WaiveCar/WaiveTelem/Hardware/7-23pinlist.xlsx

Sheet: pinlist
Pinlist
Exported from 001000-004.sch at 7/23/2019 9:50 AM
EAGLE Version 9.4.0 Copyright (c) 1988-2019 Autodesk | Inc.
Part | Pad | Pin | Dir | Net
C1 | 1 | 1 | io | GND
 | 2 | 2 | io | +12V
C2 | 1 | 1 | io | N$6
 | 2 | 2 | io | N$5
C3 | 1 | 1 | io | GND
 | 2 | 2 | io | N$7
C4 | 1 | 1 | io | GND
 | 2 | 2 | io | N$8
C5 | 1 | 1 | io | GND
 | 2 | 2 | io | N$11
C6 | 1 | 1 | io | GND
 | 2 | 2 | io | VIN
C7 | 1 | - | io | N$12
 | 2 | + | io | GND
C8 | 1 | 1 | io | GND
 | 2 | 2 | io | +3V3
C9 | 1 | 1 | io | GND
 | 2 | 2 | io | +3V8
C10 | 1 | 1 | io | GND
 | 2 | 2 | io | +12V
C11 | 1 | 1 | io | GND
 | 2 | 2 | io | VIN
C12 | 1 | 1 | io | GND
 | 2 | 2 | io | +12V
C13 | 1 | 1 | io | GND
 | 2 | 2 | io | +12V
C14 | 1 | 1 | io | GND
 | 2 | 2 | io | +3V8
C15 | 1 | 1 | io | GND
 | 2 | 2 | io | +3V8
C16 | 1 | 1 | io | GND
 | 2 | 2 | io | PA00_XIN32
C17 | 1 | 1 | io | GND
 | 2 | 2 | io | PA01_XOUT32
C18 | 1 | 1 | io | GND
 | 2 | 2 | io | +3V3
C19 | 1 | 1 | io | GND
 | 2 | 2 | io | +3V3
C20 | 1 | 1 | io | GND
 | 2 | 2 | io | N$1
C21 | 1 | 1 | io | GND
 | 2 | 2 | io | N$1
C22 | 1 | 1 | io | GND
 | 2 | 2 | io | +3V8
C23 | 1 | 1 | io | GND
 | 2 | 2 | io | +3V8
C24 | 1 | 1 | io | GND
 | 2 | 2 | io | +3V8
C25 | 1 | 1 | io | GND
 | 2 | 2 | io | +3V8
C26 | 1 | 1 | io | GND
 | 2 | 2 | io | +3V8
C27 | 1 | 1 | io | GND
 | 2 | 2 | io | SVCC
C28 | 1 | 1 | io | GND
 | 2 | 2 | io | +3V8
C29 | 1 | 1 | io | N$26
 | 2 | 2 | io | GND
C30 | 1 | 1 | io | +3V3
 | 2 | 2 | io | GND
C31 | 1 | 1 | io | GND
 | 2 | 2 | io | +3V3
C32 | 1 | 1 | io | GND
 | 2 | 2 | io | +3V3
C33 | 1 | 1 | io | GND
 | 2 | 2 | io | +3V3
C34 | 1 | 1 | io | GND
 | 2 | 2 | io | +3V3
C35 | 1 | 1 | io | VIN
 | 2 | 2 | io | GND
C36 | 1 | 1 | io | +3V3
 | 2 | 2 | io | GND
C37 | 1 | 1 | io | +3V3
 | 2 | 2 | io | GND
C38 | 1 | 1 | io | N$16
 | 2 | 2 | io | N$20
C39 | 1 | 1 | io | GND
 | 2 | 2 | io | +12V
C40 | 1 | 1 | io | GND
 | 2 | 2 | io | N$40
C41 | 1 | 1 | io | N$2
 | 2 | 2 | io | N$43
C42 | 1 | 1 | io | N$43
 | 2 | 2 | io | M_ANT_OUT
C43 | 1 | 1 | io | N$37
 | 2 | 2 | io | GND
C44 | 1 | 1 | io | +1V8
 | 2 | 2 | io | GND
C45 | 1 | 1 | io | GND
 | 2 | 2 | io | +3V3
C46 | 1 | 1 | io | GND
 | 2 | 2 | io | SRST
C47 | 1 | 1 | io | GND
 | 2 | 2 | io | SIO
C48 | 1 | 1 | io | GND
 | 2 | 2 | io | SCLK
C49 | 1 | 1 | io | GND
 | 2 | 2 | io | SVCC
C50 | 1 | 1 | io | +3V3
 | 2 | 2 | io | GND
C51 | 1 | 1 | io | RESETN
 | 2 | 2 | io | +3V3
C52 | 1 | 1 | io | +3V3
 | 2 | 2 | io | GND
C53 | 1 | 1 | io | +3V3
 | 2 | 2 | io | GND
C54 | 1 | 1 | io | GND
 | 2 | 2 | io | +3V3
D1 | 1 | K | io | N$6
 | 2 | A | io | GND
D2 | 1 | K | io | GND
 | 2 | A | io | SCLK
D3 | 1 | K | io | GND
 | 2 | A | io | SIO
D4 | 1 | K | io | GND
 | 2 | A | io | SRST
D5 | 1 | K | io | GND
 | 2 | A | io | CAN1L_OUT
D6 | 1 | K | io | GND
 | 2 | A | io | CAN1H_OUT
D7 | 1 | K | io | GND
 | 2 | A | io | CAN0L_OUT
D8 | 1 | K | io | GND
 | 2 | A | io | CAN0H_OUT
D9 | 1 | K | io | N$12
 | 2 | A | io | N$10
D10 | 1 | K | io | +3V3
 | 2 | A | io | N$19
D11 | 1 | K | io | +3V3
 | 2 | A | io | N$15
D12 | 1 | 1 | pas | N$37
 | 2 | 2 | pas | PA25_USB_P
 | 3 | 3 | pas | PA24_USB_N
 | 4 | 4 | pas | N$23
D13 | 1 | K | io | GND
 | 2 | A | io | SVCC
D14 | 1 | K | io | GND
 | 2 | A | io | SSW
F1 | 1 | 1 | io | +12V
 | 2 | 2 | io | 12V_OUT
F2 | 1 | 1 | io | +12V
 | 2 | 2 | io | 12V_IN
FB1 | 1 | 1 | io | +3V3
 | 2 | 2 | io | N$1
FB2 | 1 | 1 | io | UB_GPS_RX
 | 2 | 2 | io | PB22_S5_TX
FB3 | 1 | 1 | io | UB_GPS_TX
 | 2 | 2 | io | PB23_S5_RX
IC1 | 1 | PA00 | io | PA00_XIN32
 | 2 | PA01 | io | PA01_XOUT32
 | 3 | PA02 | io | PA02_C1_SS
 | 4 | PA03 | io | PA03_VREFA
 | 5 | GNDANA | io | GND
 | 6 | VDDANA | io | N$1
 | 7 | PB08 | io | PB08_M_RST
 | 8 | PB09 | io | PB09
 | 9 | PA04 | io | PA04_BT_RST
 | 10 | PA05 | io | PA05_AIN5_LOCK
 | 11 | PA06 | io | PA06_AIN6_UNLOCK
 | 12 | PA07 | io | PA07_C1_INT
 | 13 | PA08 | io | PA08_S0_I2C_SDA
 | 14 | PA09 | io | PA09_S0_I2C_SCL
 | 15 | PA10 | io | PA10_TCC0-W2_VIN
 | 16 | PA11 | io | PA11_C0_SS
 | 17 | VDDIO_1 | io | +3V3
 | 18 | GND_1 | io | GND
 | 19 | PB10 | io | PB10_SD_SS
 | 20 | PB11 | io | PB11_FL_SS
 | 21 | PA12 | io | PA12_S2_TX
 | 22 | PA13 | io | PA13_S2_RX
 | 23 | PA14 | io | PA14_IMM_OFF
 | 24 | PA15 | io | PA15_IMM_ON
 | 25 | PA16 | io | PA16_S1_MOSI
 | 26 | PA17 | io | PA17_S1_SCK
 | 27 | PA18 | io | PA18_OTG
 | 28 | PA19 | io | PA19_S1_MISO
 | 29 | PA20 | io | PA20_S2_MISO
 | 30 | PA21 | io | PA21_C0_INT
 | 31 | PA22 | io | PA22_S2_MOSI
 | 32 | PA23 | io | PA23_S2_SCK
 | 33 | PA24 | io | PA24_USB_N
 | 34 | PA25 | io | PA25_USB_P
 | 35 | GND_2 | io | GND
 | 36 | VDDIO_2 | io | +3V3
 | 37 | PB22 | io | PB22_S5_TX
 | 38 | PB23 | io | PB23_S5_RX
 | 39 | PA27 | io | PA27_GRST
 | 40 | !RESET | io | RESETN
 | 41 | PA28 | io | PA28_M_PWRON
 | 42 | GND_3 | io | GND
 | 43 | VDDCORE | io | N$26
 | 44 | VDDIN | io | +3V3
 | 45 | PA30 | io | PA30_SWCLK
 | 46 | PA31 | io | PA31_SWDIO
 | 47 | PB02 | io | PB02_BT_SS
 | 48 | PB03 | io | PB03_BT_IRQ
IC2 | 1 | GND_1 | io | GND
 | 2 | RSVD_1 | io | *** | unconnected | ***
 | 3 | GND_2 | io | GND
 | 4 | V_INT | io | +1V8
 | 5 | GND_3 | io | GND
 | 6 | RSR | io | *** | unconnected | ***
 | 7 | RI | io | MRI
 | 8 | DCD | io | N$24
 | 9 | DTR | io | MDTR
 | 10 | RTS | io | MRTS
 | 11 | CTS | io | MCTS
 | 12 | TXD | io | MTX
 | 13 | RXD | io | MRX
 | 14 | GND_4 | io | GND
 | 15 | PWR_ON | io | PWR_ON
 | 16 | GPIO1 | io | N$3
 | 17 | VUSB_DET | io | M_VUSB
 | 18 | RESET_N | io | MRST
 | 19 | GPIO6 | io | *** | unconnected | ***
 | 20 | GND_5 | io | GND
 | 21 | GND_6 | io | GND
 | 22 | GND_7 | io | GND
 | 23 | GPIO2 | io | *** | unconnected | ***
 | 24 | GPIO3 | io | *** | unconnected | ***
 | 25 | GPIO4 | io | *** | unconnected | ***
 | 26 | SDA | io | M_SDA
 | 27 | SCL | io | M_SCL
 | 28 | USB_D- | io | M_USB_N
 | 29 | USB_D+ | io | M_USB_P
 | 30 | GND_8 | io | GND
 | 31 | RSVD_2 | io | *** | unconnected | ***
 | 32 | GND_9 | io | GND
 | 33 | RSVD_3 | io | GND
 | 34 | I2S_WA_/_SPI_MOSI | io | *** | unconnected | ***
 | 35 | I2S_TXD_/_SPI_CS | io | *** | unconnected | ***
 | 36 | I2S_CLK_/_SPI_CLK | io | *** | unconnected | ***
 | 37 | I2S_RXD_/_SPI_MISO | io | *** | unconnected | ***
 | 38 | SIM_CLK | io | SCLK
 | 39 | SIM_IO | io | SIO
 | 40 | SIM_RST | io | SRST
 | 41 | VSIM | io | SVCC
 | 42 | GPIO5 | io | SIM_DET
 | 43 | GND_10 | io | GND
 | 44 | SDIO_D2 | io | *** | unconnected | ***
 | 45 | SDIO_CLK | io | *** | unconnected | ***
 | 46 | SDIO_CMD | io | *** | unconnected | ***
 | 47 | SDIO_D0 | io | *** | unconnected | ***
 | 48 | SDIO_D3 | io | *** | unconnected | ***
 | 49 | SDIO_D1 | io | *** | unconnected | ***
 | 50 | GND_11 | io | GND
 | 51 | VCC_1 | io | +3V8
 | 52 | VCC_2 | io | +3V8
 | 53 | VCC_3 | io | +3V8
 | 54 | GND_12 | io | GND
 | 55 | GND_13 | io | GND
 | 56 | ANT | io | N$2
 | 57 | GND_14 | io | GND
 | 58 | GND_15 | io | GND
 | 59 | GND_16 | io | GND
 | 60 | GND_17 | io | GND
 | 61 | GND_18 | io | GND
 | 62 | ANT_DET | io | *** | unconnected | ***
 | 63 | GND_19 | io | GND
 | 64 | GND_20 | io | GND
 | 65 | GND_21 | io | GND
 | 66 | GND_22 | io | GND
 | 67 | GND_23 | io | GND
 | 68 | GND_24 | io | GND
 | 69 | GND_25 | io | GND
 | 70 | GND_26 | io | GND
 | 71 | GND_27 | io | GND
 | 72 | GND_28 | io | GND
 | 73 | GND_29 | io | GND
 | 74 | GND_30 | io | GND
 | 75 | GND_31 | io | GND
 | 76 | GND_32 | io | GND
 | 77 | GND_33 | io | GND
 | 78 | GND_34 | io | GND
 | 79 | GND_35 | io | GND
 | 80 | GND_36 | io | GND
 | 81 | GND_37 | io | GND
 | 82 | GND_38 | io | GND
 | 83 | GND_39 | io | GND
 | 84 | GND_40 | io | GND
 | 85 | GND_41 | io | GND
 | 86 | GND_42 | io | GND
 | 87 | GND_43 | io | GND
 | 88 | GND_44 | io | GND
 | 89 | GND_45 | io | GND
 | 90 | GND_46 | io | GND
 | 91 | GND_47 | io | GND
 | 92 | GND_48 | io | GND
 | 93 | GND_49 | io | GND
 | 94 | GND_50 | io | GND
 | 95 | GND_51 | io | GND
 | 96 | GND_52 | io | GND
IC3 | 1 | VIN | io | +3V8
 | 2 | GND | io | GND
 | 3 | EN | io | *** | unconnected | ***
 | 4 | ADJ/NC | io | *** | unconnected | ***
 | 5 | VOUT | io | +3V3
IC4 | 1 | BOOT | io | N$5
 | 2 | VIN | in | +12V
 | 3 | EN | io | N$13
 | 4 | SS | out | N$11
 | 5 | VSENSE | io | N$9
 | 6 | COMP | out | N$7
 | 7 | GND | pwr | GND
 | 8 | PH | io | N$6
IC5 | 1 | VIN | io | +12V
 | 2 | SW | io | N$16
 | 3 | GND | io | GND
 | 4 | BST | io | N$20
 | 5 | EN | io | +12V
 | 6 | FB | io | N$18
IC6 | 1 | NC_1 | io | *** | unconnected | ***
 | 2 | NC_2 | io | *** | unconnected | ***
 | 3 | NC_3 | io | *** | unconnected | ***
 | 4 | GND | io | GND
 | 5 | SDA | io | PA08_S0_I2C_SDA
 | 6 | SCL | io | PA09_S0_I2C_SCL
 | 7 | NC_4 | io | *** | unconnected | ***
 | 8 | VCC | io | +3V3
 | 9 | EP | io | *** | unconnected | ***
IC7 | 1 | EXT_LPCLK | in | *** | unconnected | ***
 | 2 | GPIO2 | io | *** | unconnected | ***
 | 3 | ANATEST0 | in | *** | unconnected | ***
 | 4 | SPI_IRQ | out | PB03_BT_IRQ
 | 5 | VIN | pwr | +3V3
 | 6 | GND | pwr | GND
 | 7 | SPI_CLK | in | PA23_S2_SCK
 | 8 | SPI_MISO | out | PA20_S2_MISO
 | 9 | SPI_MOSI | in | PA22_S2_MOSI
 | 10 | SPI_CS | in | PB02_BT_SS
 | 11 | BT_RESET | in | PA04_BT_RST
IC8 | 1 | !CS | io | PB11_FL_SS
 | 2 | DO_(IO1) | io | PA19_S1_MISO
 | 3 | IO2 | io | +3V3
 | 4 | GND | io | GND
 | 5 | DI_(IO0) | io | PA16_S1_MOSI
 | 6 | CLK | io | PA17_S1_SCK
 | 7 | IO3 | io | +3V3
 | 8 | VCC | io | +3V3
 | 9 | EP | io | GND
IC9 | 1 | TXD1 | io | TXCAN0
 | 2 | GNDA | io | GND
 | 3 | VCC | io | VIN
 | 4 | RXD1 | io | RXCAN0
 | 5 | GNDB | io | GND
 | 6 | TXD2 | io | TXCAN1
 | 7 | RXD2 | io | RXCAN1
 | 8 | STBN2 | io | N$34
 | 9 | CANL2 | io | CAN1L_OUT
 | 10 | CANH2 | io | CAN1H_OUT
 | 11 | VIO | io | +3V3
 | 12 | CANL1 | io | CAN0L_OUT
 | 13 | CANH1 | io | CAN0H_OUT
 | 14 | STBN1 | io | N$31
 | 15 | EP | io | *** | unconnected | ***
IC10 | 1 | TXCAN | io | TXCAN0
 | 2 | RXCAN | io | RXCAN0
 | 3 | CLKOUT/SOF | io | *** | unconnected | ***
 | 4 | !TX0RTS | io | *** | unconnected | ***
 | 5 | !TX1RTS | io | *** | unconnected | ***
 | 6 | NC_1 | io | *** | unconnected | ***
 | 7 | !TX2RTS | io | *** | unconnected | ***
 | 8 | OSC2 | io | N$30
 | 9 | OSC1 | io | N$27
 | 10 | VSS | io | GND
 | 11 | !RX1BF | io | *** | unconnected | ***
 | 12 | !RX0BF | io | *** | unconnected | ***
 | 13 | !INT | io | PA21_C0_INT
 | 14 | SCK | io | PA17_S1_SCK
 | 15 | NC_2 | io | *** | unconnected | ***
 | 16 | SI | io | PA16_S1_MOSI
 | 17 | SO | io | PA19_S1_MISO
 | 18 | !CS | io | PA11_C0_SS
 | 19 | !RESET | io | N$42
 | 20 | VDD | io | +3V3
IC11 | 1 | TXCAN | io | TXCAN1
 | 2 | RXCAN | io | RXCAN1
 | 3 | CLKOUT/SOF | io | *** | unconnected | ***
 | 4 | !TX0RTS | io | *** | unconnected | ***
 | 5 | !TX1RTS | io | *** | unconnected | ***
 | 6 | NC_1 | io | *** | unconnected | ***
 | 7 | !TX2RTS | io | *** | unconnected | ***
 | 8 | OSC2 | io | N$33
 | 9 | OSC1 | io | N$32
 | 10 | VSS | io | GND
 | 11 | !RX1BF | io | *** | unconnected | ***
 | 12 | !RX0BF | io | *** | unconnected | ***
 | 13 | !INT | io | PA07_C1_INT
 | 14 | SCK | io | PA17_S1_SCK
 | 15 | NC_2 | io | *** | unconnected | ***
 | 16 | SI | io | PA16_S1_MOSI
 | 17 | SO | io | PA19_S1_MISO
 | 18 | !CS | io | PA02_C1_SS
 | 19 | !RESET | io | N$39
 | 20 | VDD | io | +3V3
IC12 | 1 | 1 | io | N$27
 | 2 | 2 | io | GND
 | 3 | 3 | io | N$30
IC13 | 1 | 1 | io | N$32
 | 2 | 2 | io | GND
 | 3 | 3 | io | N$33
J1 | 1 | C1 | io | SVCC
 | 2 | C2 | io | SRST
 | 3 | C3 | io | SCLK
 | 4 | C5 | io | GND
 | 5 | C6 | io | *** | unconnected | ***
 | 6 | C7 | io | SIO
 | 7 | HD3 | io | GND
 | 8 | DSW2 | io | SSW
 | 9 | HD2_DSW1 | io | GND
 | 10 | HD1 | io | GND
 | 11 | HD4 | io | GND
J2 | 1 | DAT2 | io | *** | unconnected | ***
 | 2 | CD/DAT3 | io | PB10_SD_SS
 | 3 | CMD | io | PA16_S1_MOSI
 | 4 | VDD | io | +3V3
 | 5 | CLK | io | PA17_S1_SCK
 | 6 | VSS | io | GND
 | 7 | DAT0 | io | PA19_S1_MISO
 | 8 | DAT1 | io | *** | unconnected | ***
J3 | 1 | 1 | io | GND
 | 2 | 2 | io | GND
 | 3 | 3 | io | GND
 | 4 | 4 | io | GND
 | 5 | 5 | io | GPS_ANT
J4 | 1 | 1 | io | GND
 | 2 | 2 | io | CAN0L_OUT
 | 3 | 3 | io | CAN1L_OUT
 | 4 | 4 | io | CODE_A_OUT
 | 5 | 5 | io | CODE_B_OUT
 | 6 | 6 | io | GND
 | 7 | 7 | io | UNLOCK_OUT
 | 8 | 8 | io | 12V_IN
 | 9 | 9 | io | CAN0H_OUT
 | 10 | 10 | io | CAN1H_OUT
 | 11 | 11 | io | CODE_A_IN
 | 12 | 12 | io | CODE_B_IN
 | 13 | 13 | io | 12V_OUT
 | 14 | 14 | io | LOCK_OUT
J5 | 1 | 1 | pas | N$23
 | 2 | 2 | pas | PA24_USB_N
 | 3 | 3 | pas | PA25_USB_P
 | 4 | 4 | pas | PA18_OTG
 | 5 | 5 | pas | GND
 | 6 | SH | pas | N$37
 | 7 | SH | pas | N$37
 | 8 | SH | pas | N$37
 | 9 | SH | pas | N$37
 | 10 | SH | pas | N$37
 | 11 | SH | pas | N$37
J6 | 1 | 1 | io | GND
 | 2 | 2 | io | GND
 | 3 | 3 | io | GND
 | 4 | 4 | io | GND
 | 5 | 5 | io | M_ANT_OUT
J7 | 1 | 1 | io | +3V3
 | 2 | 2 | io | PA31_SWDIO
 | 3 | 3 | io | GND
 | 4 | 4 | io | PA30_SWCLK
 | 5 | 5 | io | GND
 | 6 | 6 | io | *** | unconnected | ***
 | 7 | 7 | io | *** | unconnected | ***
 | 8 | 8 | io | *** | unconnected | ***
 | 9 | 9 | io | GND
 | 10 | 10 | io | N$21
K1 | 1 | SET_COIL_+ | io | +3V3
 | 3 | NC_1 | io | *** | unconnected | ***
 | 4 | COM_1 | io | CODE_A_IN
 | 5 | NO_1 | io | CODE_A_OUT
 | 6 | RESET_COIL_+ | io | +3V3
 | 7 | RESET_COIL_- | io | N$15
 | 8 | NO_2 | io | *** | unconnected | ***
 | 9 | COM_2 | io | CODE_B_IN
 | 10 | NC_2 | io | CODE_B_OUT
 | 12 | SET_COIL_- | io | N$19
L1 | 1 | 1 | io | N$6
 | 2 | 2 | io | VIN
L2 | 1 | 1 | io | N$16
 | 2 | 2 | io | +3V8
L3 | 1 | 1 | io | N$40
 | 2 | 2 | io | GPS_ANT
L4 | 1 | 1 | io | GND
 | 2 | 2 | io | N$43
LED1 | 1 | K | io | GND
 | 2 | A | io | N$4
LED3 | 1 | K | io | GND
 | 2 | A | io | N$22
LED4 | 1 | K | io | N$36
 | 2 | A | io | N$35
Q1 | 1 | S1 | io | GND
 | 2 | G1 | in | PA15_IMM_ON
 | 3 | D2 | io | N$15
 | 4 | S2 | io | GND
 | 5 | G2 | in | PA14_IMM_OFF
 | 6 | D1 | io | N$19
Q2 | 1 | 1 | io | PA27_GRST
 | 2 | 2 | io | GND
 | 3 | 3 | io | GRST
Q3 | 1 | 1 | io | SSW
 | 2 | 2 | io | GND
 | 3 | 3 | io | SIM_DET
Q4 | 1 | S1 | io | GND
 | 2 | G1 | in | PA28_M_PWRON
 | 3 | D2 | io | MRST
 | 4 | S2 | io | GND
 | 5 | G2 | in | PB08_M_RST
 | 6 | D1 | io | PWR_ON
Q5 | 1 | IN | in | PA05_AIN5_LOCK
 | 2 | D_1 | pwr | N$29
 | 3 | S | pwr | GND
 | 4 | D_2 | pwr | N$29
Q6 | 1 | IN | in | PA06_AIN6_UNLOCK
 | 2 | D_1 | pwr | N$28
 | 3 | S | pwr | GND
 | 4 | D_2 | pwr | N$28
R1 | 1 | 1 | io | N$9
 | 2 | 2 | io | VIN
R2 | 1 | 1 | io | GND
 | 2 | 2 | io | N$9
R3 | 1 | 1 | io | N$8
 | 2 | 2 | io | N$7
R4 | 1 | 1 | io | N$10
 | 2 | 2 | io | +3V3
R5 | 1 | 1 | io | GPS_BCKP
 | 2 | 2 | io | N$12
R6 | 1 | 1 | io | GND
 | 2 | 2 | io | PA27_GRST
R7 | 1 | 1 | io | GND
 | 2 | 2 | io | N$13
R8 | 1 | 1 | io | N$13
 | 2 | 2 | io | +12V
R9 | 1 | 1 | io | N$18
 | 2 | 2 | io | +3V8
R10 | 1 | 1 | io | GND
 | 2 | 2 | io | N$18
R11 | 1 | 1 | io | GND
 | 2 | 2 | io | PA15_IMM_ON
R12 | 1 | 1 | io | GND
 | 2 | 2 | io | PA14_IMM_OFF
R13 | 1 | 1 | io | N$40
 | 2 | 2 | io | N$38
R14 | 1 | 1 | io | MDTR
 | 2 | 2 | io | GND
R15 | 1 | 1 | io | N$22
 | 2 | 2 | io | N$3
R16 | 1 | 1 | io | SSW
 | 2 | 2 | io | +1V8
R17 | 1 | 1 | io | SIM_DET
 | 2 | 2 | io | +1V8
R18 | 1 | 1 | io | GND
 | 2 | 2 | io | PA28_M_PWRON
R19 | 1 | 1 | io | GND
 | 2 | 2 | io | PB08_M_RST
R20 | 1 | 1 | io | N$29
 | 2 | 2 | io | LOCK_OUT
R21 | 1 | 1 | io | N$28
 | 2 | 2 | io | UNLOCK_OUT
R22 | 1 | 1 | io | PB11_FL_SS
 | 2 | 2 | io | +3V3
R23 | 1 | 1 | io | PB10_SD_SS
 | 2 | 2 | io | +3V3
R24 | 1 | 1 | io | PA02_C1_SS
 | 2 | 2 | io | +3V3
R25 | 1 | 1 | io | N$39
 | 2 | 2 | io | +3V3
R26 | 1 | 1 | io | PA11_C0_SS
 | 2 | 2 | io | +3V3
R27 | 1 | 1 | io | N$42
 | 2 | 2 | io | +3V3
R28 | 1 | 1 | io | PA21_C0_INT
 | 2 | 2 | io | +3V3
R29 | 1 | 1 | io | PA07_C1_INT
 | 2 | 2 | io | +3V3
R30 | 1 | 1 | io | N$31
 | 2 | 2 | io | +3V3
R31 | 1 | 1 | io | N$34
 | 2 | 2 | io | +3V3
R32 | 1 | 1 | io | N$36
 | 2 | 2 | io | +3V3
R33 | 1 | 1 | io | GND
 | 2 | 2 | io | N$37
R34 | 1 | 1 | io | MCTS
 | 2 | 2 | io | MRTS
R35 | 1 | 1 | io | PA10_TCC0-W2_VIN
 | 2 | 2 | io | +12V
R36 | 1 | 1 | io | GND
 | 2 | 2 | io | PA10_TCC0-W2_VIN
R37 | 1 | 1 | pas | M_SDA
 | 2 | 2 | pas | G_SDA
R38 | 1 | 1 | pas | M_SCL
 | 2 | 2 | pas | G_SCL
R39 | 1 | 1 | io | N$21
 | 2 | 2 | io | RESETN
R40 | 1 | 1 | io | RESETN
 | 2 | 2 | io | +3V3
R41 | 1 | 1 | io | N$4
 | 2 | 2 | io | PB09
S1 | 1 | 1 | io | GND
 | 2 | 2 | io | RESETN
 | 3 | CHASSIS_PCB_PAD_1 | io | GND
 | 4 | CHASSIS_PCB_PAD_2 | io | GND
TP3V3 | TP | TP | in | +3V3
TP3V8 | TP | TP | in | +3V8
TP5V | TP | TP | in | VIN
TP_1V8 | TP | TP | in | +1V8
TP_MDCD | TP | TP | in | N$24
TP_MPWR_ON | TP | TP | in | PWR_ON
TP_MRST | TP | TP | in | MRST
TP_MRX | TP | TP | in | MRX
TP_MTX | TP | TP | in | MTX
TP_MUSBN | TP | TP | in | M_USB_N
TP_MUSBP | TP | TP | in | M_USB_P
TP_MVUSB | TP | TP | in | M_VUSB
U$1 | 1_GND | 1_GND | pwr | GND
 | 2_TXD | 2_TXD | io | UB_GPS_TX
 | 3_RXD | 3_RXD | io | UB_GPS_RX
 | 8_VCC | 8_VCC | pwr | +3V3
 | 10_GND | 10_GND | pwr | GND
 | 12_GND | 12_GND | pwr | GND
 | 16_SDA | 16_SDA | io | G_SDA
 | 17_SCL | 17_SCL | io | G_SCL
 | 11_RF_IN | 11_RF_IN | io | GPS_ANT
 | 13_LNA_EN | 13_LNA_EN/RES | io | *** | unconnected | ***
 | 14_VCC_RF | 14_VCC_RF | io | N$38
 | 15_V_ANT/ | RESERVED | 15_RES/V_ANT | io | *** | unconnected | ***
 | 18_SAFEBO | OT_N | 18_SAFEBOOT_N | io | *** | unconnected | ***
 | 4_TIMEPUL | SE | 4_TIMEPULSE | io | N$35
 | 5_EXTINT | 5_EXTINT | io | *** | unconnected | ***
 | 6_V_BCKP | 6_V_BCKP | io | GPS_BCKP
 | 7_VCC_IO | 7_VCC_IO | pwr | +3V3
 | 9_RESET_N | 9_V_RESET_N | pwr | GRST
U1 | 1 | DIR2 | io | GND
 | 2 | !OE2 | io | GND
 | 3 | GND | pwr | GND
 | 4 | B2 | io | MRX
 | 5 | B1 | io | MTX
 | 6 | VCCB | pwr | +1V8
 | 7 | VCCA | pwr | +3V3
 | 8 | A1 | io | PA12_S2_TX
 | 9 | A2 | io | PA13_S2_RX
 | 10 | DIR1 | io | +3V3
Y1 | 1 | 1 | io | PA01_XOUT32
 | 2 | 2 | io | PA00_XIN32

Sheet: D21G18 Pinlist
Aname if any | Program Pin Def # | Pin | PinName |  | NetName | variable/ plain text | MKRname | MKRNB1500 proto pin | same? | Pins.h check | notes
 | 33 | 1 | PA00 | io | PA00_XIN32 | oscillator |  | oscillator | 1
 | 34 | 2 | PA01 | io | PA01_XOUT32 | oscillator |  | oscillator | 1
A0 | 15 | 3 | PA02 | io | PA02_C1_SS | CAN1_CS_PIN | A0 | CAN1_CS_PIN | 1 | 1
 | 25 | 4 | PA03 | io | PA03_VREFA | unconnected | AREF | unconnected | 1
 |  | 5 | GNDANA | io | GND | GND |  | GND | 1
 |  | 6 | VDDANA | io | N$1 | filtered +3V3 |  | filtered +3v3 | 1
 | 31 | 7 | PB08 | io | PB08_M_RST | modem reset |  | modem reset | 1
 | 32 | 8 | PB09 | io | PB09 | LED_PIN | Vbatsense | Vbatsense | 0 |  | LED pin for mkrnb1500 is null, LED_pin for mkr1000 is PA20/D6
A3 | 18 | 9 | PA04 | io | PA04_BT_RST | BLE_RST_PIN | A3 | BLE_RST_PIN | 1 | 1
A4 | 19 | 10 | PA05 | io | PA05_AIN5_LOCK | DOOR_LOCK_PIN | A4 | DOOR_LOCK_PIN | 1 | 1
A5 | 20 | 11 | PA06 | io | PA06_AIN6_UNLOCK | DOOR_UNLOCK_PIN | A5 | DOOR_UNLOCK_PIN | 1 | 1
A6 | 21 | 12 | PA07 | io | PA07_C1_INT | CAN1_INT_PIN | A6 | CAN1_INT_PIN | 1 | 1
 | 11 | 13 | PA08 | io | PA08_S0_I2C_SDA | crypto SDA | D11/SDA | crypto SDA | 1
 | 12 | 14 | PA09 | io | PA09_S0_I2C_SCL | crpyto SCL | D12/SCL | crypto SCL | 1
 | 2 | 15 | PA10 | io | PA10_TCC0-W2_VIN | Vin measurement | D2 | RELAY_2_PIN | 0 |  | needs to be setup as analog
 | 3 | 16 | PA11 | io | PA11_C0_SS | CAN0_CS_PIN | D3 | CAN0_CS_PIN | 1 | 1
 |  | 17 | VDDIO_1 | io | +3V3 | 3V3 |  | 3V3 | 1
 |  | 18 | GND_1 | io | GND | GND |  | GND | 1
 | 4 | 19 | PB10 | io | PB10_SD_SS | SD_CS_PIN | D4 | SD_CS_PIN | 1 | 1
 | 5 | 20 | PB11 | io | PB11_FL_SS | FL_CS_PIN | D5 | FL_CS_PIN | 1 | 1
 | 26 | 21 | PA12 | io | PA12_S2_TX | modem tx |  | modem tx | 1
 | 27 | 22 | PA13 | io | PA13_S2_RX | modem rx |  | modem rx | 1
 | 28 | 23 | PA14 | io | PA14_IMM_OFF | Immobilizer Off |  | modem rts | 0 |  | rts not supported by our modem model
 | 29 | 24 | PA15 | io | PA15_IMM_ON | immobilizer on |  | modem cts | 0 |  | cts not supported by our modem model
 | 8 | 25 | PA16 | io | PA16_S1_MOSI | MOSI for SD, Flash, CAN0/1 | D8/MOSI | MOSI for SD, Flash, CAN0, CAN1 | 1 | 1
 | 9 | 26 | PA17 | io | PA17_S1_SCK | SCK for SD, Flash, CAN0/1 | D9/SCK | SCK for SD, Flash, CAN0/1 | 1 | 1
 | 24 | 27 | PA18 | io | PA18_OTG | usb connector OTG |  | usb connector otg and battery charger IC otg | 1/0 |  | still usb connector otg, no battery charger ic
 | 10 | 28 | PA19 | io | PA19_S1_MISO | MISO for SD, Flash, CAN0/1 | D10/MISO | MISO for SD, Flash, CAN0/1 | 1 | 1
 | 6 | 29 | PA20 | io | PA20_S2_MISO | BLE_MISO_PIN | D6 | BLE_MISO_PIN | 1 | 1
 | 7 | 30 | PA21 | io | PA21_C0_INT | CAN0_INT_PIN | D7 | CAN0_INT_PIN | 1 | 1
 | 0 | 31 | PA22 | io | PA22_S2_MOSI | BLE_MOSI_PIN | D0 | BLE_MOSI_PIN | 1 | 1
 | 1 | 32 | PA23 | io | PA23_S2_SCK | BLE_SCK_PIN | D1 | BLE_SCK_PIN | 1 | 1
 | 22 | 33 | PA24 | io | PA24_USB_N | usb connector N |  | usb connector N | 1
 | 23 | 34 | PA25 | io | PA25_USB_P | usb connector P |  | usb connector P | 1
 |  | 35 | GND_2 | io | GND | GND |  | GND | 1
 |  | 36 | VDDIO_2 | io | +3V3 | 3v3 |  | 3V3 | 1
 | 14 | 37 | PB22 | io | PB22_S5_TX | to GPS RX | D14/TX | to GPS RX | 1
 | 13 | 38 | PB23 | io | PB23_S5_RX | to GPS TX | D13/RX | to GPS TX | 1
 | 30 | 39 | PA27 | io | PA27_GRST | to GPS reset |  | to battery charger INT | 0
 |  | 40 | !RESET | io | RESETN | SWD header and reset button |  | SWD header and reset button | 1
 | 35 | 41 | PA28 | io | PA28_M_PWRON | modem power on |  | modem power on | 1
 |  | 42 | GND_3 | io | GND | GND |  | GND | 1
 |  | 43 | VDDCORE | io | N$26 | 3v3 |  | 3v3 | 1
 |  | 44 | VDDIN | io | +3V3 | 3v3 |  | 3v3 | 1
 |  | 45 | PA30 | io | PA30_SWCLK | SWD header |  | SWD header | 1
 |  | 46 | PA31 | io | PA31_SWDIO | SWD header |  | SWD header | 1
A1 | 16 | 47 | PB02 | io | PB02_BT_SS | BLE_CS_PIN | A1 | BLE_CS_PIN | 1 | 1
A2 | 17 | 48 | PB03 | io | PB03_BT_IRQ | BLE_INT_PIN | A2 | BLE_INT_PIN | 1 | 1

Sheet: Differences
Differences between MKR Proto and 001000-004
Category | Item | Was | IS | Effect?
Pin Differences | PB09 | Vbat sense | BuiltinLED | need to specify in the bootloader that this is the LED pin. Stripout all the relevant battery charger code.
 | PA10 | Immo 2 pin | Vin Sense | Need to setup the pin as an anolog read rather than digital
 | PA14 | modem rts | immo on | need to setup the pin as a digital write
 | PA15 | modem cts | immo off | need to setup the pin as a digital write
 | PA18 | usb + batt charger OTG | usb OTG | need to strip out the relevant battery charger code
 | PA27 | bat charger int | GPS reset | need to strip out relevant battery charger code, GPS reset needs to be set as digital out
Component Differences | GPS Module | bluefruit SPI gps | MAX-M8q gps | should still be able to use tinygps++ but will have to test
 | BLE module | SBTLE-RF | SBTLE-RF0 | I don't know maybe none but if there's weird behavior this might be the reason
