WaiveCar/WaiveTelem/Hardware/001000-004BOM627formatted.xlsx

BOM: WaiveTelem
Assembly Part Number/Revision: 001000-004/1
Customer / Company Name: Waive
Item Number | Quantity per Board | MANUFACTURER_PART_NUMBER | DNI | Reference Designators | Value | Device | Package | Description | MANUFACTURER_NAME
1 | 1 | ZX62-AB-5PA(31) |  | J5 | - | USB-MICRO | ZX62-AB-5PA | USB - micro AB USB 2.0 Receptacle Connector 5 Position Surface Mount, Right Angle, Horizontal | Hirose
2 | 2 | CRG1206ZR |  | R20, R21 | 0R | CRG1206ZR | RESC3116X65N | CRG1206 Surface mount chip resistor, 0R0 TE Connectivity CRG1206 Series Thick Film Surface Mount Resistor 1206 Case 0 +/-1% 0.25W | TE Connectivity
3 | 3 | RMCF0402ZT0R00 |  | R5, R14, R34 | 0R | RMCF0402ZT0R00 | RESC1005X40N | General Purpose Thick Film Surface Mount Chip Resistor | Stackpole Electronics Inc.
4 | 17 | GCM155R71C104KA55J |  | C2, C18, C19, C21, C24, C27, C30, C31, C33, C34, C35, C38, C44, C45, C52, C53, C54 | 100n | GCM155R71C104KA55J | CAPC1005X55N | Multilayer Ceramic Capacitors MLCC - SMD/SMT 0.1uF 16Volts X7R 10% | Murata Electronics
5 | 1 | GRM31CD80J107ME39K |  | C22 | 100u | GRM31CD80J107ME39K | CAPC3216X180N | Multilayer Ceramic Capacitors MLCC - SMD/SMT 1206 100uF 6.3volts *Derate Voltage/Temp | Murata Electronics
6 | 1 | 1040310811 |  | J2 | 1040310811 | 1040310811 | 1040310811 | MICRO SD card socket, push-pull 1.42H Normal type | Molex
7 | 1 | CRGCQ0402F10R |  | R13 | 10R | CRGCQ0402F10R | RESC1005X35N | Thick Film Resistors - SMD CRGCQ 0402 10R 1% SMD Resistor | TE Connectivity / Holsworthy
8 | 1 | RNCP0603FTD10K0 |  | R4 | 10k | RNCP0603FTD10K0 | RESC1508X50N | Res Thin Film 0603 10K Ohm 1% 0.125W(1/8W) +/-100ppm/C Sulfur Resistant Pad SMD T/R | Stackpole Electronics Inc.
9 | 15 | CRCW040210K2FKED |  | R1, R15, R22, R23, R24, R25, R26, R27, R28, R29, R30, R31, R36, R40, R41 | 10k2 | CRCW040210K2FKED | RESC1005X40N | CRCW0402 Resistor T/R 0.063W,1%,10K2 Vishay CRCW Series Thick Film Surface Mount Resistor 0402 Case 10.2k +/-1% 0.063W +/-100ppm/C | Vishay
10 | 2 | GCM155R71H103KA55D |  | C25, C40 | 10n | GCM155R71H103KA55D | CAPC1005X55N | Ceramic SMT capacitor 10nF 50Vdc | Murata Electronics
11 | 1 | GCM1555C1H100JA16D |  | C3 | 10p | GCM1555C1H100JA16D | CAPC1005X55N | Multilayer Ceramic Capacitors MLCC - SMD/SMT 0402 10pF 50volts C0G 5% | Murata Electronics
12 | 1 | GRM155C80J106ME11D |  | C32 | 10u | GRM155C80J106ME11D | CAPC1005X55N | Multilayer Ceramic Capacitors MLCC - SMD/SMT 0402 10uF 6.3volts *Derate Voltage/Temp | Murata Electronics
13 | 3 | GRM188R60J106KE47D |  | C20, C23, C50 | 10u | GRM188R60J106KE47D | CAPC1608X90N | MURATA - GRM188R60J106KE47D - CAP, MLCC, X5R, 10UF, 6.3V, 0603 | Murata Electronics
14 | 2 | GRM21BC81C106KE15L |  | C6, C11 | 10u | GRM21BC81C106KE15L | CAPC2012X145N | Capacitor SMD 0805 10uF Murata 0805 GRM 10uF Ceramic Multilayer Capacitor, 16 V dc, +105C, X6S Dielectric, +/-10% SMD | Murata Electronics
15 | 1 | GCM1555C1H150JA16D |  | C28 | 15p | GCM1555C1H150JA16D | CAPC1005X55N | Multilayer Ceramic Capacitors MLCC - SMD/SMT 0402 15pF 50volts C0G 5% | Murata Electronics
16 | 8 | CRCW04021M20FKED |  | R6, R11, R12, R16, R17, R18, R19, R33 | 1M2 | CRCW04021M20FKED | RESC1005X40N | Vishay CRCW Series Thick Film Surface Mount Resistor 402 Case 1.2M +/-1% 0.063W +/-100ppm/C | Vishay
17 | 1 | CRCW04021K96FKED |  | R2 | 1k96 | CRCW04021K96FKED | RESC1005X40N | Vishay CRCW Series Thick Film Surface Mount Resistor 0402 Case 1.96k +/-1% 0.063W +/-100ppm/C | Vishay
18 | 3 | GRM155R61C105MA12D |  | C8, C9, C29 | 1u | GRM155R61C105MA12D | CAPC1005X55N | Multilayer Ceramic Capacitors MLCC - SMD/SMT 0402 1uF 16volts X5R 20% | Murata Electronics
19 | 1 | GRT188C8YA105KE13D |  | C37 | 1u | GRT188C8YA105KE13D | CAPC1608X90N | Multilayer Ceramic Capacitors MLCC - SMD/SMT 0603 35Vdc 1.0uF X6S 10% | Murata Electronics
20 | 2 | GJM1555C1H200GB01D |  | C16, C17 | 20p | GJM1555C1H200GB01D | CAPC1005X55N | Multilayer Ceramic Capacitors MLCC - SMD/SMT 0402 20pF 50Volts C0G 2% | Murata Electronics
21 | 1 | L-14C27NJV4T |  | L3 | 27nH | L-14C27NJV4T | INDC1608X95N | Inductor RF Chip Multi-Layer 27nH 5% 100MHz 10Q-Factor Ceramic 300mA 600mOhm DCR 0603 T/R | JOHANSON TECHNOLOGY
22 | 1 | CRCW040228K0FKED |  | R3 | 28k | CRCW040228K0FKED | RESC1005X40N | Vishay CRCW Series Thick Film Surface Mount Resistor 0402 Case 28k +/-1% 0.063W +/-100ppm/C | Vishay
23 | 2 | 2N7002,215 |  | Q2, Q3 | 2N7002,215 | 2N7002,215 | SOT95P230X110-3N | MOSFET N-Channel 60V 0.3A TO236AB NXP 2N7002,215 N-channel MOSFET Transistor, 0.3 A, 60 V, 3-Pin TO-236AB | Nexperia
24 | 2 | 2N7002DW-7-F |  | Q1, Q4 | 2N7002DW-7-F | 2N7002DW-7-F | SOT65P210X100-6N | Diodes Inc 2N7002DW-7-F Dual N-channel MOSFET, 115 mA, 60 V, 6-Pin SOT-363 | Diodes Inc.
25 | 1 | GRM155R71H222KA01D |  | C4 | 2n2 | GRM155R71H222KA01D | CAPC1005X55N | Murata 0402 GRM 2.2nF Ceramic Multilayer Capacitor, 50 V dc, +125C, X7R Dielectric, +/-10% | Murata Electronics
26 | 1 | CRCW040239R0FKEDHP |  | R39 | 39R | CRCW040239R0FKEDHP | RESC1005X40N | Thick Film Resistors - SMD 0.2W 39ohms 1% High Power AEC-Q200 | Vishay
27 | 1 | CRCW040240K2FKED |  | R35 | 40k2 | CRCW040240K2FKED | RESC1005X40N | CRCW0402 Resistor T/R 0.063W,1%,40K2 Vishay CRCW Series Thick Film Surface Mount Resistor 0402 Case 40.2k +/-1% 0.063W +/-100ppm/C | Vishay
28 | 1 | 43045-1400 |  | J4 | 43045-1400 | 43045-1400 | 43045-1400 | 14 way microfit 3mm dual row r/a header Molex MICRO-FIT 3.0 Series, Series Number 43045, 3mm Pitch 14 Way 2 Row Shrouded Right Angle PCB Header, Through Hole | Molex
29 | 1 | CRGCQ0402J470R |  | R32 | 470R | CRGCQ0402J470R | RESC1005X35N | Thick Film Resistors - SMD CRGCQ 0402 470R 5% SMD Resistor | TE Connectivity / Holsworthy
30 | 1 | GRM155R71H472KA01J |  | C43 | 4n7 | GRM155R71H472KA01J | CAPC1005X55N | Multilayer Ceramic Capacitors MLCC - SMD/SMT 0.0047uF 50volts 10% | Murata Electronics
31 | 1 | GCM1555C1H680JA16D |  | C26 | 68p | GCM1555C1H680JA16D | CAPC1005X55N | Multilayer Ceramic Capacitors MLCC - SMD/SMT 0402 68pF 50volts C0G 5% | Murata Electronics
32 | 1 | GRM155R71C822KA01D |  | C5 | 8n2 | GRM155R71C822KA01D | CAPC1005X55N | Chip Capacitor value VALUE1 | Murata Electronics
33 | 1 | ABS07-32.768KHz-1-T |  | Y1 | ABS07-32.768KHZ-1-T | ABS07-32.768KHZ-1-T | ABS0716632768KHZT | Abracon 32.768kHz Crystal Unit +/-10ppm SMD 2-Pin 3.2 x 1.5 x 0.9mm | ABRACON
34 | 1 | AP2112K-3.3TRG1 |  | IC3 | AP2112K-3.3TRG1 | AP2112K-3.3TRG1 | SOT95P282X130-5N | 600mA 3.3V LDO Regulator Enable SOT23-5 DiodesZetex AP2112K-3.3TRG1, LDO Voltage Regulator, 3.3 V +/-1.5%, 2.5 6 Vin, 5-Pin SOT-23 | Diodes Inc.
35 | 1 | ATECC508A-MAHDA-T |  | IC6 | ATECC508A-MAHDA-T | ATECC508A-MAHDA-T | SON50P300X200X60-9N | Microchip ATECC508A-MAHDA-T 10kb 8-Pin Crypto Authentication IC UDFN | Microchip
36 | 1 | ATSAMD21G18A-AU |  | IC1 | ATSAMD21G18A-AU | ATSAMD21G18A-AU | QFP50P900X900X120-48N | ATMEL - ATSAMD21G18A-AU - MCU, 32BIT, CORTEX-M0+, 48MHZ, TQFP-48 | Microchip
37 | 1 | BAT60AE6327HTSA1 |  | D9 | BAT60AE6327HTSA1 | BAT60AE6327HTSA1 | SOD2513X110N | INFINEON - BAT60AE6327HTSA1 - RECTIFIER, SCHOTTKY, 3A, 10V, SOD-323 | Infineon
38 | 2 | BLM15HD102SN1D |  | FB2, FB3 | BLM15HD102SN1D | BLM15HD102SN1D | BEADC1005X55N | MURATA - BLM15HD102SN1D - FERRITE BEAD, 1.25OHM, 250MA, 0402 | Murata Electronics
39 | 1 | BLM18PG471SZ1D |  | FB1 | BLM18PG471SZ1D | BLM18PG471SZ1D | BEADC1608X95N | Ferrite Beads 0603 470ohms 1000mA Auto Infotainment | Murata Electronics
40 | 2 | BSP76E6433HUMA1 |  | Q5, Q6 | BSP76E6433HUMA1 | BSP76E6433HUMA1 | SOT230P700X170-4N | INFINEON - BSP76E6433HUMA1 - POWER LOAD SW, AEC-Q100, 42V, SOT-223-4 | Infineon
41 | 1 | C2012X5R1A336M125AC |  | C14 | C2012X5R1A336M125AC | C2012X5R1A336M125AC | CAPC2012X145N | TDK 0805 C 33uF Ceramic Multilayer Capacitor, 10 V dc, +85C, X5R Dielectric, +/-20% | TDK
42 | 2 | C2012X5R1V106K085AC |  | C12, C13 | C2012X5R1V106K085AC | C2012X5R1V106K085AC | CAPC2012X100N | Capacitor MLCC 0805 35V 10uF X5R TDK 10uF Multilayer Ceramic Capacitor (MLCC) 35 V dc +/-10% X5R dielectric C SMT max op. temp. +85C | TDK
43 | 2 | C3216X7R1V106K160AC |  | C1, C10 | C3216X7R1V106K160AC | C3216X7R1V106K160AC | CAPC3216X180N | Multilayer Ceramic Capacitors MLCC - SMD/SMT 10UF 35V 10% 1206 | TDK
44 | 1 | CRCW0402169KFKED |  | R8 | CRCW0402169KFKED | CRCW0402169KFKED | RESC1005X40N | Vishay CRCW Series Thick Film Surface Mount Resistor 0402 Case 169k +/-1% 0.063W +/-100ppm/C | Vishay
45 | 1 | CRCW040237K4FKED |  | R7 | CRCW040237K4FKED | CRCW040237K4FKED | RESC1005X40N | Vishay CRCW Series Thick Film Surface Mount Resistor 0402 Case 37.4k +/-1% 0.063W +/-100ppm/C | Vishay
46 | 1 | CRCW040253K6FKED |  | R9 | CRCW040253K6FKED | CRCW040253K6FKED | RESC1005X40N | VISHAY - CRCW040253K6FKED. - RES, THICK FILM, 53K6, 1%, 0.063W, 0402 | Vishay
47 | 2 | CSTCE16M0V53C-R0 |  | IC12, IC13 | CSTCE16M0V53C-R0 | CSTCE16M0V53C-R0 | CSTCE16M0V53CR0 | SMD Ceramic Resonator 16 MHz 15PF CSTCE16M0V53C-R0, Ceramic Resonator, 16MHz Expander 15pF, 4-Pin, 3.2 x 1.3 x 0.9mm | Murata Electronics
48 | 2 |  | DNI | R37, R38 | DNP | R_0402 | R0402 | RESISTOR
49 | 1 | DSK-3R3H224U-HL |  | C7 | DSK-3R3H224U-HL | DSK-3R3H224U-HL | DSK-414_HL | Supercapacitors / Ultracapacitors 3.3V .22F 6.8x2.1 | Elna
50 | 1 | EE2-3TNU-L |  | K1 | EE2-3TNU-L | EE2-3TNU-L | EE25TNU | Relay Signal 2FormC 3V 10uA | Kemet
51 | 1 | FA1-NCRP-PCB-8 |  | J3 | FA1-NCRP-PCB-8 | FA1-NCRP-PCB-8 | FA1NCRPPCB8 | AMPHENOL RF - FA1-NCRP-PCB-8 - RF COAXIAL, SMB/FAKRA, R/A PLUG, PCB | Amphenol RF
52 | 1 | FA1-NDRP-PCB-8 |  | J6 | FA1-NDRP-PCB-8 | FA1-NDRP-PCB-8 | FA1NDRPPCB8 | AMPHENOL RF - FA1-NDRP-PCB-8 - RF CONNECTOR, SMB, R/A PLUG, PCB | Amphenol RF
53 | 1 | GCM1555C1H101JA16D |  | C51 | GCM1555C1H101JA16D | GCM1555C1H101JA16D | CAPC1005X55N | Multilayer Ceramic Capacitors MLCC - SMD/SMT 0402 100pF 50volts C0G 5% | Murata Electronics
54 | 1 | GRM1555C1H150JA01J |  | C41 | GRM1555C1H150JA01J | GRM1555C1H150JA01J | CAPC1005X55N | Multilayer Ceramic Capacitors MLCC - SMD/SMT 0402 15pF 50volts C0G 5% | Murata Electronics
55 | 1 | GRM1555C1H330JA01J |  | C42 | GRM1555C1H330JA01J | GRM1555C1H330JA01J | CAPC1005X55N | Multilayer Ceramic Capacitors MLCC - SMD/SMT 0402 33pF 50volts C0G 5% | Murata Electronics
56 | 5 | GRM1555C1H470JA01D |  | C36, C46, C47, C48, C49 | GRM1555C1H470JA01D | GRM1555C1H470JA01D | CAPC1005X55N | Murata 0402 GRM 47pF Ceramic Multilayer Capacitor, 50 V dc, +125C, C0G Dielectric, +/-5% SMD | Murata Electronics
57 | 2 | GRM188R71H104KA93D |  | C15, C39 | GRM188R71H104KA93D | GRM188R71H104KA93D | CAPC1608X90N | Ceramic SMT capacitor 100nF 50Vdc Murata 0603 GRM 100nF Ceramic Multilayer Capacitor, 50 V dc, +125?C, X7R Dielectric, ?10% | Murata Electronics
58 | 1 | HSMG-C190 |  | LED1 | HSMG-C190 | HSMG-C190 | LEDC1608X90N | Broadcom HSMG-C190 Green LED, 572 nm 1608 (0603), Rectangle Lens SMD package | Avago Technologies
59 | 1 | HSMR-C190 |  | LED4 | HSMR-C190 | HSMR-C190 | LEDC1608X80N | ChipLED,blue,469nm,55mcd,78mW,140deg Avago Blue LED, 55 mcd 140 0603 | Avago Technologies
60 | 1 | HSMS-C190 |  | LED3 | HSMS-C190 | HSMS-C190 | LEDC1608X90N | Broadcom HSMS-C190 Red LED, 626 nm 1608 (0603), Rectangle Lens SMD package | Avago Technologies
61 | 1 | LQG15HN39NJ02D |  | L4 | LQG15HN39NJ02D | LQG15HN39NJ02D | INDC1005X55N | Murata LQG15HN Series Type 1005 Wire-wound SMD Inductor with a Non-Magnetic Ceramic Core, 39 nH +/-5% Multilayer | Murata Electronics
62 | 1 | M50-3600542R |  | J7 | M50-3600542R | M50-3600542R | M503600542R | HARWIN Archer M50, 1.27mm Pitch, 10 Way, 2 Row Unshrouded, Right Angle Pin Header, Surface Mount, Solder Termination | HARWIN
63 | 1 | MAX-M8Q-0 |  | U$1 | MAX-M8 | MAX-M8 | MAX-M8 | u-blox MAX GNSS module
64 | 2 | MBR0560-TP |  | D10, D11 | MBR0560-TP | MBR0560-TP | SOD3716X135N | Schottky Diodes & Rectifiers 20Vr 14Vrms 20V 5.5A 0.70V 30pF | Micro Commercial Components (MCC)
65 | 2 | MCP2515T-I/ST |  | IC10, IC11 | MCP2515T-I_ST | MCP2515T-I_ST | SOP65P640X120-20N | Stand-Alone CAN Controller SPI TSSOP20 Microchip MCP2515T-I/ST, CAN Controller 1Mbit/s CAN 2.0B, 20-Pin TSSOP | Microchip
66 | 1 | MINISMDC050F-2 |  | F1 | MINISMDC050F-2 | MINISMDC050F-2 | FUSC4632X62N | LITTELFUSE - MINISMDC050F-2 - POLYSWITCH, 0.5A, 24V, SMD | LITTELFUSE
67 | 1 | MINISMDC150F/24-2 |  | F2 | MINISMDC150F_24-2 | MINISMDC150F_24-2 | FUSC4632X194N | LITTELFUSE - MINISMDC150F/24-2 - POLYSWITCH, SMD, 1812, 1.5A | LITTELFUSE
68 | 4 |  | DNI | H1, H4, H5, H6 | MOUNT-HOLE3.0 | MOUNT-HOLE3.0 | 3,0 | MOUNTING HOLE with drill center marker
69 | 9 | PESD0402-140 |  | D2, D3, D4, D5, D6, D7, D8, D13, D14 | PESD0402-140 | PESD0402-140 | DIONC1005X43N | TVS Diode Bi-Directional PESD0402-140 40V, SOD-923 2-Pin | TE Connectivity
70 | 1 | PRTR5V0U2X,215 |  | D12 | PRTR5V | PRTR5V0U2X,215 | SOT190P230X110-4N | USB ESD protection | NXP
71 | 1 | RC0201FR-0710KL |  | R10 | RC0201FR-0710KL | RC0201FR-0710KL | RESC0603X26N | Thick Film Resistors - SMD 10K OHM 1% | YAGEO (PHYCOMP)
72 | 1 | SARA-R410M-02B |  | IC2 | SARA-R410M-02B | SARA-R410M-02B | SARA-U201-03B | Size-optimized LTE Cat M1/NB1 and EGPRS modules | U-Blox
73 | 1 | SF56S006V4BR2000 |  | J1 | SF56S006V4BR2000 | SF56S006V4BR2000 | SF56S006V4BR2000 | Memory Card Connectors microSIM LOW PROFILE PUSH-PUSH | JAE Electronics
74 | 1 | SN74AVC2T245RSWR |  | U1 | SN74AVC2T245RSWR | SN74AVC2T245RSWR | RSW(RPUQFNN10) | Dual-Bit, 2-DIR pin Dual-Supply Bus Transceiver w/ Configurable Voltage Translation, 3-State Output | Texas Instruments
75 | 1 | SPBTLE-RF |  | IC7 | SPBTLE-RF | SPBTLE-RF | XCVR_SPBTLE-RF | Very low power module for Bluetooth Smart v4.1 | STMicroelectronics
76 | 1 | SRN6045-150M |  | L1 | SRN6045-150M | SRN6045-150M | SRN6045_1 | Power Inductor semi-shielded SMD 15uH Bourns SRN6045 Series Shielded Wire-wound SMD Inductor with a Ferrite Core, 15 uH +/-20% Wire-Wound 2.3A Idc | Bourns
77 | 1 | SRU1048-4R7Y |  | L2 | SRU1048-4R7Y | SRU1048-4R7Y | SRU10484R7Y | Inductor Power Shielded Wirewound 4.7uH 30% 100KHz 12Q-Factor Ferrite 5.5A 9.5mOhm DCR T/R | Bourns
78 | 1 | SS13FL |  | D1 | SS13FL | SS13FL | SODFL3617X108N | Schottky Diodes & Rectifiers 30V, 1A SCHOTTKY | Fairchild Semiconductor
79 | 1 | TJA1048TK,118 |  | IC9 | TJA1048TK,118 | TJA1048TK,118 | SON65P300X450X100-15N | CAN Interface IC Dual high-speed CAN transceiver with Standby mode | Nexperia
80 | 1 | TL4100AF120QG |  | S1 | TL4100AF120QG | TL4100AF120QG | TL4100AF120QG | Tactile Switches Right Angle Edge Mounted Tact Switch | E-Switch
81 | 12 |  | DNI | TP3V3, TP3V8, TP5V, TP_1V8, TP_MDCD, TP_MPWR_ON, TP_MRST, TP_MRX, TP_MTX, TP_MUSBN, TP_MUSBP, TP_MVUSB | TPB1,27 | TPB1,27 | B1,27 | Test pad
82 | 1 | TPS54232D |  | IC4 | TPS54232D | TPS54232D | SOIC127P600X175-8N | TPS54232D, Switching Regulator, Buck Controller, 2A, Adjustable, Minimum of 0.8 V, 1200 kHz, 8-Pin SOIC | Texas Instruments
83 | 1 | TPS563231DRLR |  | IC5 | TPS563231DRLR | TPS563231DRLR | SOTFL50P160X60-6N | 4.5-V to 17-V input, 3-A synchronous step-down voltage regulator | Texas Instruments
84 | 1 | W25Q16JVZPIQ |  | IC8 | W25Q16JVZPIQ | W25Q16JVZPIQ | SON127P600X500X80-9N | IC FLASH 16MBIT 133MHZ 8WSON | Winbond
