WaiveCar/WaiveTelem/Hardware/-002net.xlsx

Netlist
Exported from 001000-002.sch at 5/21/2019 10:49 AM
EAGLE Version 9.4.0 Copyright (c) 1988-2019 Autodesk | Inc.
Net | Part | Pad | Pin | Sheet
+1V8 | IC2 | 4 | V_INT | 1
 | R16 | 2 | 2 | 1
 | R17 | 2 | 2 | 1
 | SHIFTER1:C2 | 2 | 2 | SHIFTER:1
 | SHIFTER1:IC1 | 6 | VCCB | SHIFTER:1
 | SHIFTER1:IC2 | 6 | VCCB | SHIFTER:1
 | SHIFTER1:IC3 | 6 | VCCB | SHIFTER:1
 | SHIFTER1:IC4 | 6 | VCCB | SHIFTER:1
+3V3 | C18 | 2 | 2 | 1
 | C19 | 2 | 2 | 1
 | C30 | 1 | 1 | 1
 | C31 | 2 | 2 | 3
 | C32 | 2 | 2 | 3
 | C33 | 2 | 2 | 3
 | C34 | 2 | 2 | 4
 | C36 | 1 | 1 | 5
 | C37 | 1 | 1 | 5
 | C8 | 2 | 2 | 2
 | FB1 | 1 | 1 | 1
 | IC1 | 17 | VDDIO_1 | 1
 | IC1 | 36 | VDDIO_2 | 1
 | IC1 | 44 | VDDIN | 1
 | IC10 | 20 | VDD | 4
 | IC11 | 20 | VDD | 4
 | IC3 | 5 | VOUT | 2
 | IC6 | 8 | VCC | 3
 | IC7 | 5 | VIN | 3
 | IC8 | 3 | IO2 | 3
 | IC8 | 7 | IO3 | 3
 | IC8 | 8 | VCC | 3
 | IC9 | 11 | VIO | 4
 | J2 | 4 | VDD | 3
 | K1 | 1 | SET_COIL_+ | 3
 | K1 | 6 | RESET_COIL_+ | 3
 | R22 | 2 | 2 | 3
 | R23 | 2 | 2 | 3
 | R24 | 2 | 2 | 4
 | R25 | 2 | 2 | 4
 | R26 | 2 | 2 | 4
 | R27 | 2 | 2 | 4
 | R28 | 2 | 2 | 4
 | R29 | 2 | 2 | 4
 | R30 | 2 | 2 | 4
 | R31 | 2 | 2 | 4
 | R32 | 2 | 2 | 5
 | R4 | 2 | 2 | 2
 | SHIFTER1:C1 | 2 | 2 | SHIFTER:1
 | SHIFTER1:IC1 | 1 | VCCA | SHIFTER:1
 | SHIFTER1:IC2 | 1 | VCCA | SHIFTER:1
 | SHIFTER1:IC3 | 1 | VCCA | SHIFTER:1
 | SHIFTER1:IC3 | 5 | DIR | SHIFTER:1
 | SHIFTER1:IC4 | 1 | VCCA | SHIFTER:1
 | SHIFTER1:IC4 | 5 | DIR | SHIFTER:1
 | U$1 | 7_VCC_IO | 7_VCC_IO | 5
 | U$1 | 8_VCC | 8_VCC | 5
+3V8 | C14 | 2 | 2 | 2
 | C15 | 2 | 2 | 2
 | C22 | 2 | 2 | 1
 | C23 | 2 | 2 | 1
 | C24 | 2 | 2 | 1
 | C25 | 2 | 2 | 1
 | C26 | 2 | 2 | 1
 | C28 | 2 | 2 | 1
 | C9 | 2 | 2 | 2
 | IC2 | 51 | VCC_1 | 1
 | IC2 | 52 | VCC_2 | 1
 | IC2 | 53 | VCC_3 | 1
 | IC3 | 1 | VIN | 2
 | L2 | 2 | 2 | 2
 | R9 | 2 | 2 | 2
+12V | C1 | 2 | 2 | 2
 | C10 | 2 | 2 | 2
 | C12 | 2 | 2 | 2
 | C13 | 2 | 2 | 2
 | C39 | 2 | 2 | 2
 | IC4 | 2 | VIN | 2
 | IC5 | 1 | VIN | 2
 | IC5 | 5 | EN | 2
 | R8 | 2 | 2 | 2
9_V_RESET_N | U$1 | 9_RESET_N | 9_V_RESET_N | 5
CAN0H_OUT | D8 | 2 | A | 4
 | IC9 | 13 | CANH1 | 4
CAN0L_OUT | D7 | 2 | A | 4
 | IC9 | 12 | CANL1 | 4
CAN1H_OUT | D6 | 2 | A | 4
 | IC9 | 10 | CANH2 | 4
CAN1L_OUT | D5 | 2 | A | 4
 | IC9 | 9 | CANL2 | 4
CODE_A_IN | K1 | 4 | COM_1 | 3
CODE_A_OUT | K1 | 5 | NO_1 | 3
CODE_B_IN | K1 | 9 | COM_2 | 3
CODE_B_OUT | K1 | 10 | NC_2 | 3
GND | C1 | 1 | 1 | 2
 | C10 | 1 | 1 | 2
 | C11 | 1 | 1 | 2
 | C12 | 1 | 1 | 2
 | C13 | 1 | 1 | 2
 | C14 | 1 | 1 | 2
 | C15 | 1 | 1 | 2
 | C16 | 1 | 1 | 1
 | C17 | 1 | 1 | 1
 | C18 | 1 | 1 | 1
 | C19 | 1 | 1 | 1
 | C20 | 1 | 1 | 1
 | C21 | 1 | 1 | 1
 | C22 | 1 | 1 | 1
 | C23 | 1 | 1 | 1
 | C24 | 1 | 1 | 1
 | C25 | 1 | 1 | 1
 | C26 | 1 | 1 | 1
 | C27 | 1 | 1 | 1
 | C28 | 1 | 1 | 1
 | C29 | 2 | 2 | 1
 | C3 | 1 | 1 | 2
 | C30 | 2 | 2 | 1
 | C31 | 1 | 1 | 3
 | C32 | 1 | 1 | 3
 | C33 | 1 | 1 | 3
 | C34 | 1 | 1 | 4
 | C35 | 2 | 2 | 4
 | C36 | 2 | 2 | 5
 | C37 | 2 | 2 | 5
 | C39 | 1 | 1 | 2
 | C4 | 1 | 1 | 2
 | C5 | 1 | 1 | 2
 | C6 | 1 | 1 | 2
 | C7 | 2 | + | 2
 | C8 | 1 | 1 | 2
 | C9 | 1 | 1 | 2
 | D1 | 2 | A | 2
 | D2 | 1 | K | 1
 | D3 | 1 | K | 1
 | D4 | 1 | K | 1
 | D5 | 1 | K | 4
 | D6 | 1 | K | 4
 | D7 | 1 | K | 4
 | D8 | 1 | K | 4
 | IC1 | 18 | GND_1 | 1
 | IC1 | 35 | GND_2 | 1
 | IC1 | 42 | GND_3 | 1
 | IC1 | 5 | GNDANA | 1
 | IC10 | 10 | VSS | 4
 | IC11 | 10 | VSS | 4
 | IC12 | 2 | 2 | 4
 | IC13 | 2 | 2 | 4
 | IC2 | 1 | GND_1 | 1
 | IC2 | 14 | GND_4 | 1
 | IC2 | 20 | GND_5 | 1
 | IC2 | 21 | GND_6 | 1
 | IC2 | 22 | GND_7 | 1
 | IC2 | 3 | GND_2 | 1
 | IC2 | 30 | GND_8 | 1
 | IC2 | 32 | GND_9 | 1
 | IC2 | 33 | RSVD_3 | 1
 | IC2 | 43 | GND_10 | 1
 | IC2 | 5 | GND_3 | 1
 | IC2 | 50 | GND_11 | 1
 | IC2 | 54 | GND_12 | 1
 | IC2 | 55 | GND_13 | 1
 | IC2 | 57 | GND_14 | 1
 | IC2 | 58 | GND_15 | 1
 | IC2 | 59 | GND_16 | 1
 | IC2 | 60 | GND_17 | 1
 | IC2 | 61 | GND_18 | 1
 | IC2 | 63 | GND_19 | 1
 | IC2 | 64 | GND_20 | 1
 | IC2 | 65 | GND_21 | 1
 | IC2 | 66 | GND_22 | 1
 | IC2 | 67 | GND_23 | 1
 | IC2 | 68 | GND_24 | 1
 | IC2 | 69 | GND_25 | 1
 | IC2 | 70 | GND_26 | 1
 | IC2 | 71 | GND_27 | 1
 | IC2 | 72 | GND_28 | 1
 | IC2 | 73 | GND_29 | 1
 | IC2 | 74 | GND_30 | 1
 | IC2 | 75 | GND_31 | 1
 | IC2 | 76 | GND_32 | 1
 | IC2 | 77 | GND_33 | 1
 | IC2 | 78 | GND_34 | 1
 | IC2 | 79 | GND_35 | 1
 | IC2 | 80 | GND_36 | 1
 | IC2 | 81 | GND_37 | 1
 | IC2 | 82 | GND_38 | 1
 | IC2 | 83 | GND_39 | 1
 | IC2 | 84 | GND_40 | 1
 | IC2 | 85 | GND_41 | 1
 | IC2 | 86 | GND_42 | 1
 | IC2 | 87 | GND_43 | 1
 | IC2 | 88 | GND_44 | 1
 | IC2 | 89 | GND_45 | 1
 | IC2 | 90 | GND_46 | 1
 | IC2 | 91 | GND_47 | 1
 | IC2 | 92 | GND_48 | 1
 | IC2 | 93 | GND_49 | 1
 | IC2 | 94 | GND_50 | 1
 | IC2 | 95 | GND_51 | 1
 | IC2 | 96 | GND_52 | 1
 | IC3 | 2 | GND | 2
 | IC4 | 7 | GND | 2
 | IC5 | 3 | GND | 2
 | IC6 | 4 | GND | 3
 | IC7 | 6 | GND | 3
 | IC8 | 4 | GND | 3
 | IC8 | 9 | EP | 3
 | IC9 | 2 | GNDA | 4
 | IC9 | 5 | GNDB | 4
 | J1 | 10 | HD1 | 1
 | J1 | 11 | HD4 | 1
 | J1 | 4 | C5 | 1
 | J1 | 7 | HD3 | 1
 | J1 | 9 | HD2 | _DSW1 | 1
 | J2 | 6 | VSS | 3
 | LED3 | 1 | K | 1
 | Q1 | 1 | S1 | 3
 | Q1 | 4 | S2 | 3
 | Q3 | 2 | 2 | 1
 | Q4 | 1 | S1 | 1
 | Q4 | 4 | S2 | 1
 | Q5 | 3 | S | 3
 | Q6 | 3 | S | 3
 | R10 | 1 | 1 | 2
 | R18 | 1 | 1 | 1
 | R19 | 1 | 1 | 1
 | R2 | 1 | 1 | 2
 | R7 | 1 | 1 | 2
 | SHIFTER1:C1 | 1 | 1 | SHIFTER:1
 | SHIFTER1:C2 | 1 | 1 | SHIFTER:1
 | SHIFTER1:IC1 | 2 | GND | SHIFTER:1
 | SHIFTER1:IC1 | 5 | DIR | SHIFTER:1
 | SHIFTER1:IC2 | 2 | GND | SHIFTER:1
 | SHIFTER1:IC2 | 5 | DIR | SHIFTER:1
 | SHIFTER1:IC3 | 2 | GND | SHIFTER:1
 | SHIFTER1:IC4 | 2 | GND | SHIFTER:1
 | U$1 | 10_GND | 10_GND | 5
 | U$1 | 12_GND | 12_GND | 5
 | U$1 | 15_V_ANT/RESERVED | 15_RES/V_ANT | 5
 | U$1 | 1_GND | 1_GND | 5
GPS_BCKP | R5 | 1 | 1 | 2
 | U$1 | 6_V_BCKP | 6_V_BCKP | 5
LOCK_OUT | R20 | 2 | 2 | 3
LOCK_PIN | Q5 | 1 | IN | 3
MCTS | IC2 | 11 | CTS | 1
 | SHIFTER1:IC2 | 4 | B | SHIFTER:1
MDTR | IC2 | 9 | DTR | 1
 | R14 | 2 | 2 | 1
MRI | IC2 | 7 | RI | 1
MRST | IC2 | 18 | RESET_N | 1
 | Q4 | 3 | D2 | 1
MRTS | IC2 | 10 | RTS | 1
 | SHIFTER1:IC3 | 4 | B | SHIFTER:1
MRX | IC2 | 13 | RXD | 1
 | SHIFTER1:IC1 | 4 | B | SHIFTER:1
MTX | IC2 | 12 | TXD | 1
 | SHIFTER1:IC4 | 4 | B | SHIFTER:1
N$1 | C20 | 2 | 2 | 1
 | C21 | 2 | 2 | 1
 | FB1 | 2 | 2 | 1
 | IC1 | 6 | VDDANA | 1
N$2 | IC2 | 56 | ANT | 1
N$3 | IC2 | 16 | GPIO1 | 1
 | R14 | 1 | 1 | 1
N$4 | IC2 | 23 | GPIO2 | 1
 | R15 | 2 | 2 | 1
N$5 | C2 | 2 | 2 | 2
 | IC4 | 1 | BOOT | 2
N$6 | C2 | 1 | 1 | 2
 | D1 | 1 | K | 2
 | IC4 | 8 | PH | 2
 | L1 | 1 | 1 | 2
N$7 | C3 | 2 | 2 | 2
 | IC4 | 6 | COMP | 2
 | R3 | 2 | 2 | 2
N$8 | C4 | 2 | 2 | 2
 | R3 | 1 | 1 | 2
N$9 | IC4 | 5 | VSENSE | 2
 | R1 | 1 | 1 | 2
 | R2 | 2 | 2 | 2
N$10 | D9 | 2 | A | 2
 | R4 | 1 | 1 | 2
N$11 | C5 | 2 | 2 | 2
 | IC4 | 4 | SS | 2
N$12 | C7 | 1 | - | 2
 | D9 | 1 | K | 2
 | R5 | 2 | 2 | 2
 | R6 | 2 | 2 | 2
N$13 | IC4 | 3 | EN | 2
 | R7 | 2 | 2 | 2
 | R8 | 1 | 1 | 2
N$14 | R6 | 1 | 1 | 2
N$15 | K1 | 7 | RESET_COIL_- | 3
 | Q1 | 3 | D2 | 3
N$16 | C38 | 1 | 1 | 2
 | IC5 | 2 | SW | 2
 | L2 | 1 | 1 | 2
N$18 | IC5 | 6 | FB | 2
 | R10 | 2 | 2 | 2
 | R9 | 1 | 1 | 2
N$19 | K1 | 12 | SET_COIL_- | 3
 | Q1 | 6 | D1 | 3
N$20 | C38 | 2 | 2 | 2
 | IC5 | 4 | BST | 2
N$22 | LED3 | 2 | A | 1
 | R15 | 1 | 1 | 1
N$24 | J1 | 5 | C6 | 1
N$25 | IC1 | 8 | PB09 | 1
N$26 | C29 | 1 | 1 | 1
 | IC1 | 43 | VDDCORE | 1
N$27 | IC10 | 9 | OSC1 | 4
 | IC12 | 1 | 1 | 4
N$28 | Q6 | 2 | D_1 | 3
 | Q6 | 4 | D_2 | 3
 | R21 | 1 | 1 | 3
N$29 | Q5 | 2 | D_1 | 3
 | Q5 | 4 | D_2 | 3
 | R20 | 1 | 1 | 3
N$30 | IC10 | 8 | OSC2 | 4
 | IC12 | 3 | 3 | 4
N$31 | IC9 | 14 | STBN1 | 4
 | R30 | 1 | 1 | 4
N$32 | IC11 | 9 | OSC1 | 4
 | IC13 | 1 | 1 | 4
N$33 | IC11 | 8 | OSC2 | 4
 | IC13 | 3 | 3 | 4
N$34 | IC9 | 8 | STBN2 | 4
 | R31 | 1 | 1 | 4
N$35 | LED4 | 2 | A | 5
 | U$1 | 5_EXTINT | 5_EXTINT | 5
N$36 | LED4 | 1 | K | 5
 | R32 | 1 | 1 | 5
N$39 | IC11 | 19 | !RESET | 4
 | R25 | 1 | 1 | 4
N$42 | IC10 | 19 | !RESET | 4
 | R27 | 1 | 1 | 4
PA00_XIN32 | C16 | 2 | 2 | 1
 | IC1 | 1 | PA00 | 1
 | Y1 | 2 | 2 | 1
PA01_XOUT32 | C17 | 2 | 2 | 1
 | IC1 | 2 | PA01 | 1
 | Y1 | 1 | 1 | 1
PA02_AIN0 | IC1 | 3 | PA02 | 1
 | IC11 | 18 | !CS | 4
 | R24 | 1 | 1 | 4
PA03_VREFA | IC1 | 4 | PA03 | 1
PA04_AIN4 | IC1 | 9 | PA04 | 1
 | IC7 | 11 | BT_RESET | 3
PA05_AIN5 | IC1 | 10 | PA05 | 1
PA06_AIN6 | IC1 | 11 | PA06 | 1
PA07_AIN7 | IC1 | 12 | PA07 | 1
 | IC11 | 13 | !INT | 4
 | R29 | 1 | 1 | 4
PA08_S0_I2C_SDA | IC1 | 13 | PA08 | 1
 | IC6 | 5 | SDA | 3
PA09_S0_I2C_SCL | IC1 | 14 | PA09 | 1
 | IC6 | 6 | SCL | 3
PA10_TCC0-W2 | IC1 | 15 | PA10 | 1
PA11_TCC0-W3 | IC1 | 16 | PA11 | 1
 | IC10 | 18 | !CS | 4
 | R26 | 1 | 1 | 4
PA12_S2_TX | IC1 | 21 | PA12 | 1
 | SHIFTER1:IC4 | 3 | A | SHIFTER:1
PA13_S2_RX | IC1 | 22 | PA13 | 1
 | SHIFTER1:IC1 | 3 | A | SHIFTER:1
PA14_S2_RTS | IC1 | 23 | PA14 | 1
 | SHIFTER1:IC3 | 3 | A | SHIFTER:1
PA15_S2_CTS | IC1 | 24 | PA15 | 1
 | SHIFTER1:IC2 | 3 | A | SHIFTER:1
PA16_S1_MOSI | IC1 | 25 | PA16 | 1
 | IC10 | 16 | SI | 4
 | IC11 | 16 | SI | 4
 | IC8 | 5 | DI_(IO0) | 3
 | J2 | 3 | CMD | 3
PA17_S1_SCK | IC1 | 26 | PA17 | 1
 | IC10 | 14 | SCK | 4
 | IC11 | 14 | SCK | 4
 | IC8 | 6 | CLK | 3
 | J2 | 5 | CLK | 3
PA18_OTG | IC1 | 27 | PA18 | 1
PA19_S1_MISO | IC1 | 28 | PA19 | 1
 | IC10 | 17 | SO | 4
 | IC11 | 17 | SO | 4
 | IC8 | 2 | DO_(IO1) | 3
 | J2 | 7 | DAT0 | 3
PA20_TCC0-W6 | IC1 | 29 | PA20 | 1
 | IC7 | 8 | SPI_MISO | 3
PA21_TCC0-W7 | IC1 | 30 | PA21 | 1
 | IC10 | 13 | !INT | 4
 | R28 | 1 | 1 | 4
PA22_TC4-W0 | IC1 | 31 | PA22 | 1
 | IC7 | 9 | SPI_MOSI | 3
PA23_TC4-W1 | IC1 | 32 | PA23 | 1
 | IC7 | 7 | SPI_CLK | 3
PA24_USB_N | IC1 | 33 | PA24 | 1
PA25_USB_P | IC1 | 34 | PA25 | 1
PA27_INT | IC1 | 39 | PA27 | 1
PA28_S2_PWRON | IC1 | 41 | PA28 | 1
 | Q4 | 2 | G1 | 1
 | R18 | 2 | 2 | 1
PA30_SWCLK | IC1 | 45 | PA30 | 1
PA31_SWDIO | IC1 | 46 | PA31 | 1
PB02_AIN10 | IC1 | 47 | PB02 | 1
 | IC7 | 10 | SPI_CS | 3
PB03_AIN11 | IC1 | 48 | PB03 | 1
 | IC7 | 4 | SPI_IRQ | 3
PB08_RST | IC1 | 7 | PB08 | 1
 | Q4 | 5 | G2 | 1
 | R19 | 2 | 2 | 1
PB10_TCC0-W4 | IC1 | 19 | PB10 | 1
 | J2 | 2 | CD/DAT3 | 3
 | R23 | 1 | 1 | 3
PB11_TCC0-W5 | IC1 | 20 | PB11 | 1
 | IC8 | 1 | !CS | 3
 | R22 | 1 | 1 | 3
PB22_S5_TX | FB2 | 2 | 2 | 5
 | IC1 | 37 | PB22 | 1
PB23_S5_RX | FB3 | 2 | 2 | 5
 | IC1 | 38 | PB23 | 1
PWR_ON | IC2 | 15 | PWR_ON | 1
 | Q4 | 6 | D1 | 1
RXCAN0 | IC10 | 2 | RXCAN | 4
 | IC9 | 4 | RXD1 | 4
RXCAN1 | IC11 | 2 | RXCAN | 4
 | IC9 | 7 | RXD2 | 4
SCLK | D2 | 2 | A | 1
 | IC2 | 38 | SIM_CLK | 1
 | J1 | 3 | C3 | 1
SIM_DET | IC2 | 42 | GPIO5 | 1
 | Q3 | 3 | 3 | 1
 | R17 | 1 | 1 | 1
SIO | D3 | 2 | A | 1
 | IC2 | 39 | SIM_IO | 1
 | J1 | 6 | C7 | 1
SRST | D4 | 2 | A | 1
 | IC2 | 40 | SIM_RST | 1
 | J1 | 2 | C2 | 1
SSW | J1 | 8 | DSW2 | 1
 | Q3 | 1 | 1 | 1
 | R16 | 1 | 1 | 1
SVCC | C27 | 2 | 2 | 1
 | IC2 | 41 | VSIM | 1
 | J1 | 1 | C1 | 1
TXCAN0 | IC10 | 1 | TXCAN | 4
 | IC9 | 1 | TXD1 | 4
TXCAN1 | IC11 | 1 | TXCAN | 4
 | IC9 | 6 | TXD2 | 4
UB_GPS_RX | FB2 | 1 | 1 | 5
 | U$1 | 3_RXD | 3_RXD | 5
UB_GPS_TX | FB3 | 1 | 1 | 5
 | U$1 | 2_TXD | 2_TXD | 5
UNLOCK_OUT | R21 | 2 | 2 | 3
UNLOCK_PIN | Q6 | 1 | IN | 3
VIN | C11 | 2 | 2 | 2
 | C35 | 1 | 1 | 4
 | C6 | 2 | 2 | 2
 | IC9 | 3 | VCC | 4
 | L1 | 2 | 2 | 2
 | R1 | 2 | 2 | 2
