WaiveCar/WaiveTelem/Hardware/001000-001.xlsx

Sheet: Sheet1
Row Labels | Count of Part | price estimate, each | extended
R0402 | 30 | 0.1 |  | Count of Part | price estimate, each | extended
C0402 | 27 | 0.1 |  | 30 | 0.1 | $3.00
C0603 | 8 | 0.1 |  | 27 | 0.1 | $2.70
DIONC1005X43N | 7 | 0.15 |  | 8 | 0.1 | $0.80
SN74LVC1T45DPKR | 4 | 0.2 |  | 7 | 0.15 | $1.05
(blank) | 3 | 0.4 |  | 4 | 0.2 | $0.80
SOP65P640X120-20N | 2 | 1.5 |  | 3 | 0.4 | $1.20
LEDC1608X90N | 2 | 0.1 |  | 2 | 1.5 | $3.00
CSTCE16M0V53CR0 | 2 | 0.3 |  | 2 | 0.1 | $0.20
R1206 | 2 | 0.05 |  | 2 | 0.3 | $0.60
BEADC1005X55N | 2 | 0.05 |  | 2 | 0.05 | $0.10
LEDC1608X80N | 2 | 0.1 |  | 2 | 0.05 | $0.10
SOT230P700X170-4N | 2 | 1 |  | 2 | 0.1 | $0.20
SIA537EDJT1GE3 | 1 | 0.5 |  | 2 | 1 | $2.00
SON127P600X500X80-9N | 1 | 0.5 |  | 1 | 0.5 | $0.50
SODFL3617X108N | 1 | 0.1 |  | 1 | 0.5 | $0.50
SOT65P210X100-6N | 1 | 0.1 |  | 1 | 0.1 | $0.10
C1206 | 1 | 0.05 |  | 1 | 0.1 | $0.10
SPSGRF868 | 1 | 4.5 |  | 1 | 0.05 | $0.05
BEADC1608X95N | 1 | 0.05 |  | 1 | 4.5 | $4.50
INDC4441X200N | 1 | 1 |  | 1 | 0.05 | $0.05
SOIC127P600X175-8N | 1 | 1 |  | 1 | 1 | $1.00
CAPC3216X180N | 1 | 0.5 |  | 1 | 1 | $1.00
SON50P300X200X60-9N | 1 | 0.7 |  | 1 | 0.5 | $0.50
SARA-U201-03B | 1 | 22 |  | 1 | 0.7 | $0.70
SF56S006V4BR2000 | 1 | 1 |  | 1 | 22 | $22.00
MAX-M8 | 1 | 11 |  | 1 | 1 | $1.00
SOT95P282X130-5N | 1 | 0.2 |  | 1 | 11 | $11.00
QFN50P400X400X100-25N | 1 | 2.5 |  | 1 | 0.2 | $0.20
SRN6045_1 | 1 | 0.25 |  | 1 | 2.5 | $2.50
QFP50P900X900X120-48N | 1 | 3 |  | 1 | 0.25 | $0.25
ABS0716632768KHZT | 1 | 0.6 |  | 1 | 3 | $3.00
1040310811 | 1 | 1.5 |  | 1 | 0.6 | $0.60
Grand Total | 113 |  |  | 1 | 1.5 | $1.50
 |  |  |  |  |  | $66.80

Sheet: Sheet27
SAMD21 Pin to Net To devices
Pin | Name | Net Name | Device | Signal | DSingle/Multiple | ARD | notes
1 | PA00 | PA00_XIN | Oscillator | - | Single
2 | PA01 | PA01_XOUT | Oscillator | - | Single
3 | PA02 | PA02_AIN0 | mcp2515-CAN1 | ~CS | Single | A0
4 | PA03 | PA03_VREFA | UNUSED |  |  |  | Can I use this for another chip select digital out line?
5 | GNDANA | GND | Gnd
6 | VDDANA | +3V3 | FeriteBead
7 | PB08 | PB08_RST | modem | ~Mreset | single
8 | PB09 |  | UNUSED |  |  |  | typically used to measure battery voltage
9 | PA04 | PA04_AIN4 | BLE | Reset | single | a3
10 | PA05 | PA05_AIN5 | Lock | Lock | single | a4 | Nets not currently connected
11 | PA06 | PA06_AIN6 | unlock | unlock | single | a5 | Nets not currently connected
12 | PA07 | PA07_AIN7 | mcp2515-CAN1 | ~INT | single | a6
13 | PA08 | PA08_S0_I2C_SDA | Crypto, battery charge | SDA | mux | D11/SDA
14 | PA09 | PA09_S0_I2C_SCL | Crypto, battery charge | SCL | mux | D12/SCL
15 | PA10 | PA10_TCC0-W2 | Immobilizer | activate | single | D2
16 | PA11 | PA11_TCC0-W3 | mcp2515-CAN0 | ~CS | single | D3
17 | VDDIO_1 | +3V3 | supply
18 | GND_1 | GND | Gnd
19 | PB10 | PB10_TCC0-W4 | SD | ~CS | single | D4
20 | PB11 | PB11_TCC0-W5 | Flash | ~CS | single | D5
21 | PA12 | PA12_S2_TX | modem | MTX | single |  | through shifter1
22 | PA13 | PA13_S2_RX | modem | MRX | Single |  | through shifter1
23 | PA14 | PA14_S2_RTS | modem | MRTS | Single |  | through shifter1
24 | PA15 | PA15_S2_CTS | modem | MCTS | Single |  | through shifter1
25 | PA16 | PA16_S1_MOSI | SD, Flash, Can0, Can1 | MOSI | mux | D8/MOSI
26 | PA17 | PA17_S1_SCK | SD, Flash, Can0, Can1 | SCK | mux | D9/sck
27 | PA18 | PA18_OTG | battery charger | OTG | Single |  | ditching the battery charger gets me
28 | PA19 | PA19_S1_MISO | SD, Flash, Can0, Can1 | MISO | mux | D10/MISO
29 | PA20 | PA20_TCC0-W6 | BLE | MISO | single | D6
30 | PA21 | PA21_TCC0-W7 | mcp2515-CAN0 | ~INT | single | D7
31 | PA22 | PA22_TC4-W0 | BLE | MOSI | single | D0
32 | PA23 | PA23_TC4-W1 | BLE | SCK | single | D1
33 | PA24 | PA24_USB_N |  |  |  |  | currently not used, probably want the easy programming interface, however.
34 | PA25 | PA25_USB_P |  |  |  |  | currently not used, probably want the easy programming interface, however.
35 | GND_2 | GND | Gnd
36 | VDDIO_2 | +3V3 | supply
37 | PB22 | PB22_S5_TX | GPS | RX | Single | D14/TX
38 | PB23 | PB23_S5_RX | GPS | TX | Single | D13/RX
39 | PA27 | PA27_INT | battery charger | INT | Single
40 | RESET |  |  |  |  |  | Need to have a way to remotely reset the board.
41 | PA28 | PA28_S2_PWRON | modem | PWRON | single
42 | GND_3 | GND | Gnd
43 | VDDCORE | GND | Gnd
44 | VDDIN | +3V3 | supply
45 | PA30 | PA30_SWCLK |  |  |  |  | not currently connected, need to add programming header
46 | PA31 | PA31_SWDIO |  |  |  |  | not currently connected, need to add programming header
47 | PB02 | PB02_AIN10 | BLE | ~CS | single | A1
48 | PB03 | PB03_AIN11 | BLE | INT | single | A2

Sheet: 001000-001
Part | Value | Device | Package | Description | DESCRIPTION | HEIGHT | MANUFACTURER_NAME | MANUFACTURER_PART_NUMBER | MOUSER_PART_NUMBER | MOUSER_PRICE-STOCK | RS_PART_NUMBER | RS_PRICE-STOCK
C1 | C3216X7R1V106M160AC | C3216X7R1V106M160AC | CAPC3216X180N | TDK 1206 C 10uF Ceramic Multilayer Capacitor
C2 | 100n | C_0402 | C0402 | NON-POLARIZED CAP
C3 | 110p | C_0402 | C0402 | NON-POLARIZED CAP
C4 | 4n7 | C_0402 | C0402 | NON-POLARIZED CAP
C5 | 8n2 | C_0402 | C0402 | NON-POLARIZED CAP
C6 | 10u | C_0603 | C0603 | NON-POLARIZED CAP
C7 | 47n | C_0402 | C0402 | NON-POLARIZED CAP
C8 | 1u | C_0402 | C0402 | NON-POLARIZED CAP
C9 | 10u | C_0603 | C0603 | NON-POLARIZED CAP
C10 | 10u | C_0603 | C0603 | NON-POLARIZED CAP
C11 | 4u7 | C_0402 | C0402 | NON-POLARIZED CAP
C12 | 10u | C_0603 | C0603 | NON-POLARIZED CAP
C13 | 10u | C_0603 | C0603 | NON-POLARIZED CAP
C14 | 1u | C_0402 | C0402 | NON-POLARIZED CAP
C15 | 1u | C_0402 | C0402 | NON-POLARIZED CAP
C16 | 20p | C_0402 | C0402 | NON-POLARIZED CAP
C17 | 20p | C_0402 | C0402 | NON-POLARIZED CAP
C18 | 100n | C_0402 | C0402 | NON-POLARIZED CAP
C19 | 100n | C_0402 | C0402 | NON-POLARIZED CAP
C20 | 4u7 | C_0603 | C0603 | NON-POLARIZED CAP
C21 | 100n | C_0402 | C0402 | NON-POLARIZED CAP
C22 | 100u | C_1206 | C1206 | NON-POLARIZED CAP
C23 | 10u | C_0603 | C0603 | NON-POLARIZED CAP
C24 | 100n | C_0402 | C0402 | NON-POLARIZED CAP
C25 | 10n | C_0402 | C0402 | NON-POLARIZED CAP
C26 | 68p | C_0402 | C0402 | NON-POLARIZED CAP
C27 | 100n | C_0402 | C0402 | NON-POLARIZED CAP
C28 | 15p | C_0402 | C0402 | NON-POLARIZED CAP
C29 | 1u | C_0402 | C0402 | NON-POLARIZED CAP
C30 | 100n | C_0402 | C0402 | NON-POLARIZED CAP
C31 | 100n | C_0402 | C0402 | NON-POLARIZED CAP
C32 | 10u | C_0402 | C0402 | NON-POLARIZED CAP
C33 | 100n | C_0402 | C0402 | NON-POLARIZED CAP
C34 | 100n | C_0402 | C0402 | NON-POLARIZED CAP
C35 | 100n | C_0402 | C0402 | NON-POLARIZED CAP
C36 | 47p | C_0402 | C0402 | NON-POLARIZED CAP
C37 | 1u | C_0603 | C0603 | NON-POLARIZED CAP
D1 | SS24FL | SS24FL | SODFL3617X108N | Schottky Diodes & Rectifiers 40V
D2 | PESD0402-140 | PESD0402-140 | DIONC1005X43N | TVS Diode Bi-Directional PESD0402-140 40V
D3 | PESD0402-140 | PESD0402-140 | DIONC1005X43N | TVS Diode Bi-Directional PESD0402-140 40V
D4 | PESD0402-140 | PESD0402-140 | DIONC1005X43N | TVS Diode Bi-Directional PESD0402-140 40V
D5 | PESD0402-140 | PESD0402-140 | DIONC1005X43N | TVS Diode Bi-Directional PESD0402-140 40V
D6 | PESD0402-140 | PESD0402-140 | DIONC1005X43N | TVS Diode Bi-Directional PESD0402-140 40V
D7 | PESD0402-140 | PESD0402-140 | DIONC1005X43N | TVS Diode Bi-Directional PESD0402-140 40V
D8 | PESD0402-140 | PESD0402-140 | DIONC1005X43N | TVS Diode Bi-Directional PESD0402-140 40V
FB1 | BLM18PG471SZ1D | BLM18PG471SZ1D | BEADC1608X95N | Ferrite Beads 0603 470ohms 1000mA Auto Infotainment | Ferrite Beads 0603 470ohms 1000mA Auto Infotainment | 0.95mm | Murata Electronics | BLM18PG471SZ1D | 81-BLM18PG471SZ1D | https://www.mouser.com/Search/Refine.aspx?Keyword=81-BLM18PG471SZ1D
FB2 | BLM15HD102SN1D | BLM15HD102SN1D | BEADC1005X55N | MURATA - BLM15HD102SN1D - FERRITE BEAD
FB3 | BLM15HD102SN1D | BLM15HD102SN1D | BEADC1005X55N | MURATA - BLM15HD102SN1D - FERRITE BEAD
IC1 | ATSAMD21G18A-AU | ATSAMD21G18A-AU | QFP50P900X900X120-48N | ATMEL - ATSAMD21G18A-AU - MCU
IC2 | SARA-R410M-02B | SARA-R410M-02B | SARA-U201-03B | Size-optimized LTE Cat M1/NB1 and EGPRS modules | Size-optimized LTE Cat M1/NB1 and EGPRS modules | mm | U-Blox | SARA-R410M-02B
IC3 | BQ24195LRGET | BQ24195LRGET | QFN50P400X400X100-25N | I2C Controlled 2.5A/4.5A Single Cell Charger with 5.1V 1.3A/2.1A Synchronous Boost Operation | I2C Controlled 2.5A/4.5A Single Cell Charger with 5.1V 1.3A/2.1A Synchronous Boost Operation | 1mm | Texas Instruments | BQ24195LRGET | 595-BQ24195LRGET | https://www.mouser.com/Search/Refine.aspx?Keyword=595-BQ24195LRGET
IC4 | TPS54232D | TPS54232D | SOIC127P600X175-8N | TPS54232D |  |  |  |  |  |  |  |  | 8-Pin SOIC";"1.75mm";"Texas Instruments";"TPS54232D";"595-TPS54232D";"https://www.mouser.com/Search/Refine.aspx?Keyword=595-TPS54232D";"";"";
IC5 | AP2112K-3.3TRG1 | AP2112K-3.3TRG1 | SOT95P282X130-5N | 600mA 3.3V LDO Regulator Enable SOT23-5 DiodesZetex AP2112K-3.3TRG1
IC6 | ATECC508A-MAHDA-T | ATECC508A-MAHDA-T | SON50P300X200X60-9N | Microchip ATECC508A-MAHDA-T 10kb 8-Pin Crypto Authentication IC UDFN | Microchip ATECC508A-MAHDA-T 10kb 8-Pin Crypto Authentication IC UDFN | 0.6mm | Microchip | ATECC508A-MAHDA-T | 556-ATECC508A-MAHDAT | https://www.mouser.com/Search/Refine.aspx?Keyword=556-ATECC508A-MAHDAT
IC7 | SPBTLE-RF0TR | SPBTLE-RF0TR | SPSGRF868 | STMICROELECTRONICS - SPBTLE-RF0TR - BLUETOOTH MODULE
IC8 | W25Q16JVZPIQ | W25Q16JVZPIQ | SON127P600X500X80-9N | IC FLASH 16MBIT 133MHZ 8WSON | IC FLASH 16MBIT 133MHZ 8WSON | 0.8mm | Winbond | W25Q16JVZPIQ | 454-W25Q16JVZPIQ | https://www.mouser.com/Search/Refine.aspx?Keyword=454-W25Q16JVZPIQ
IC9 | TJA1048TK
IC10 | MCP2515T-I_ST | MCP2515T-I_ST | SOP65P640X120-20N | Stand-Alone CAN Controller SPI TSSOP20 Microchip MCP2515T-I/ST
IC11 | MCP2515T-I_ST | MCP2515T-I_ST | SOP65P640X120-20N | Stand-Alone CAN Controller SPI TSSOP20 Microchip MCP2515T-I/ST
IC12 | CSTCE16M0V53C-R0 | CSTCE16M0V53C-R0 | CSTCE16M0V53CR0 | SMD Ceramic Resonator 16 MHz 15PF CSTCE16M0V53C-R0
IC13 | CSTCE16M0V53C-R0 | CSTCE16M0V53C-R0 | CSTCE16M0V53CR0 | SMD Ceramic Resonator 16 MHz 15PF CSTCE16M0V53C-R0
J1 | SF56S006V4BR2000 | SF56S006V4BR2000 | SF56S006V4BR2000 | Memory Card Connectors microSIM LOW PROFILE PUSH-PUSH | Memory Card Connectors microSIM LOW PROFILE PUSH-PUSH | mm | JAE Electronics | SF56S006V4BR2000 | 656-SF56S006V4BR2000 | https://www.mouser.com/Search/Refine.aspx?Keyword=656-SF56S006V4BR2000
J2 | 1040310811 | 1040310811 | 1040310811 | MICRO SD card socket
L1 | SRN6045-150M | SRN6045-150M | SRN6045_1 | Power Inductor semi-shielded SMD 15uH Bourns SRN6045 Series Shielded Wire-wound SMD Inductor with a Ferrite Core
L2 | SRP4020TA-2R2M | SRP4020TA-2R2M | INDC4441X200N | Bourns SRP4020TA Series Shielded Wire-wound SMD Inductor with a Carbonyl Powder Core
LED1 | HSMD-C190 | HSMD-C190 | LEDC1608X80N | Broadcom HSMD-C190 Orange LED
LED2 | HSMG-C190 | HSMG-C190 | LEDC1608X90N | Broadcom HSMG-C190 Green LED
LED3 | HSMS-C190 | HSMS-C190 | LEDC1608X90N | Broadcom HSMS-C190 Red LED
LED4 | HSMR-C190 | HSMR-C190 | LEDC1608X80N | ChipLED
Q1 | SIA817EDJ-T1-GE3 | SIA817EDJ-T1-GE3 | SIA537EDJT1GE3 | MOSFET -30V Vds 12V Vgs PowerPAK SC-70 | MOSFET -30V Vds 12V Vgs PowerPAK SC-70 | 0mm | Vishay | SIA817EDJ-T1-GE3 | 78-SIA817EDJ-T1-GE3 | https://www.mouser.com/Search/Refine.aspx?Keyword=78-SIA817EDJ-T1-GE3
Q2 | 2N7002
Q3 | 2N7002
Q4 | 2N7002DW-7-F | 2N7002DW-7-F | SOT65P210X100-6N | Diodes Inc 2N7002DW-7-F Dual N-channel MOSFET
Q5 | BSP76E6433HUMA1 | BSP76E6433HUMA1 | SOT230P700X170-4N | INFINEON - BSP76E6433HUMA1 - POWER LOAD SW
Q6 | BSP76E6433HUMA1 | BSP76E6433HUMA1 | SOT230P700X170-4N | INFINEON - BSP76E6433HUMA1 - POWER LOAD SW
R1 | 10k2 | R_0402 | R0402 | RESISTOR
R2 | 1k91 | R_0402 | R0402 | RESISTOR
R3 | 12k7 | R_0402 | R0402 | RESISTOR
R4 | 5k49 | R_0402 | R0402 | RESISTOR
R5 | 10k | R_0402 | R0402 | RESISTOR
R6 | 1M2 | R_0402 | R0402 | RESISTOR
R7 | 330R | R_0402 | R0402 | RESISTOR
R8 | 1M2 | R_0402 | R0402 | RESISTOR
R9 | 1M2 | R_0402 | R0402 | RESISTOR
R10 | 1M2 | R_0402 | R0402 | RESISTOR
R11 | 1M2 | R_0402 | R0402 | RESISTOR
R12 | 390R | R_0402 | R0402 | RESISTOR
R13 | 330R | R_0402 | R0402 | RESISTOR
R14 | 0R | R_0402 | R0402 | RESISTOR
R15 | 330R | R_0402 | R0402 | RESISTOR
R16 | 1M2 | R_0402 | R0402 | RESISTOR
R17 | 1M2 | R_0402 | R0402 | RESISTOR
R18 | 1M2 | R_0402 | R0402 | RESISTOR
R19 | 1M2 | R_0402 | R0402 | RESISTOR
R20 | 0R | R_1206 | R1206 | RESISTOR
R21 | 0R | R_1206 | R1206 | RESISTOR
R22 | 10k | R_0402 | R0402 | RESISTOR
R23 | 10k | R_0402 | R0402 | RESISTOR
R24 | 10k2 | R_0402 | R0402 | RESISTOR
R25 | 10k2 | R_0402 | R0402 | RESISTOR
R26 | 10k2 | R_0402 | R0402 | RESISTOR
R27 | 10k2 | R_0402 | R0402 | RESISTOR
R28 | 10k2 | R_0402 | R0402 | RESISTOR
R29 | 10k2 | R_0402 | R0402 | RESISTOR
R30 | 10k2 | R_0402 | R0402 | RESISTOR
R31 | 10k2 | R_0402 | R0402 | RESISTOR
R32 | 330R | R_0402 | R0402 | RESISTOR
SHIFTER1:IC1 | SN74LVC1T45DPKR | SN74LVC1T45DPKR | SN74LVC1T45DPKR | Single-Bit Dual-Supply Bus Transceiver with Configurable Voltage-Level Shifting and 3-State Outputs | Single-Bit Dual-Supply Bus Transceiver with Configurable Voltage-Level Shifting and 3-State Outputs | mm | Texas Instruments | SN74LVC1T45DPKR | 595-SN74LVC1T45DPKR | https://www.mouser.com/Search/Refine.aspx?Keyword=595-SN74LVC1T45DPKR
SHIFTER1:IC2 | SN74LVC1T45DPKR | SN74LVC1T45DPKR | SN74LVC1T45DPKR | Single-Bit Dual-Supply Bus Transceiver with Configurable Voltage-Level Shifting and 3-State Outputs | Single-Bit Dual-Supply Bus Transceiver with Configurable Voltage-Level Shifting and 3-State Outputs | mm | Texas Instruments | SN74LVC1T45DPKR | 595-SN74LVC1T45DPKR | https://www.mouser.com/Search/Refine.aspx?Keyword=595-SN74LVC1T45DPKR
SHIFTER1:IC3 | SN74LVC1T45DPKR | SN74LVC1T45DPKR | SN74LVC1T45DPKR | Single-Bit Dual-Supply Bus Transceiver with Configurable Voltage-Level Shifting and 3-State Outputs | Single-Bit Dual-Supply Bus Transceiver with Configurable Voltage-Level Shifting and 3-State Outputs | mm | Texas Instruments | SN74LVC1T45DPKR | 595-SN74LVC1T45DPKR | https://www.mouser.com/Search/Refine.aspx?Keyword=595-SN74LVC1T45DPKR
SHIFTER1:IC4 | SN74LVC1T45DPKR | SN74LVC1T45DPKR | SN74LVC1T45DPKR | Single-Bit Dual-Supply Bus Transceiver with Configurable Voltage-Level Shifting and 3-State Outputs | Single-Bit Dual-Supply Bus Transceiver with Configurable Voltage-Level Shifting and 3-State Outputs | mm | Texas Instruments | SN74LVC1T45DPKR | 595-SN74LVC1T45DPKR | https://www.mouser.com/Search/Refine.aspx?Keyword=595-SN74LVC1T45DPKR
U$1 | MAX-M8 | MAX-M8 | MAX-M8 | u-blox MAX GNSS module
Y1 | ABS07-32.768KHZ-1-T | ABS07-32.768KHZ-1-T | ABS0716632768KHZT | Abracon 32.768kHz Crystal Unit +/-10ppm SMD 2-Pin 3.2 x 1.5 x 0.9mm | Abracon 32.768kHz Crystal Unit +/-10ppm SMD 2-Pin 3.2 x 1.5 x 0.9mm | 0.9mm | ABRACON | ABS07-32.768KHz-1-T | 815-ABS07-32.7K-1-T | https://www.mouser.com/Search/Refine.aspx?Keyword=815-ABS07-32.7K-1-T
