WaiveCar/WaiveTelem/Hardware/BOMSierra-003.xlsx

BOM
Assembly Part Number/Revision:
Customer / Company Name: Guest guest / Guest
Item # | Quantity per board | Manufacturer Part # | Do Not Install | Reference designators | Vendor (optional) | Vendor Part Number (optional) | Part description/ specs (optional, but recommended) | Manfacturer (optional) | Remarks (if any)
1 | 1 | ZX62-AB-5PA(31) |  | J5 | Digi-Key | H125279CT-ND | CONN RCPT USB2.0 MICRO AB SMD RA | Hirose Electric Co Ltd
2 | 3 | RMCF0402ZT0R00 |  | R5, R14, R34 | Digi-Key | RMCF0402ZT0R00CT-ND | RES 0 OHM JUMPER 1/16W 0402 | Stackpole Electronics Inc
3 | 2 | CR1206-J/-000ELF |  | R20, R21 | Digi-Key | CR1206-J/-000ELFCT-ND | RES SMD 0 OHM JUMPER 1/4W 1206 | Bourns Inc.
4 | 17 | GCM155R71C104KA55J |  | C2, C18, C19, C21, C24, C27, C30, C31, C33, C34, C35, C38, C44, C45, C52, C53, C54 | Digi-Key | 490-7998-1-ND | CAP CER 0.1UF 16V X7R 0402 | Murata Electronics North America
5 | 1 | GCM1555C1H101JA16D |  | C51 | Digi-Key | 490-10669-1-ND | CAP CER 100PF 50V C0G/NP0 0402 | Murata Electronics North America
6 | 1 | GRM31CD80J107ME39L |  | C22 | Digi-Key | 490-10525-1-ND | CAP CER 100UF 6.3V X6T 1206 | Murata Electronics North America
7 | 1 | 1040310811 |  | J2 | Digi-Key | WM6357CT-ND | CONN MICRO SD CARD PUSH-PULL R/A | Molex
8 | 1 | CRGCQ0402F10R |  | R13 | Digi-Key | A129603CT-ND | CRGCQ 0402 10R 1% | TE Connectivity Passive Product
9 | 5 | RMCF0402FT10K0 |  | R15, R22, R23, R36, R40 | Digi-Key | RMCF0402FT10K0CT-ND | RES 10K OHM 1% 1/16W 0402 | Stackpole Electronics Inc
10 | 1 | RNCP0603FTD10K0 |  | R4 | Digi-Key | RNCP0603FTD10K0CT-ND | RES 10K OHM 1% 1/8W 0603 | Stackpole Electronics Inc
11 | 1 | CRCW040210K2FKED |  | R1 | Mouser | 71-CRCW0402-10.2K-E3 | Thick Film Resistors - SMD 1/16watt 10.2Kohms 1% | Vishay / Dale
12 | 8 | RMCF0402FT10K2 |  | R24, R25, R26, R27, R28, R29, R30, R31 | Digi-Key | RMCF0402FT10K2CT-ND | RES 10.2K OHM 1% 1/16W 0402 | Stackpole Electronics Inc
13 | 2 | GCM155R71H103KA55D |  | C25, C40 | Digi-Key | 490-4762-1-ND | CAP CER 10000PF 50V X7R 0402 | Murata Electronics North America
14 | 1 | GCM1555C1H100JA16D |  | C3 | Digi-Key | 490-10668-1-ND | CAP CER 10PF 50V C0G/NP0 0402 | Murata Electronics North America
15 | 1 | GRM155C80J106ME11D |  | C32 | Digi-Key | 490-13233-1-ND | CAP CER 10UF 6.3V X6S 0402 | Murata Electronics North America
16 | 3 | GRM188R60J106KE47D |  | C20, C23, C50 | Digi-Key | 490-12538-1-ND | CAP CER 10UF 6.3V X5R 0603 | Murata Electronics North America
17 | 2 | GRM21BC81C106KE15L |  | C6, C11 | Digi-Key | 490-10498-1-ND | CAP CER 10UF 16V X6S 0805 | Murata Electronics North America
18 | 1 | GCM1555C1H150JA16D |  | C28 | Digi-Key | 490-11147-1-ND | CAP CER 15PF 50V C0G/NP0 0402 | Murata Electronics North America
19 | 8 | RMCF0402FT1M20 |  | R6, R11, R12, R16, R17, R18, R19, R33 | Digi-Key | RMCF0402FT1M20CT-ND | RES 1.2M OHM 1% 1/16W 0402 | Stackpole Electronics Inc
20 | 1 | CRCW04021K96FKED |  | R2 | Digi-Key | 541-1.96KLCT-ND | RES SMD 1.96K OHM 1% 1/16W 0402 | Vishay Dale
21 | 3 | GRM155R61C105MA12D |  | C8, C9, C29 | Digi-Key | 490-14599-1-ND | CAP CER 1UF 16V X5R 0402 | Murata Electronics North America
22 | 1 | GRT188C8YA105KE13D |  | C37 | Digi-Key | 490-12297-1-ND | CAP CER 1UF 35V X6S 0603 | Murata Electronics North America
23 | 2 | GJM1555C1H200GB01D |  | C16, C17 | Digi-Key | 490-8090-1-ND | CAP CER 20PF 50V C0G/NP0 0402 | Murata Electronics North America
24 | 1 | L-14C27NJV4T |  | L3 | Digi-Key | 712-1439-1-ND | FIXED IND 27NH 300MA 600 MOHM | Johanson Technology Inc.
25 | 1 | RMCF0402FT28K0 |  | R3 | Digi-Key | RMCF0402FT28K0CT-ND | RES 28K OHM 1% 1/16W 0402 | Stackpole Electronics Inc
26 | 2 | 2N7002,215 |  | Q2, Q3 | Digi-Key | 1727-2764-1-ND | MOSFET N-CH 60V 300MA SOT-23 | Nexperia USA Inc.
27 | 2 | 2N7002DW-7-F |  | Q1, Q4 | Digi-Key | 2N7002DW-FDICT-ND | MOSFET 2N-CH 60V 0.23A SOT-363 | Diodes Incorporated
28 | 1 | GCM155R71H222KA37D |  | C4 | Digi-Key | 490-4914-1-ND | CAP CER 2200PF 50V X7R 0402 | Murata Electronics North America
29 | 1 | RMCF0402FT39R0 |  | R39 | Digi-Key | RMCF0402FT39R0CT-ND | RES 39 OHM 1% 1/16W 0402 | Stackpole Electronics Inc
30 | 1 | RMCF0402FT40K2 |  | R35 | Digi-Key | RMCF0402FT40K2CT-ND | RES 40.2K OHM 1% 1/16W 0402 | Stackpole Electronics Inc
31 | 1 | 43045-1400 |  | J4 | Digi-Key | WM4723-ND | CONN HEADER R/A 14POS 3MM | Molex
32 | 1 | CRGCQ0402J470R |  | R32 | Digi-Key | A130046CT-ND | CRGCQ 0402 470R 5% | TE Connectivity Passive Product
33 | 1 | GCM1555C1H470JA16J |  | C36 | Digi-Key | 490-17752-1-ND | CAP CER 47PF 50V C0G/NP0 0402 | Murata Electronics North America
34 | 1 | GRM155R71H472KA01J |  | C43 | Digi-Key | 490-8259-1-ND | CAP CER 4700PF 50V X7R 0402 | Murata Electronics North America
35 | 1 | GCM1555C1H680JA16D |  | C26 | Digi-Key | 490-12653-1-ND | CAP CER 68PF 50V C0G/NP0 0402 | Murata Electronics North America
36 | 1 | GRM033R71A822KA01D |  | C5 | Digi-Key | 490-11356-1-ND | CAP CER 8200PF 10V X7R 0201 | Murata Electronics North America
37 | 1 | ABS07-32.768KHz-1-T |  | Y1 | Digi-Key | 535-9808-1-ND | CRYSTAL 32.7680KHZ 12.5PF SMDCRYSTAL 32.7680KHZ 12.5PF SMD | Abracon LLC
38 | 1 | AP2112K-3.3TRG1 |  | IC3 | Digi-Key | AP2112K-3.3TRG1DICT-ND | IC REG LINEAR 3.3V 600MA SOT25 | Diodes Incorporated
39 | 1 | ATECC508A-MAHDA-T |  | IC6 | Digi-Key | ATECC508A-MAHDA-TCT-ND | IC AUTHENTICATION CHIP 8UDFN | Microchip Technology
40 | 1 | ATSAMD21G18A-AU |  | IC1 | Digi-Key | ATSAMD21G18A-AU-ND | IC MCU 32BIT 256KB FLASH 48TQFP | Microchip Technology
41 | 1 | BAT60AE6327HTSA1 |  | D9 | Digi-Key | BAT60AE6327HTSA1CT-ND | DIODE SCHOTTKY 10V 3A SOD323-2 | Infineon Technologies
42 | 2 | BLM15HD102SN1D |  | FB2, FB3 | Digi-Key | 490-4003-1-ND | FERRITE BEAD 1 KOHM 0402 1LN | Murata Electronics North America
43 | 1 | BLM18PG471SZ1D |  | FB1 | Digi-Key | 490-16495-1-ND | FERRITE BEAD 470 OHM 0603 1LN | Murata Electronics North America
44 | 2 | BSP76E6433HUMA1 |  | Q5, Q6 | Digi-Key | BSP76E6433HUMA1CT-ND | IC SWITCH POWER LOSIDE SOT223-4 | Infineon Technologies
45 | 1 | C2012X5R1A476M125AC |  | C14 | Digi-Key | 445-8239-1-ND | CAP CER 47UF 10V X5R 0805 | TDK Corporation | Original MPN: C2012X5R1A336M125AC changed to new MPN: C2012X5R1A476M125AC by Guest
46 | 2 | C2012X5R1V106K085AC |  | C12, C13 | Digi-Key | 445-14417-1-ND | CAP CER 10UF 35V X5R 0805 | TDK Corporation
47 | 2 | GMK316AB7106KL-TR |  | C1, C10 | Digi-Key | 587-3007-1-ND | CAP CER 10UF 35V X7R 1206 | Taiyo Yuden | Direct substitute of original MPN: C3216X7R1V106K160AC chosen. New MPN: GMK316AB7106KL-TR by Guest
48 | 1 | CRCW0402169KFKED |  | R8 | Digi-Key | 541-169KLCT-ND | RES SMD 169K OHM 1% 1/16W 0402 | Vishay Dale
49 | 1 | CRCW040237K4FKED |  | R7 | Digi-Key | 541-37.4KLCT-ND | RES SMD 37.4K OHM 1% 1/16W 0402 | Vishay Dale
50 | 1 | CRCW040253K6FKED |  | R9 | Digi-Key | 541-53.6KLCT-ND | RES SMD 53.6K OHM 1% 1/16W 0402 | Vishay Dale
51 | 2 | CSTCE16M0V53C-R0 |  | IC12, IC13 | Mouser | 81-CSTCE16M0V53C-R0 | Resonators RECOMMENDED ALT 81-CSTNE16M0V53C000R | Murata Electronics
53 | 1 | DSK-3R3H224U-HL |  | C7 | Digi-Key | 604-1020-1-ND | CAP 220MF -20% +80% 3.3V SMD | Elna America
54 | 1 | EE2-3TNU-L |  | K1 | Digi-Key | 399-11011-1-ND | RELAY GEN PURPOSE DPDT 2A 3VDC | KEMET
55 | 1 | FA1-NCRP-PCB-8 |  | J3 | Mouser | 523-FA1-NCRP-PCB-8 | RF Connectors / Coaxial Connectors R/A MALE FAKRA SMB | Amphenol RF
56 | 1 | FA1-NDRP-PCB-8 |  | J6 | Mouser | 523-FA1-NDRP-PCB-8 | RF Connectors / Coaxial Connectors R/A MALE FAKRA SMB | Amphenol RF
57 | 1 | GRM1555C1H150JA01J |  | C41 | Digi-Key | 490-11376-1-ND | CAP CER 15PF 50V C0G/NP0 0402 | Murata Electronics North America
58 | 1 | GRM1555C1H330JA01J |  | C42 | Mouser | 81-GRM1555C1H330JA1J | Multilayer Ceramic Capacitors MLCC - SMD/SMT RECOMMENDED ALT 81-GRM0335C1H330JA1J | Murata Electronics
59 | 4 | GRM1555C1H470JA01D |  | C46, C47, C48, C49 | Digi-Key | 490-5942-1-ND | CAP CER 47PF 50V C0G/NP0 0402 | Murata Electronics North America
60 | 2 | CC0603KPX7R9BB104 |  | C15, C39 | Digi-Key | 311-3567-1-ND | CAP CER 0.1UF 50V X7R 0603 | Yageo | Direct substitute of original MPN: GRM188R71H104KA93D chosen. New MPN: CC0603KPX7R9BB104 by Guest
61 | 1 | HSMR-C190 |  | LED4 | Digi-Key | 516-2502-1-ND | LED BLUE DIFFUSED CHIP SMD | Broadcom Limited
62 | 1 | HSMS-C190 |  | LED3 | Digi-Key | 516-1422-1-ND | LED RED DIFFUSED CHIP SMD | Broadcom Limited
63 | 1 | LQG15HN39NJ02D |  | L4 | Digi-Key | 490-1092-1-ND | FIXED IND 39NH 250MA 1.06 OHM | Murata Electronics North America
64 | 1 | M50-3600542R |  | J7 | Digi-Key | 952-4189-1-ND | CONN HDR 1.27MM SMD AU 10POS T&R | Harwin Inc.
65 | 1 | MAX-M8Q-0 |  | U$1 | Digi-Key | 672-1003-1-ND | RF RCVR GNSS/GPS 1.575GHZ 18LCC | U-Blox America Inc.
66 | 2 | MBR0560-TP |  | D10, D11 | Digi-Key | MBR0560TPMSCT-ND | DIODE SCHOTTKY 60V 500MA SOD123 | Micro Commercial Co
67 | 2 | MCP2515T-I/ST |  | IC10, IC11 | Digi-Key | MCP2515T-I/STCT-ND | IC CAN CONTROLLER W/SPI 20TSSOP | Microchip Technology
68 | 1 | MINISMDC050F-2 |  | F1 | Digi-Key | MINISMDC050F-2CT-ND | PTC RESET FUSE 24V 500MA 1812 | Littelfuse Inc.
70 | 9 | PESD0402-140 |  | D2, D3, D4, D5, D6, D7, D8, D13, D14 | Digi-Key | PESD0402-140CT-ND | TVS DIODE 14V 40V 0402 | Littelfuse Inc.
71 | 1 | PRTR5V0U2X,215 |  | D12 | Digi-Key | 1727-3884-1-ND | TVS DIODE 5.5V SOT143B | Nexperia USA Inc.
72 | 1 | RC0201FR-0710KL |  | R10 | Digi-Key | 311-10.0KMCT-ND | RES SMD 10K OHM 1% 1/20W 0201 | Yageo
73 | 1 | SARA-R410M-02B |  | IC2 | Digi-Key | 672-1082-1-ND | RF TXRX CELL 4G LTE CATM1/NB-IOT | U-Blox America Inc.
74 | 1 | SF56S006V4BR2000 |  | J1 | Digi-Key | 670-2834-1-ND | CONN MICRO SIM CARD PUSH-PUSH | JAE Electronics
75 | 1 | SN74AVC2T245RSWR |  | U1 | Digi-Key | 296-23684-1-ND | IC TRNSLTR BIDIRECTIONAL 10UQFN | Texas Instruments
76 | 1 | SPBTLE-RF0TR |  | IC7 | Digi-Key | 497-17778-1-ND | MOD VLP BLUETOOTH REV V4.1 | STMicroelectronics
77 | 1 | SRN6045-150M |  | L1 | Digi-Key | SRN6045-150MCT-ND | FIXED IND 15UH 1.9A 95.8 MOHM | Bourns Inc.
78 | 1 | SRU1048-4R7Y |  | L2 | Digi-Key | SRU1048-4R7YCT-ND | FIXED IND 4.7UH 5.5A 9.5 MOHM | Bourns Inc.
79 | 1 | SS13FL |  | D1 | Digi-Key | SS13FLCT-ND | DIODE SCHOTTKY 30V 1A SOD123F | ON Semiconductor
80 | 1 | TJA1048TK,118 |  | IC9 | Mouser | 771-TJA1048TK118 | CAN Interface IC Dual high-speed CAN transceiver with Standby mode | NXP Semiconductors
81 | 1 | TL4100AF120QG |  | S1 | Digi-Key | EG4963CT-ND | SWITCH TACTILE SPST-NO 0.05A 12V | E-Switch
83 | 1 | TPS54232D |  | IC4 | Digi-Key | 296-24037-5-ND | IC REG BUCK ADJUSTABLE 2A 8SOIC | Texas Instruments
84 | 1 | TPS563231DRLR |  | IC5 | Mouser | 595-TPS563231DRLR | Switching Voltage Regulators AUGUSTA3-LC END CHIP SETUP | Texas Instruments
85 | 1 | W25Q16JVZPIQ |  | IC8 | Digi-Key | W25Q16JVZPIQ-ND | IC FLASH 16M SPI 133MHZ 8WSON | Winbond Electronics
52 | 2 | DNI | DNI | R37, R38
69 | 4 | DNI | DNI | H1, H4, H5, H6
82 | 9 | DNI | DNI | TP_1V8, TP_MDCD, TP_MPWR_ON, TP_MRST, TP_MRX, TP_MTX, TP_MUSBN, TP_MUSBP, TP_MVUSB
END OF BOM
