WaiveCar/WaiveTelem/Case/waive-work-logo_w_good.dxf

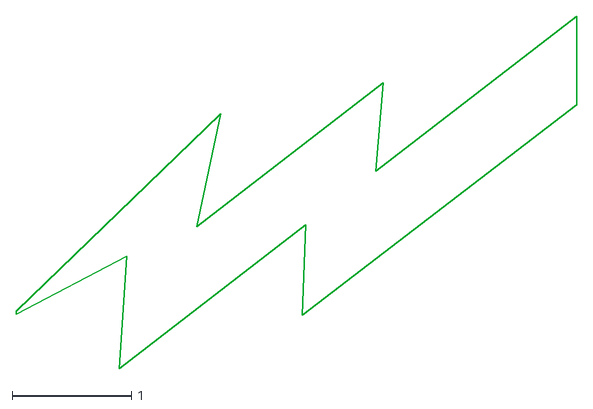
[picture p1: CAD file, 2020-02-20]
Case/waive-work-logo_w_good.dxf
4.70 x 2.95
