WaiveCar/WaiveTelem/Case/top_w_logo_7.STL

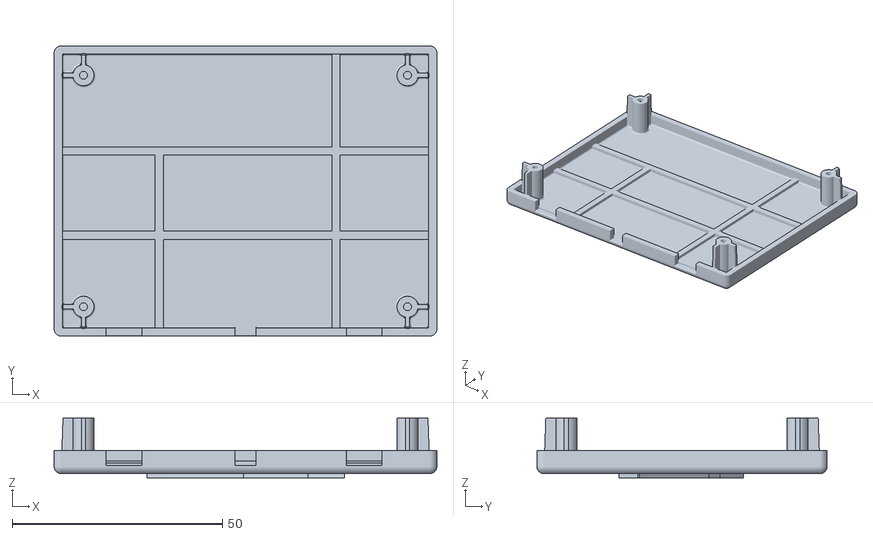
[picture p2: CAD file, 2020-02-06]
Case/top_w_logo_7.STL
91.0 x 69.0 x 14.2
