WaiveCar/WaiveTelem/Case/waive_logo2.SLDPRT

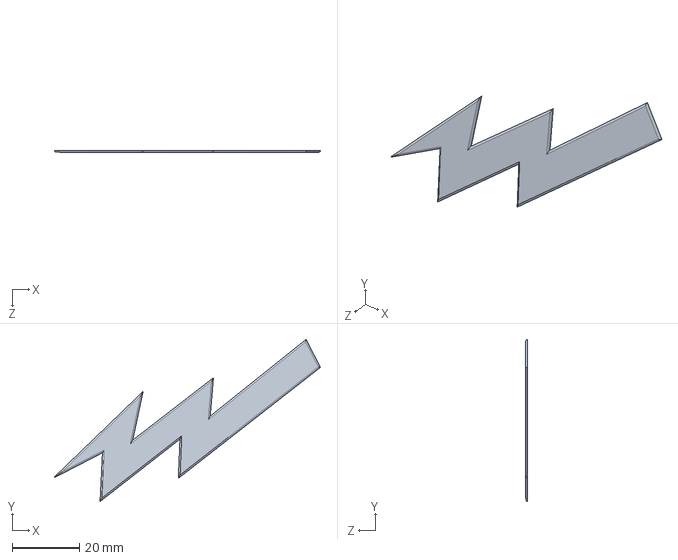
[picture p3: CAD file, 2019-08-29]
Case/waive_logo2.SLDPRT
79.4 x 48.4 x 0.5 mm
