WaiveCar/WaiveTelem/Case/002003-007.SLDPRT

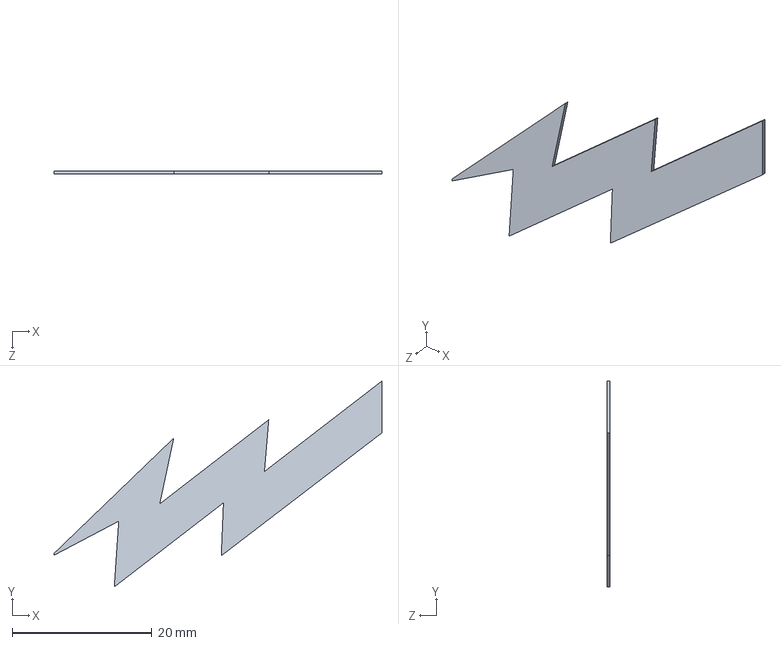
[picture p5: CAD file, 2020-02-20]
Case/002003-007.SLDPRT
47.0 x 29.5 x 0.5 mm
