WaiveCar/WaiveTelem/Case/002001-007.SLDPRT

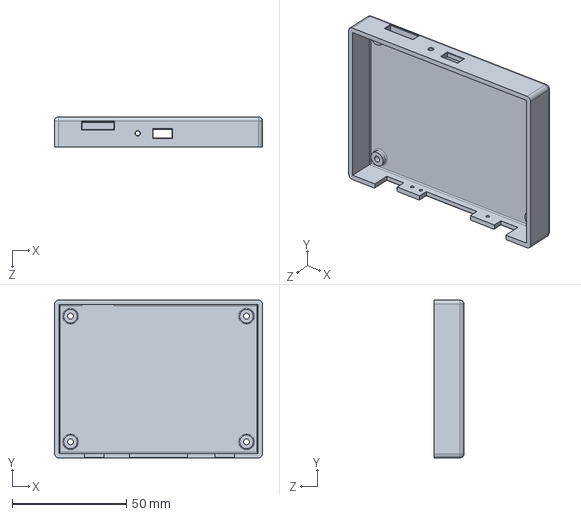
[picture p6: CAD file, 2020-02-20]
Case/002001-007.SLDPRT
91.0 x 69.0 x 13.2 mm
