WaiveCar/WaiveTelem/Case/002002-005.SLDPRT

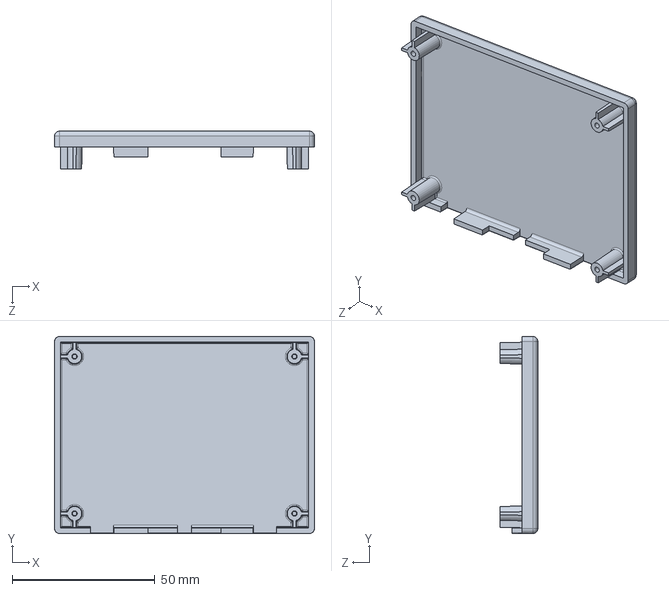
[picture p7: CAD file, 2020-02-06]
Case/002002-005.SLDPRT
91.1 x 69.1 x 13.2 mm
