WaiveCar/WaiveTelem/Case/002003-003.SLDPRT

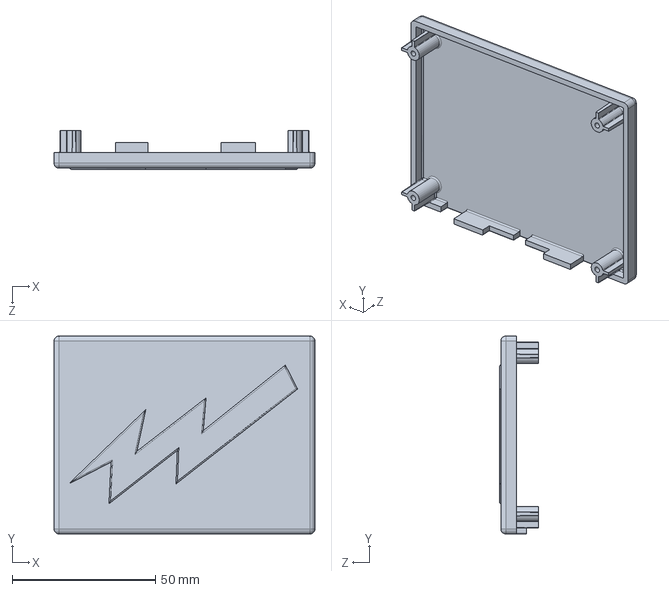
[picture p8: CAD file, 2019-08-29]
Case/002003-003.SLDPRT
91.0 x 69.0 x 13.7 mm
