WaiveCar/WaiveTelem/Case/002001-002.SLDPRT

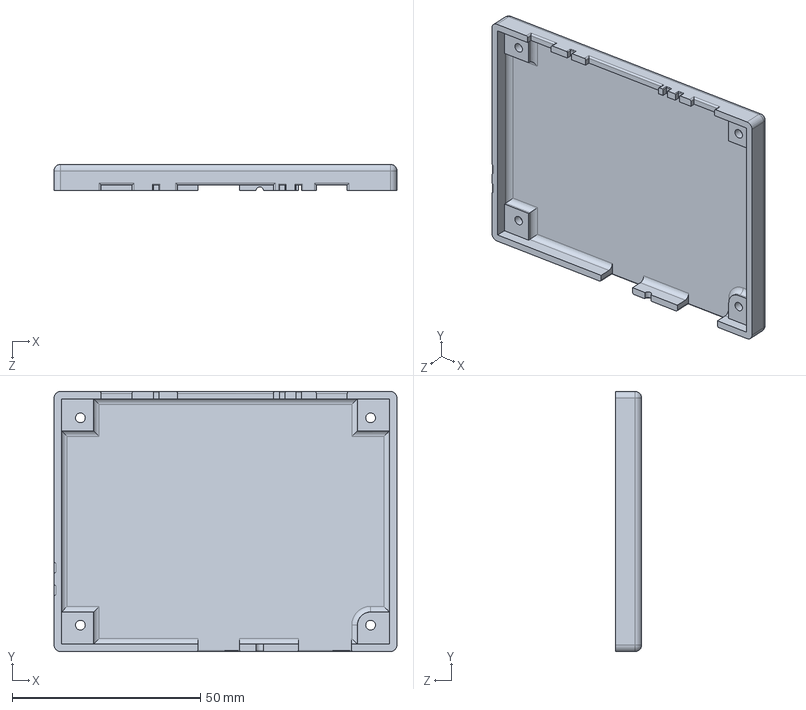
[picture p9: CAD file, 2019-08-23]
Case/002001-002.SLDPRT
91.0 x 69.0 x 7.00 mm
