WaiveCar/WaiveTelem/Case/002003-004.SLDPRT

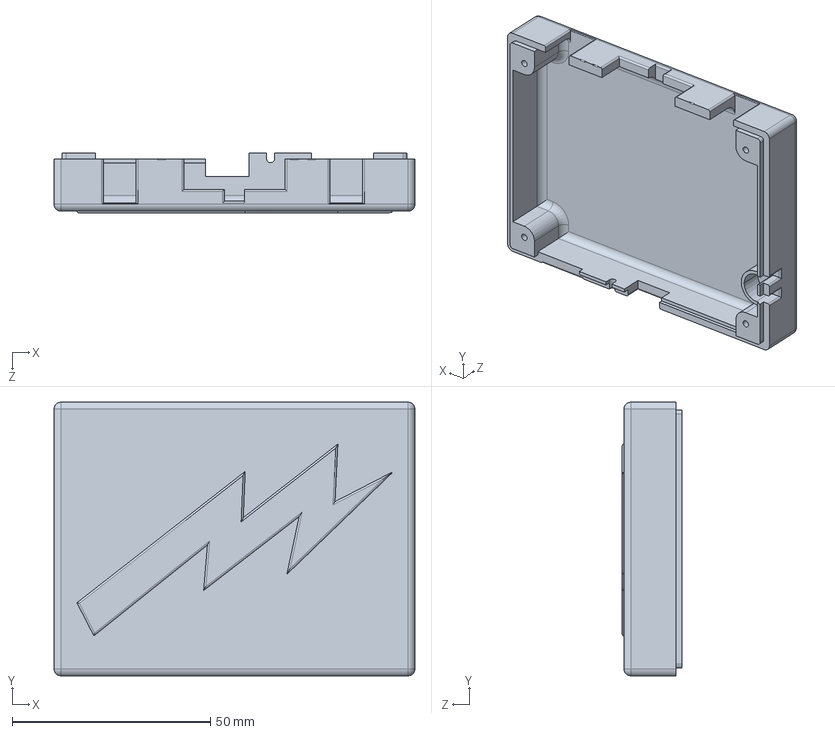
[picture p10: CAD file, 2019-08-23]
Case/002003-004.SLDPRT
91.0 x 69.0 x 15.2 mm
