WaiveCar/WaiveTelem/(list of files, cad)

Other CAD files:
Case/002004-007.SLDPRT
Case/002001-006.STL
Case/002001-005.SLDPRT
Case/002002-003.SLDPRT
Case/002001-003.SLDPRT
Case/002002-002.SLDPRT
Case/002001-003.STL
Case/002001-007.STL
Case/002003-003.STL
Case/002004-007.STL
