WaiveCar/WaiveTelem/Hardware/001000-004-7-18.pdf

10u PA00 1 | PA01 2 | PA02 3 | PA03 4 | GNDANA 5 | VDDANA 6 | PB08 7 | PB09 8 | PA04 9 | PA05 10 | PA06 11 | PA07 12 | PA⁰⁸ 13 PA⁰⁹ 14 PA¹⁰ 15 PA¹¹ 16 VDDIO_1 17 GND_1 18 PB¹⁰ 19 PB¹¹ 20 PA¹² 21 PA¹³ 22 PA¹⁴ 23 PA¹⁵ 24
GND_1 1 | RSVD_1 2 | GND_2 3 | V_INT 4 | GND_3 5 | RSR 6 | RI 7 | DCD 8 | DTR 9 | RTS 10 | CTS 11 | TXD 12 | RXD 13 | GND_4 14 | PWR_ON 15 | GPIO1 16 | VUSB_DET 17 | RESET_N 18 | GPIO6 19 | GND_5 20 | GND_6 21 | GND_7 22 | GPIO2 23 | GPIO3 24 | GPIO4 25 | SDA 26 | SCL 27 | USB_D- 28 | USB_D+ 29 | GND_8 30 | RSVD_2 31 | GND_9 32 | RSVD_3 33

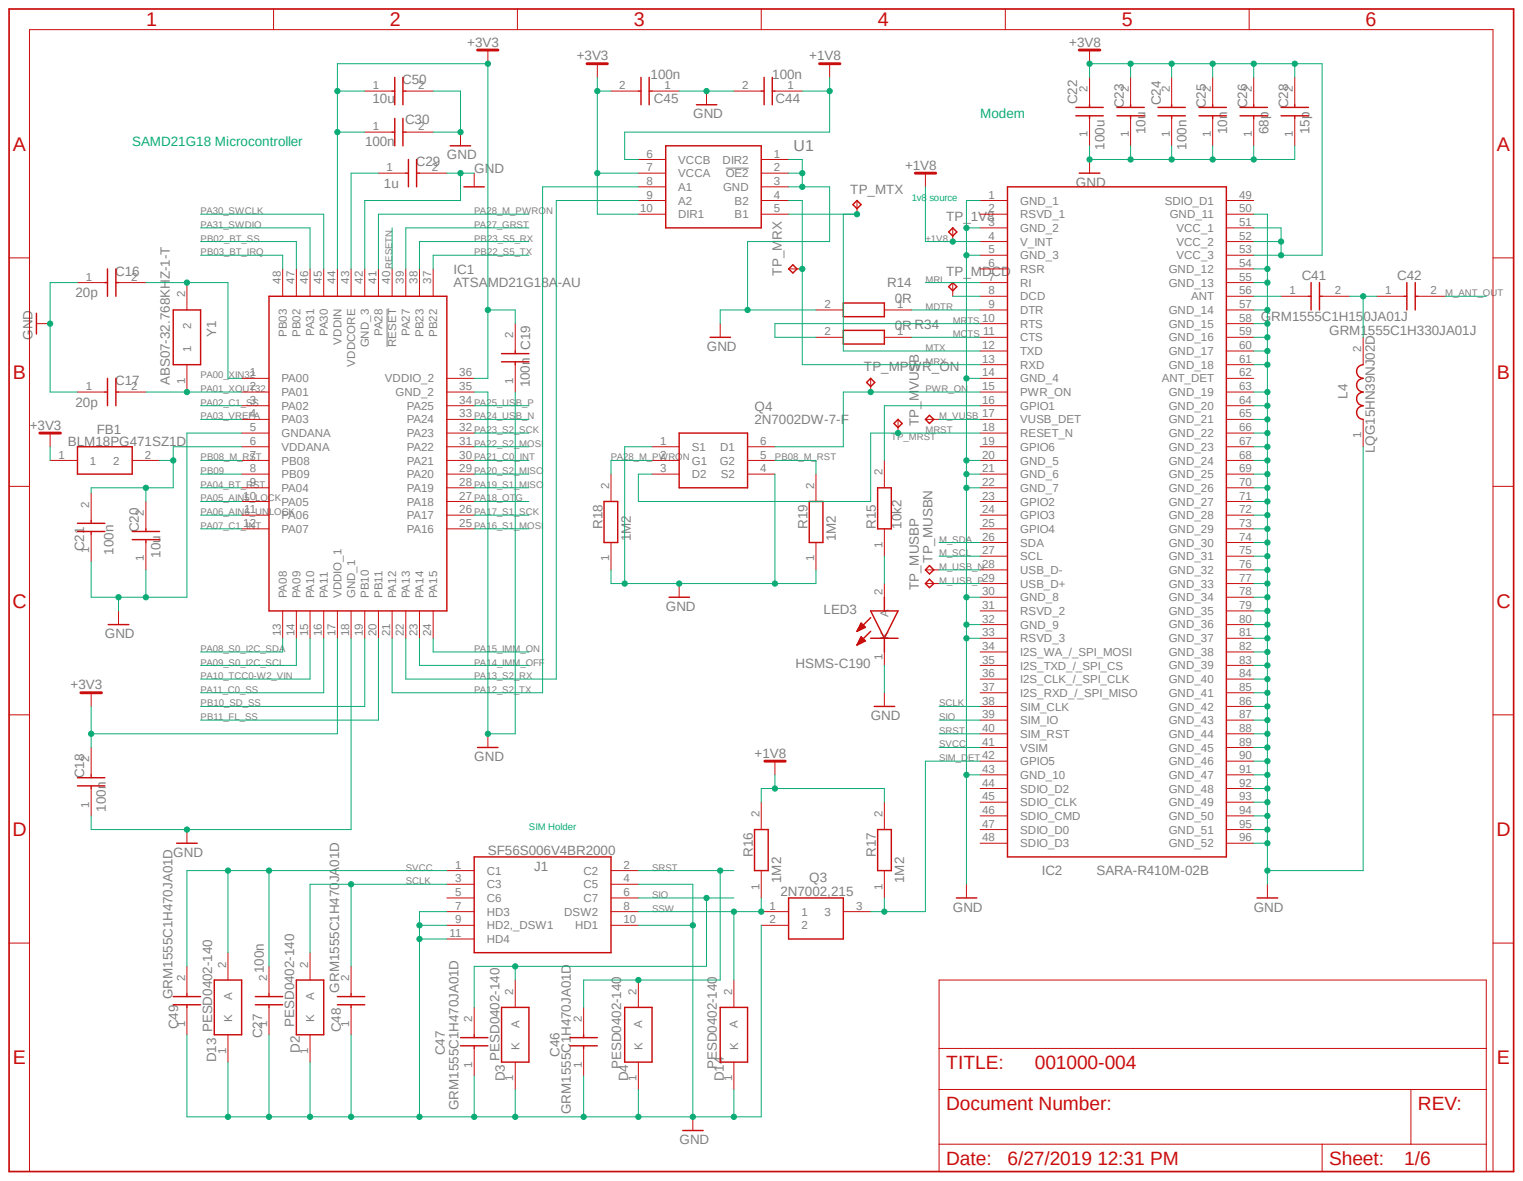
[picture p11: page 1]

+1V8 MRX MCTS MRTS MTX

PA21_C0_INT PA22_S2_MOSI PA23_S2_SCK

PA20_S2_MISO
PA19_S1_MISO

Document Number: | REV:

Date: 6/27/2019 12:31 PM | Sheet: 1/6

MINISMDC050F-2 MINISMDC¹⁵⁰F_24⁻2 | BOOT 1 | VIN 2 | EN 3 | SS 4 | PH | 8 GND | 7 COMP | 6 VSENSE | 5

A

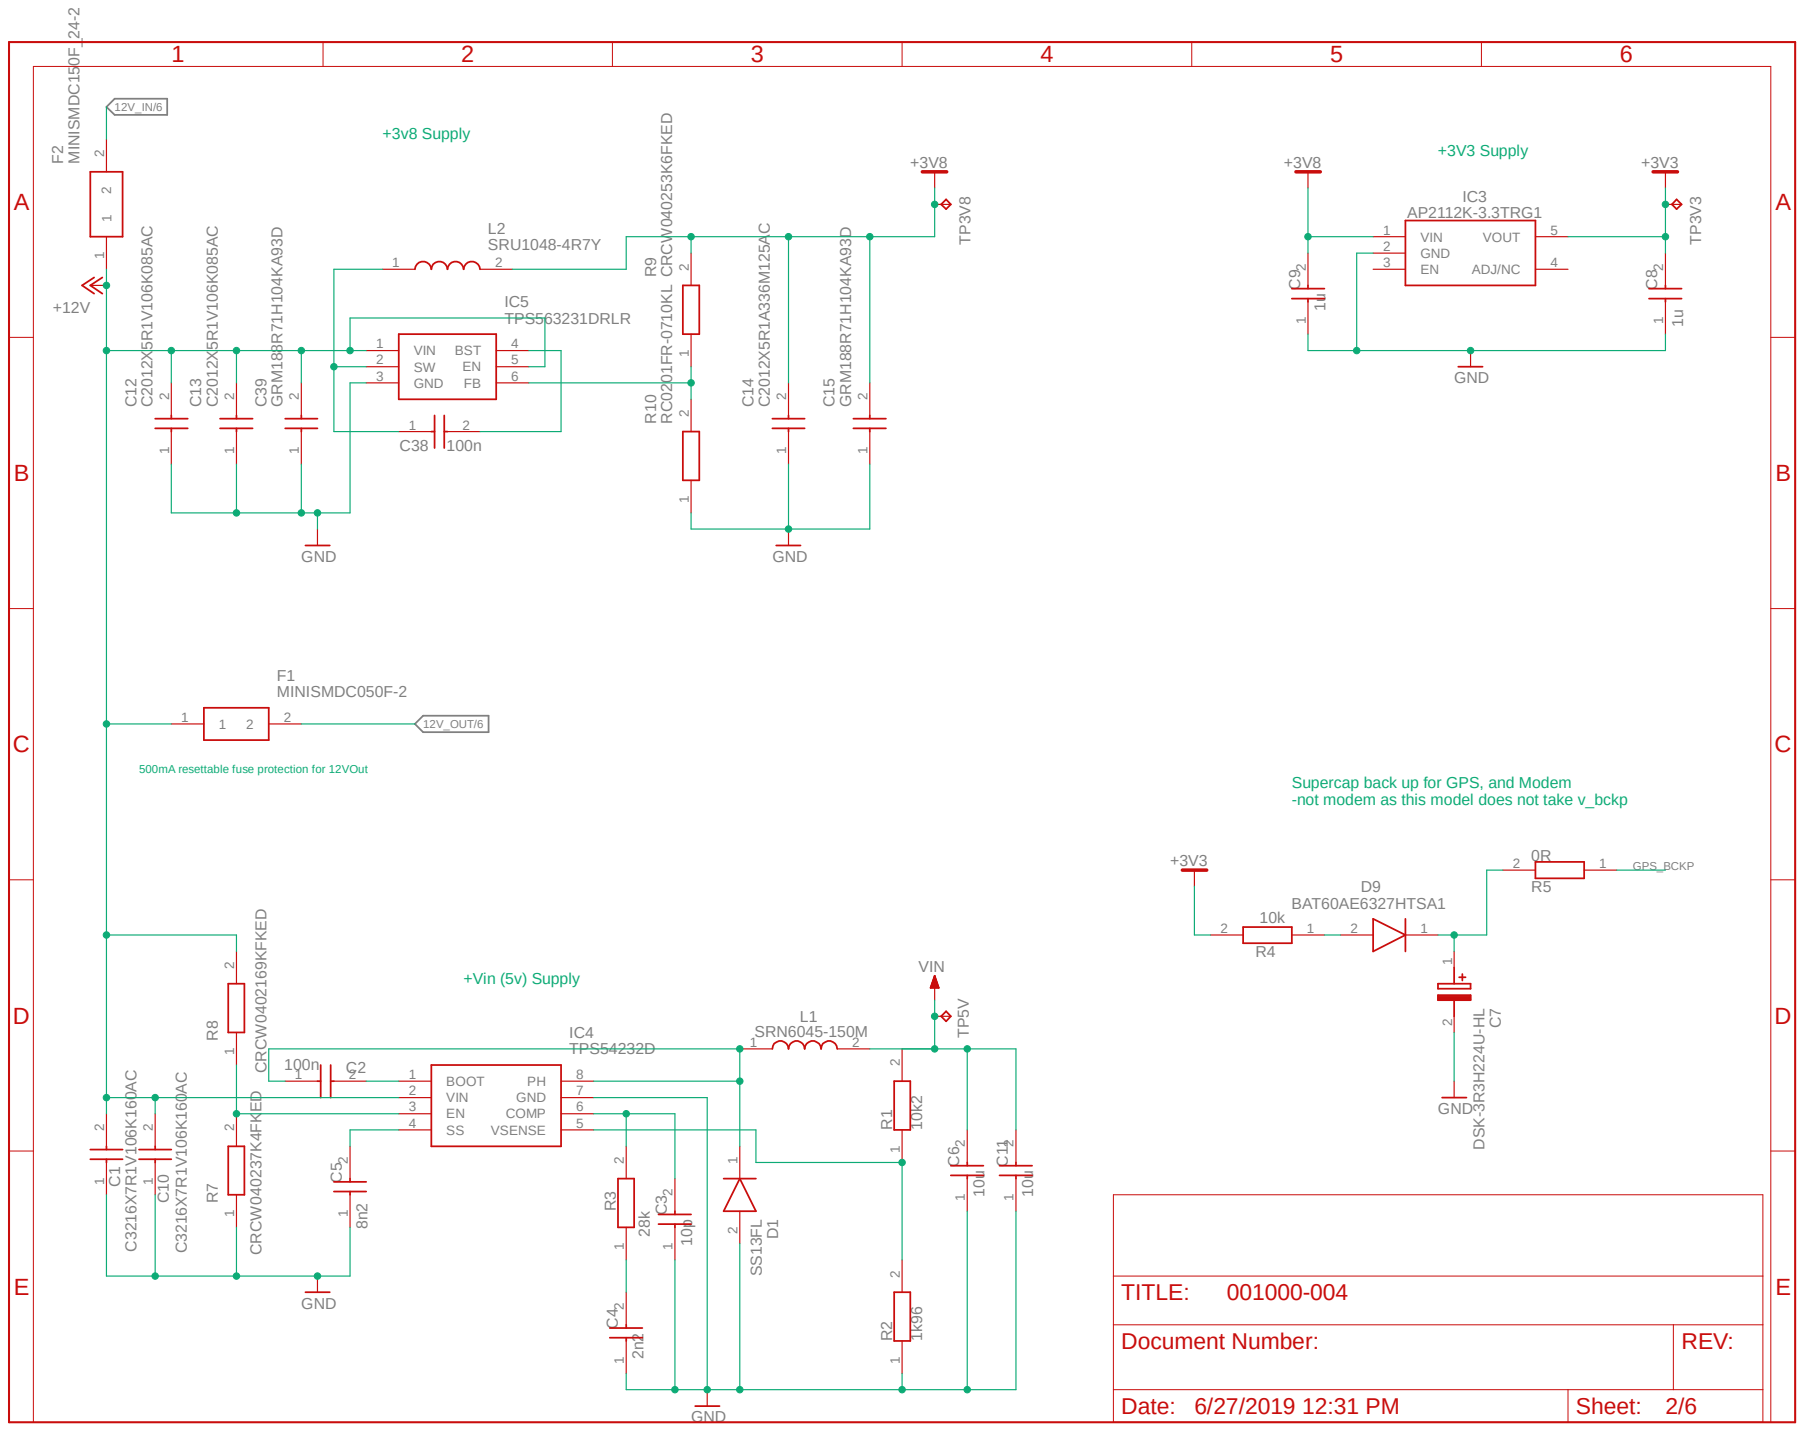
[picture p12: page 2]

500mA resettable fuse protection for 12VOut

Supercap back up for GPS, and Modem
-not modem as this model does not take v_bckp

Document Number: | REV:

+3V3 100n

# IC6 C³¹ 1 2

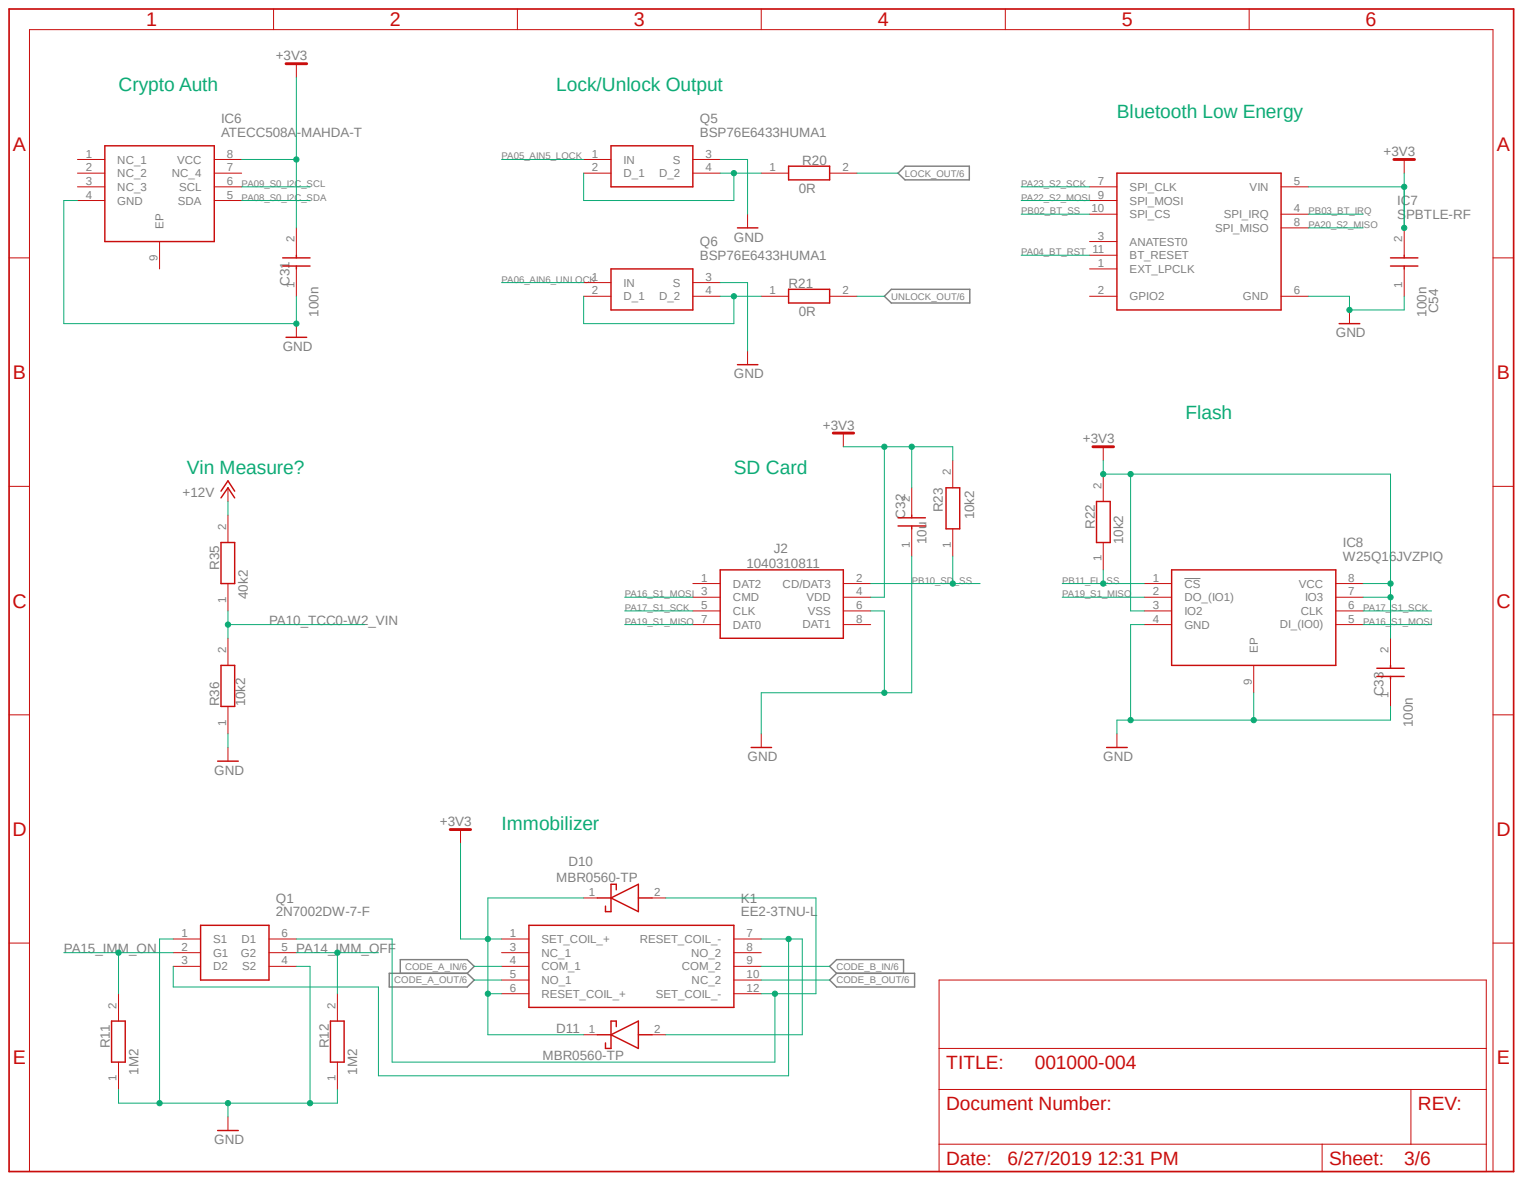
[picture p13: page 3]

Document Number: | REV:

A

A

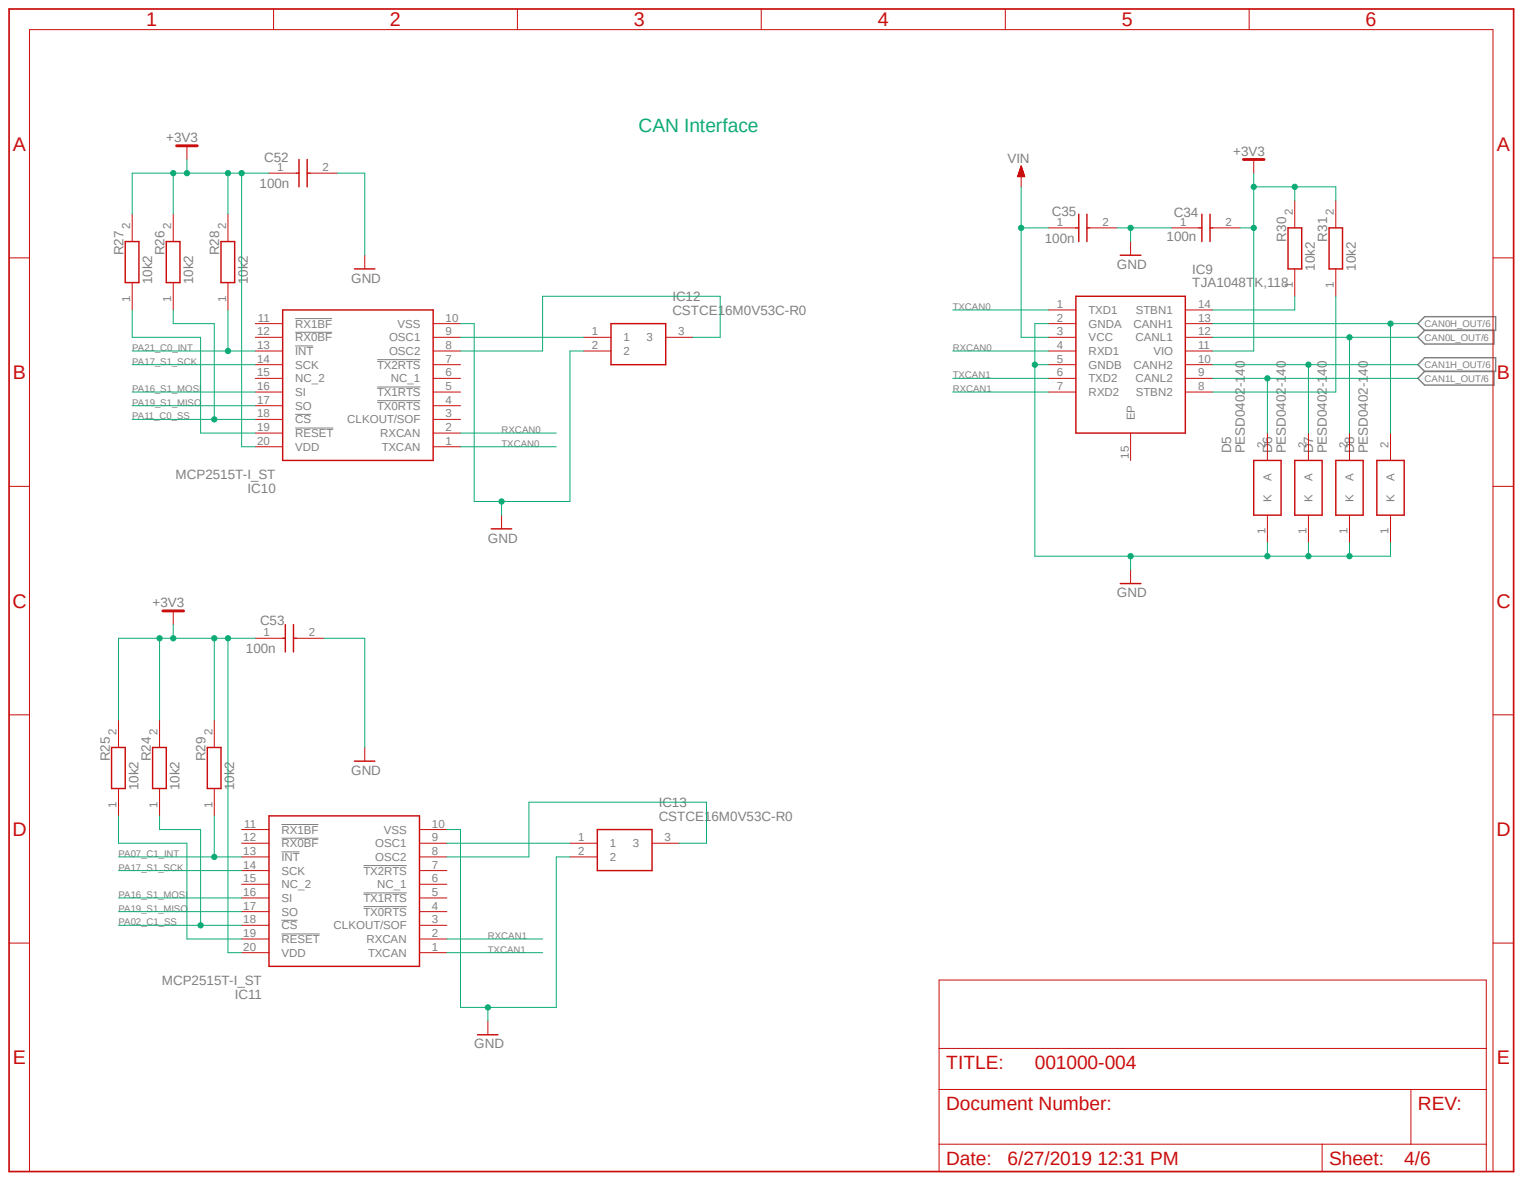
[picture p14: page 4]

Document Number: | REV:

A

A

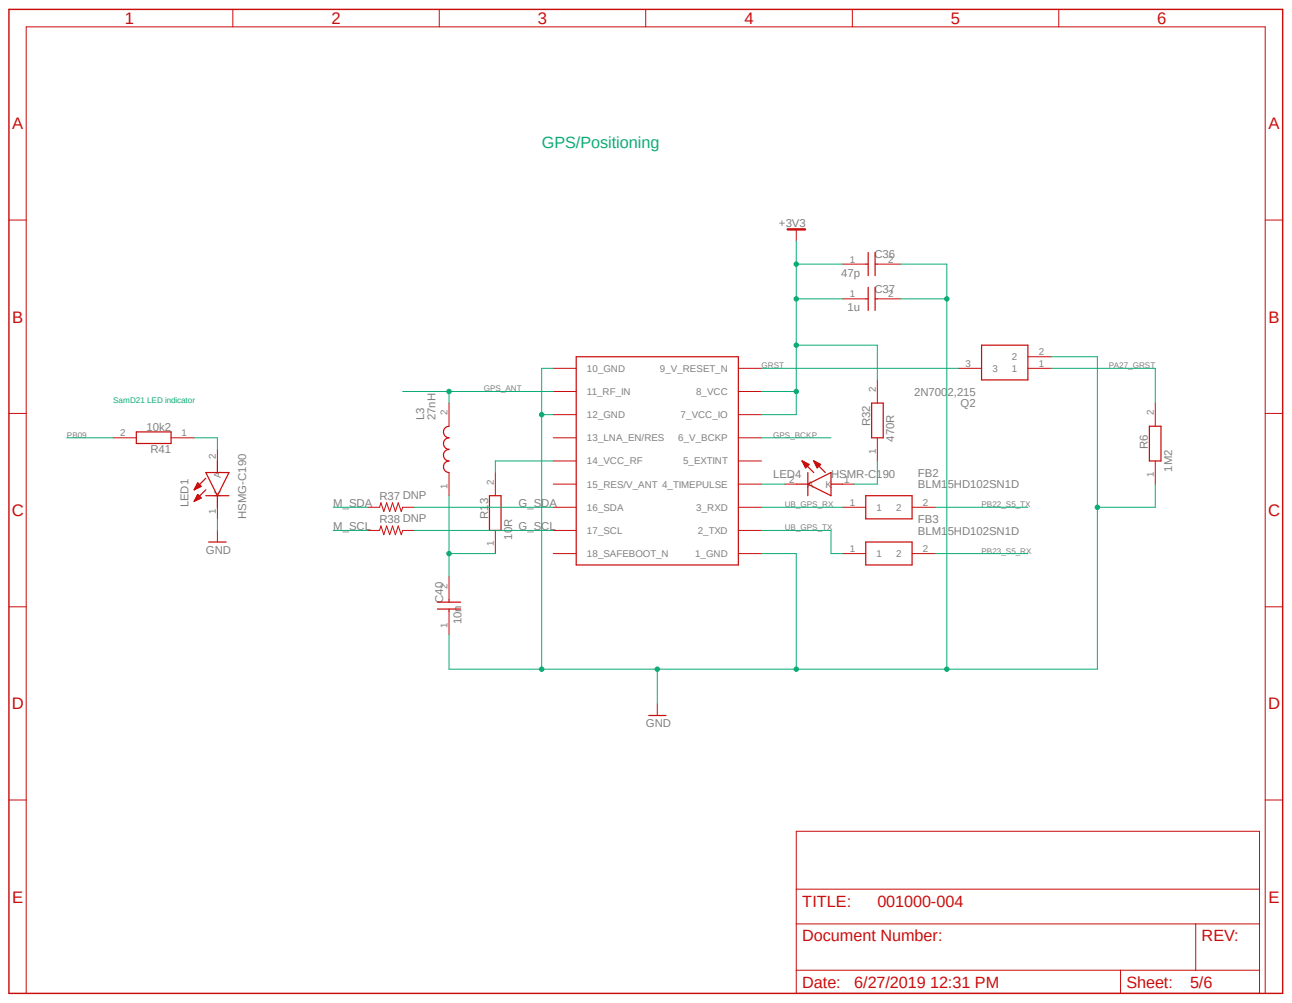
[picture p15: page 5]
GND; BLM15HD102SN1D; HSMR-C190⁴⁷⁰R 10R 10n 27nH; DNP HSMG⁻C¹⁹⁰; DNP; 10_GND; 12_GND; 13_LNA_EN/RES; 14_VCC_RF; 15_RES/V_ANT; 16_SDA; 17_SCL; 18_SAFEBOOT_N; 9_V_RESET_N; 8_VCC; 7_VCC_IO; 6_V_BCKP; 5_EXTINT; 4_TIMEPULSE; 3_RXD; 2_TXD; 1_GND; LED4; 1 2 R³² 1 2 R¹³ 1 2 C⁴⁰ ¹ ²L3; 2 LED1; UB_GPS_RX UB_GPS_TX; PB23_S5_RX GPS_BCKP GPS_ANT; GRST; PA27_GRST G_SDA; G_SCL; M_SDA; M_SCL PB09; TITLE:

GPS/Positioning SamD21 LED indicator

Document Number: | REV:

MOUNT-HOLE3.0 | GCM¹⁵⁵⁵C¹H¹⁰¹JA¹⁶D
H1 | H4 | H5 | H6 1 2 C⁵¹

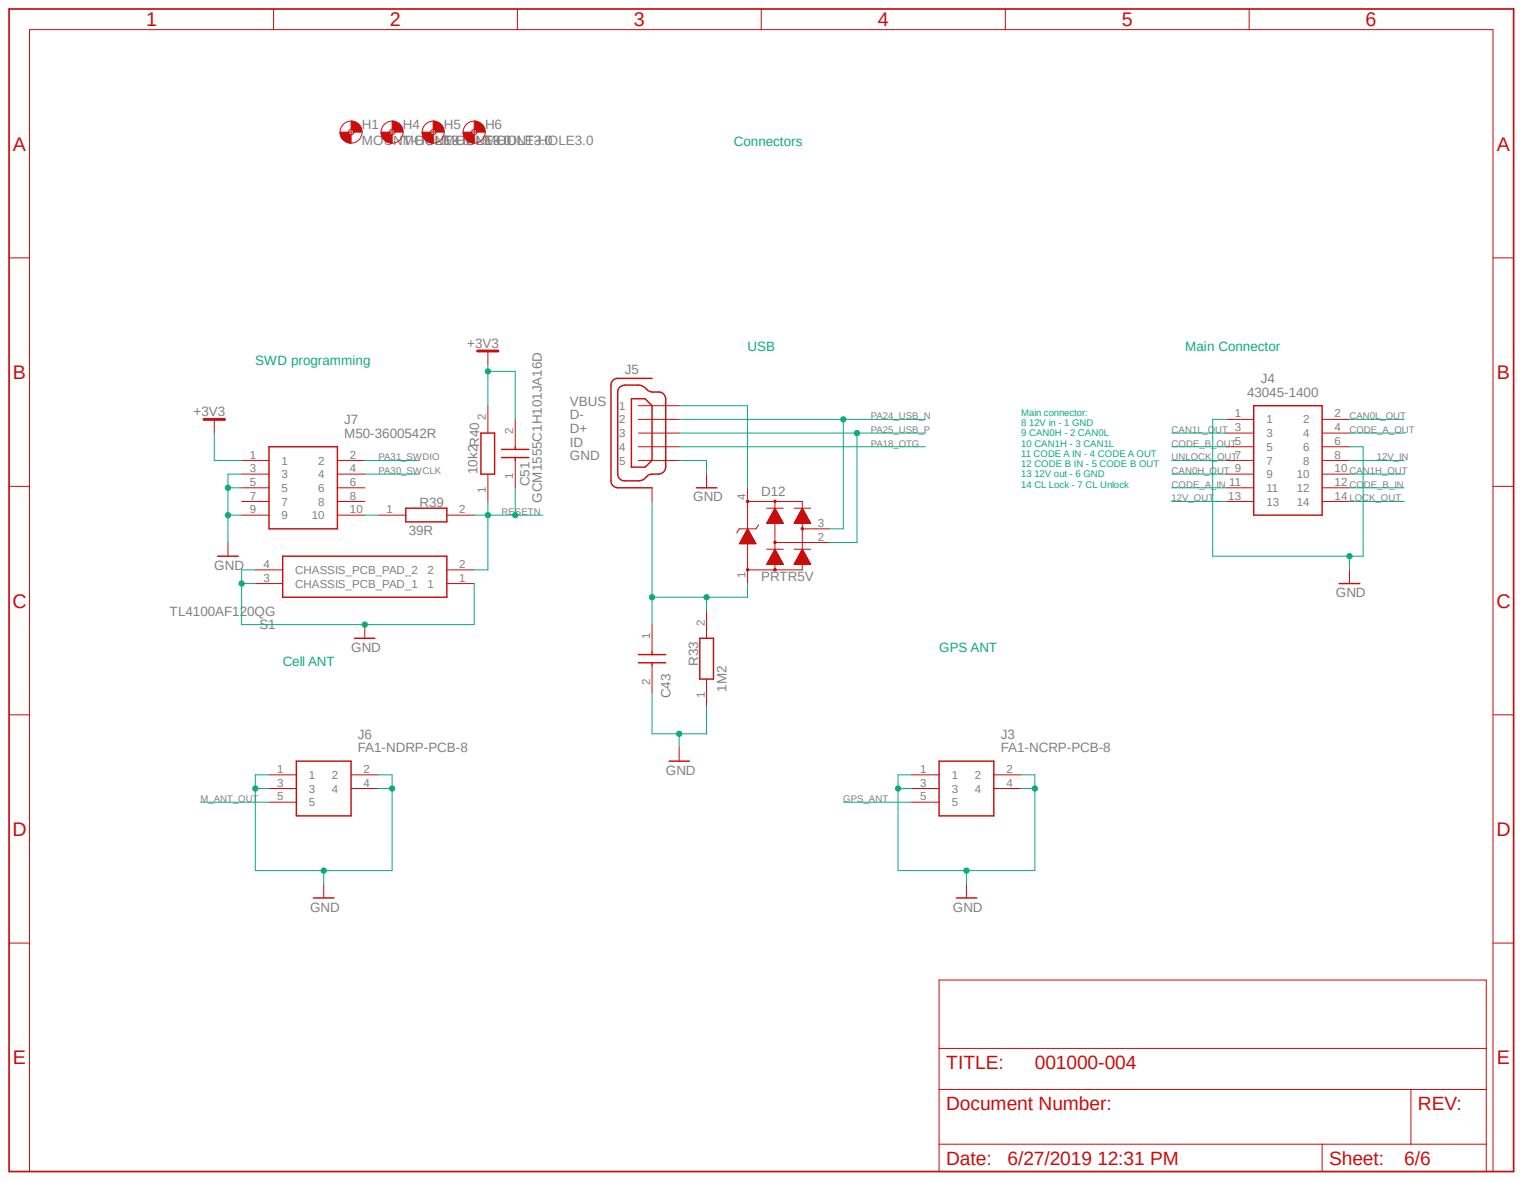
[picture p16: page 6]

9 CAN0H - 2 CAN0L
10 CAN1H - 3 CAN1L
11 CODE A IN - 4 CODE A OUT
12 CODE B IN - 5 CODE B OUT
13 12V out - 6 GND
14 CL Lock - 7 CL Unlock

Document Number: | REV:
