WaiveCar/WaiveTelem/Hardware/001000-001-5.17.pdf

20p | ABS⁰⁷⁻³².768KHZ⁻1⁻T
+3V8 0R | 330R HSMS⁻C¹⁹⁰

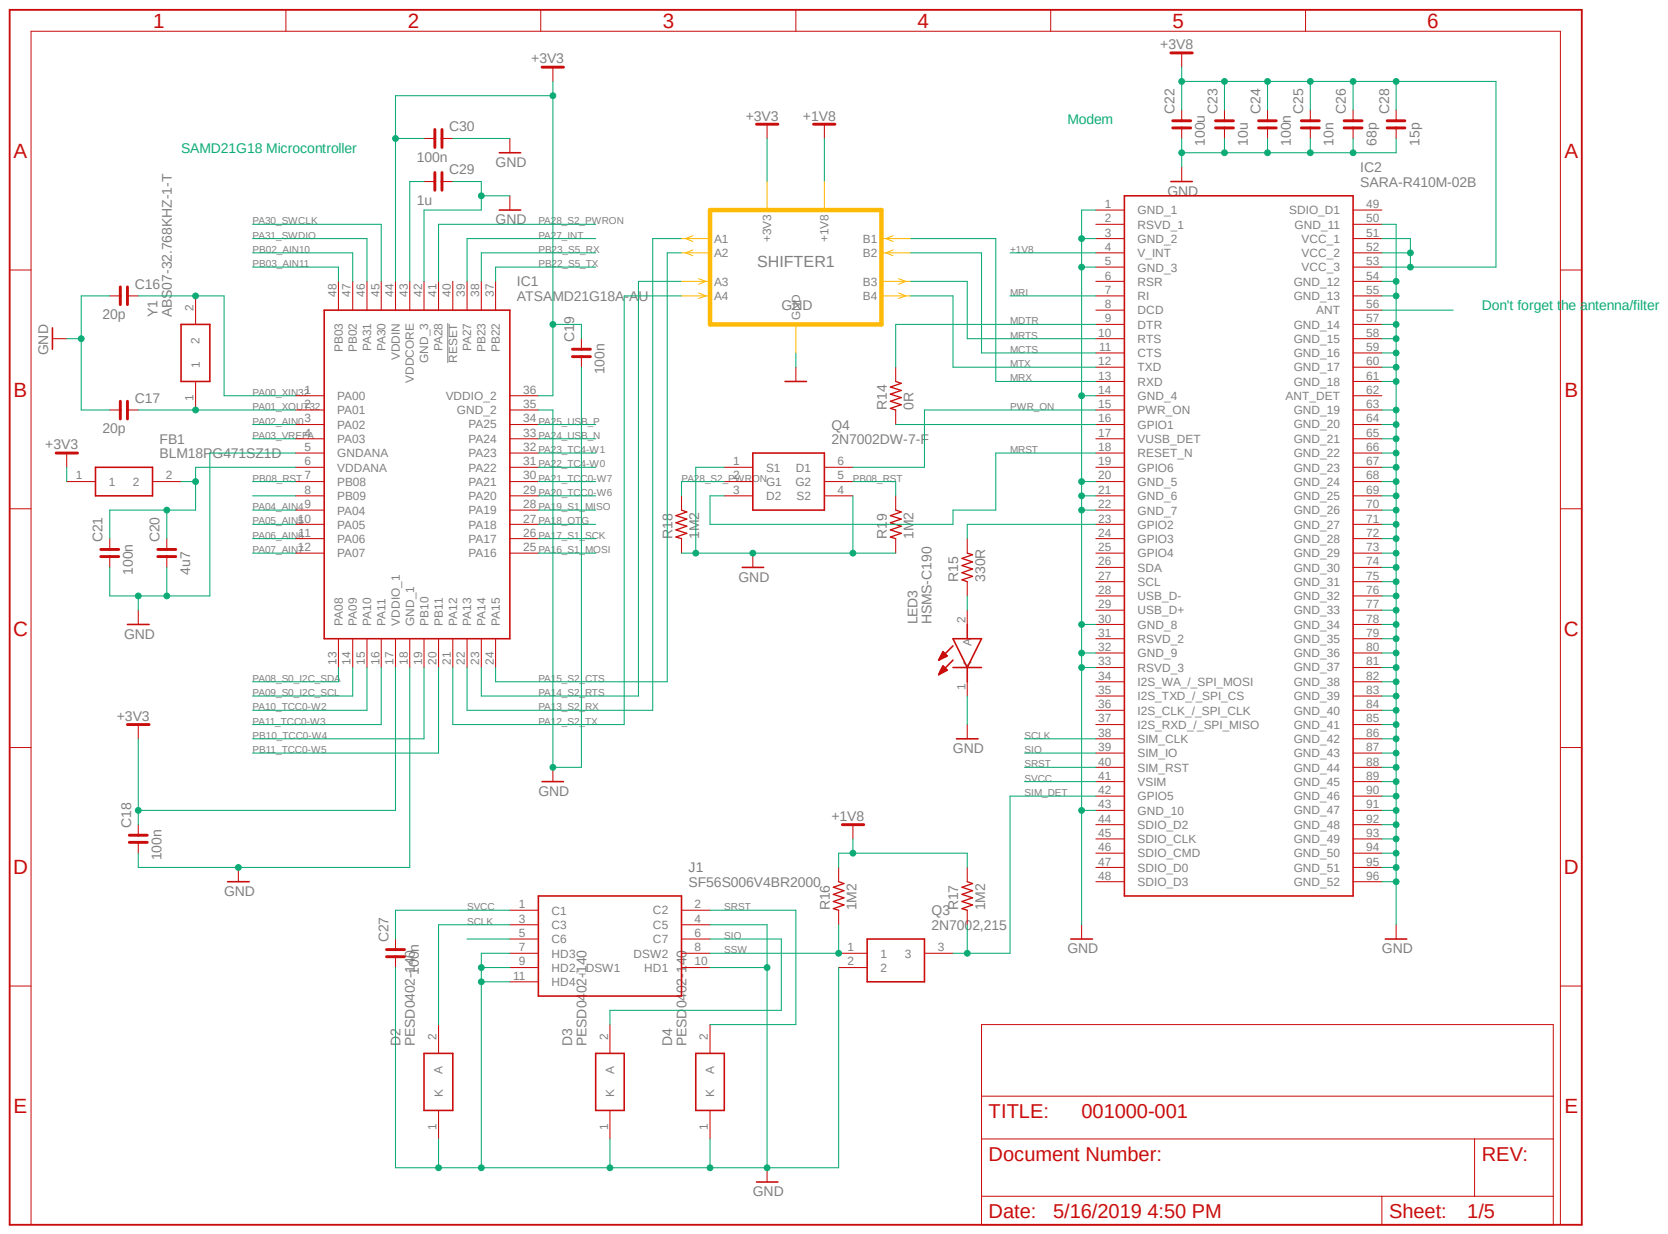
[picture p17: page 1]

+1V8 MRX MCTS MRTS MTX

Don't forget the antenna/filter

Document Number: | REV:

Date: 5/16/2019 4:50 PM | Sheet: 1/5

# VIN 1M²

A

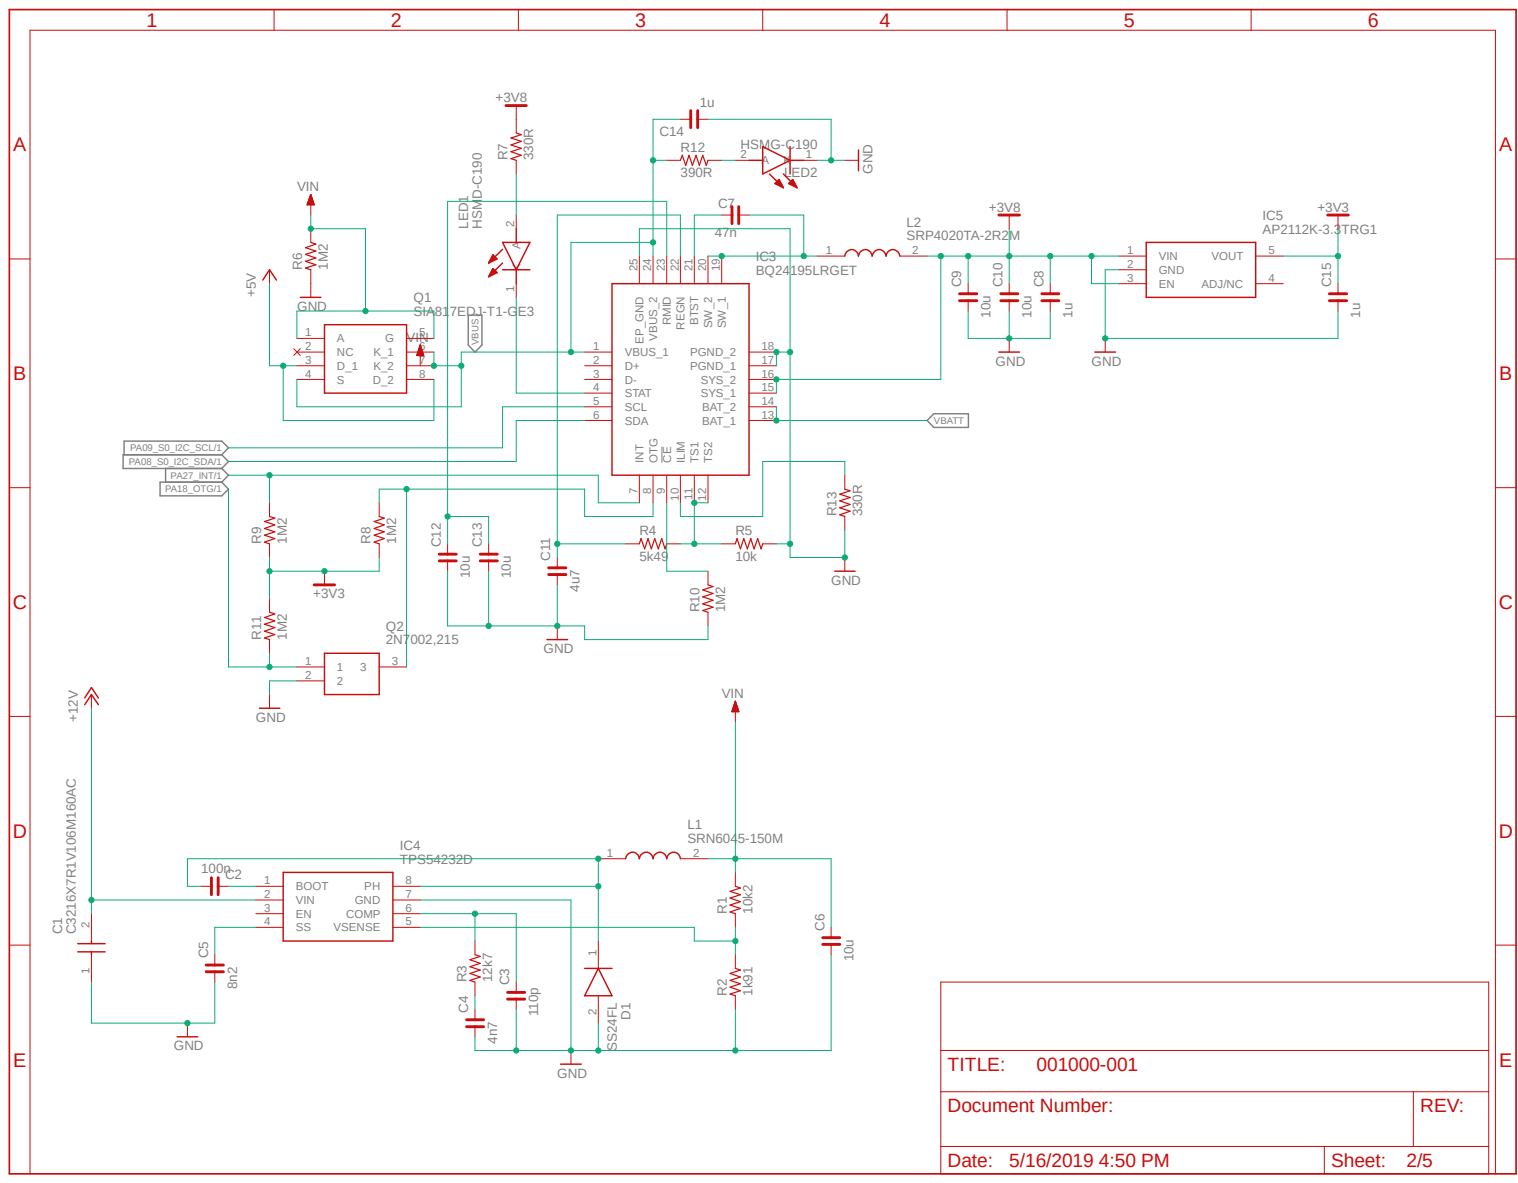
[picture p18: page 2]

Document Number: | REV:

+3V3 100n

# IC6 C³¹

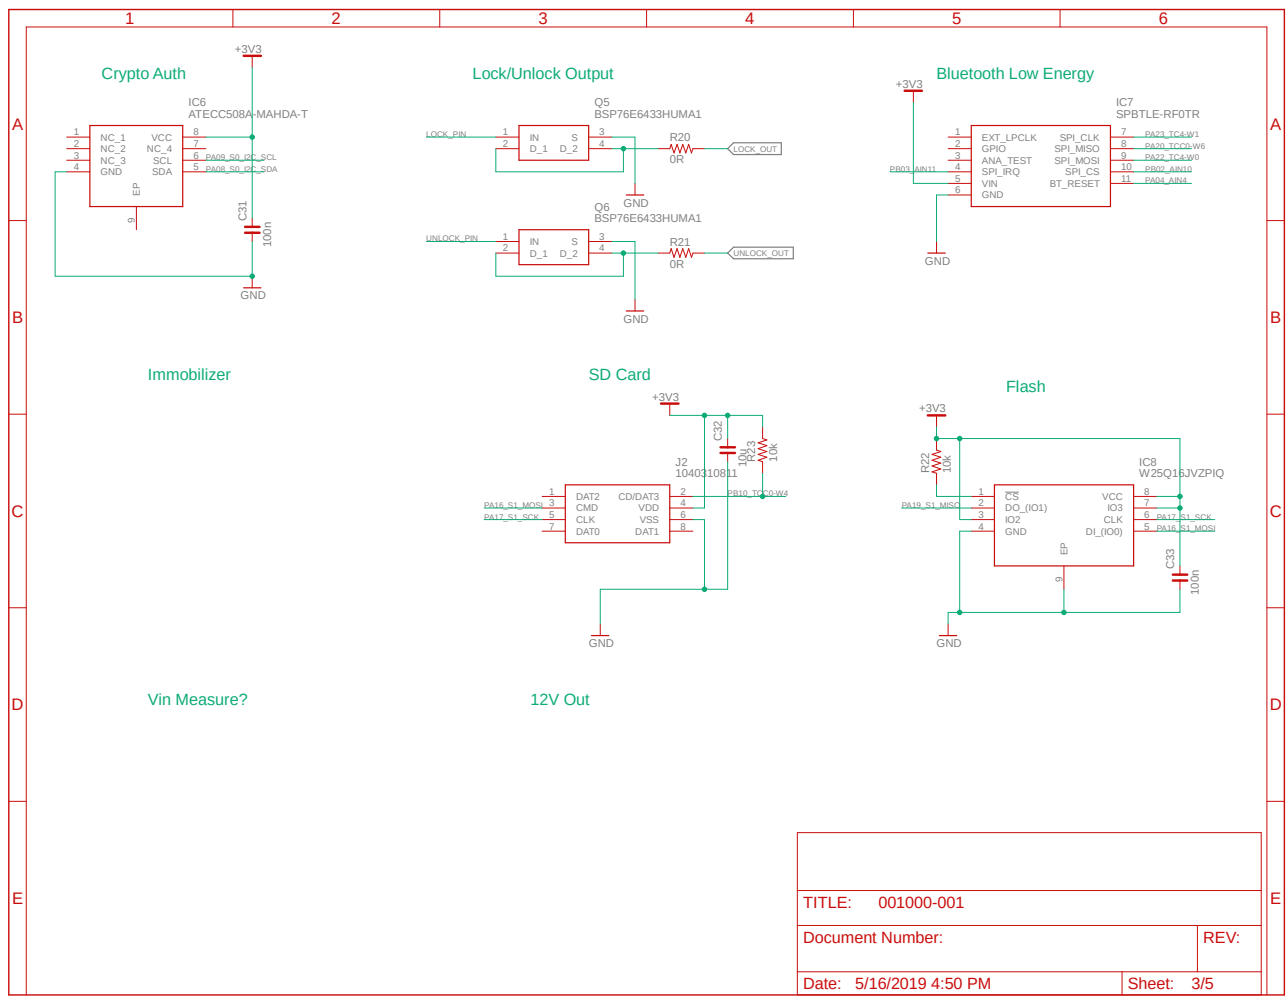
[picture p19: page 3]
ATECC508A-MAHDA-T; GND; BSP76E6433HUMA1; SPBTLE-RF0TR; W25Q16JVZPIQ; GND 4; EXT_LPCLK 1; GPIO 2; ANA_TEST 3; SPI_IRQ 4; VIN 5; GND 6; SPI_CLK; 7 SPI_MISO; 8 SPI_MOSI; 9 SPI_CS; 10 BT_RESET; DAT2 1; CMD 3; CLK 5; DAT0 7; CD/DAT3; 2 VDD; 4 VSS; 6 DAT1; 9 VCC 8; 7 CLK; IC8 C³²; R²²R²³; C³³; PA09_S0_I2C_SCL PA08_S0_I2C_SDA; LOCK_PIN; UNLOCK_PIN; LOCK_OUT UNLOCK_OUT; PB03_AIN11; PB02_AIN10 PA22_TC4-W0 PA20_TCC0-W6 PA23_TC4-W1 PA04_AIN4; PB10_TCC0-W4 PA16_S1_MOSI; PA16_S1_MOSI PA17_S1_SCK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

9 VCC 8 NC_4 7 SCL 6 SDA 5

A

A

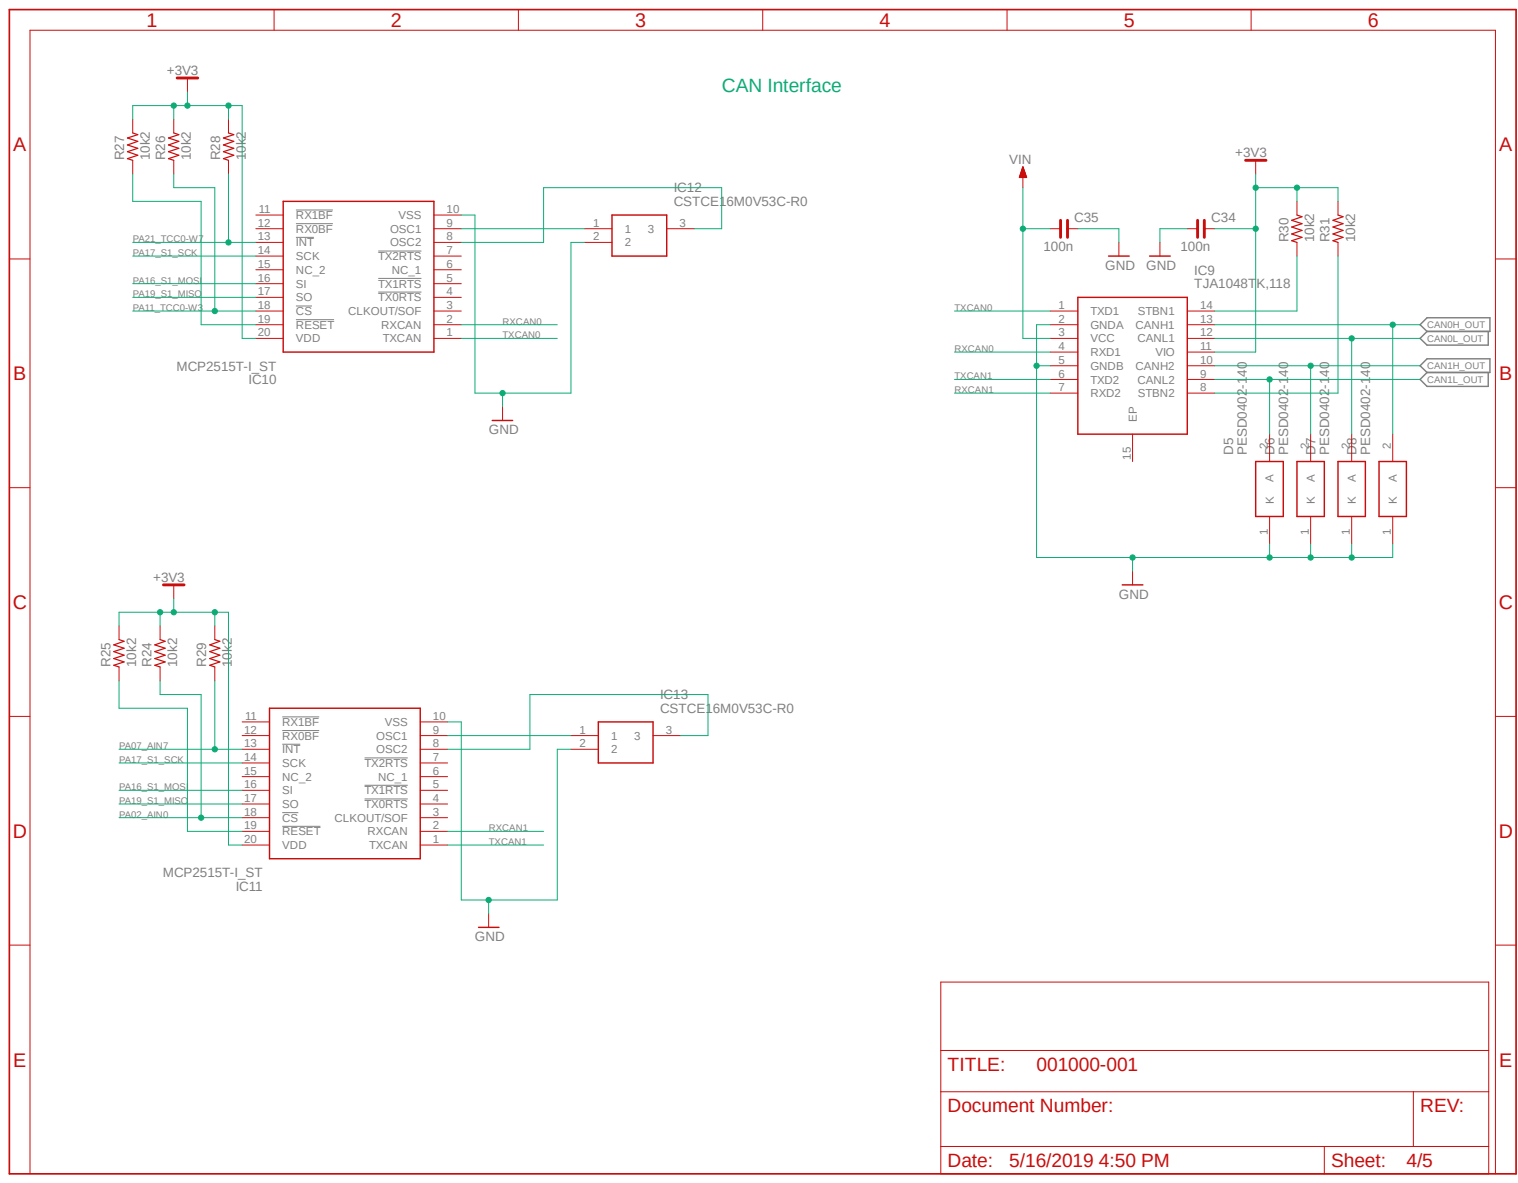
[picture p20: page 4]
TJA1048TK,118; MCP2515T-I_ST; CSTCE16M0V53C-R0; GND; PESD⁰⁴⁰²⁻¹⁴⁰; VIN; GND GND; TXD1 1; GNDA 2; VCC 3; RXD1 4; GNDB 5; TXD2 6; RXD2 7; EP 15 STBN1; 14 CANH1; 13 CANL1; 12 VIO; 11 CANH2; 10 CANL2; 9 STBN2; TXCAN; 1 RXCAN; 2 CLKOUT/SOF; 3 TX0RTS; 4 TX1RTS; 6 TX2RTS; 7 OSC2; 8 OSC1; 9 VSS; 10 VDD 20; RESET 19; SCK 14; INT 13; IC13 R²⁵; R²⁴; IC12 R²⁷; R²⁶; R²⁸ R²⁹; R³⁰; R³¹; TXCAN1; RXCAN1; PA02_AIN0; TXCAN0; TXCAN0 RXCAN0; RXCAN0 PA11_TCC0-W3 PA19_S1_MISO; PA19_S1_MISO; PA16_S1_MOSI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

A

A

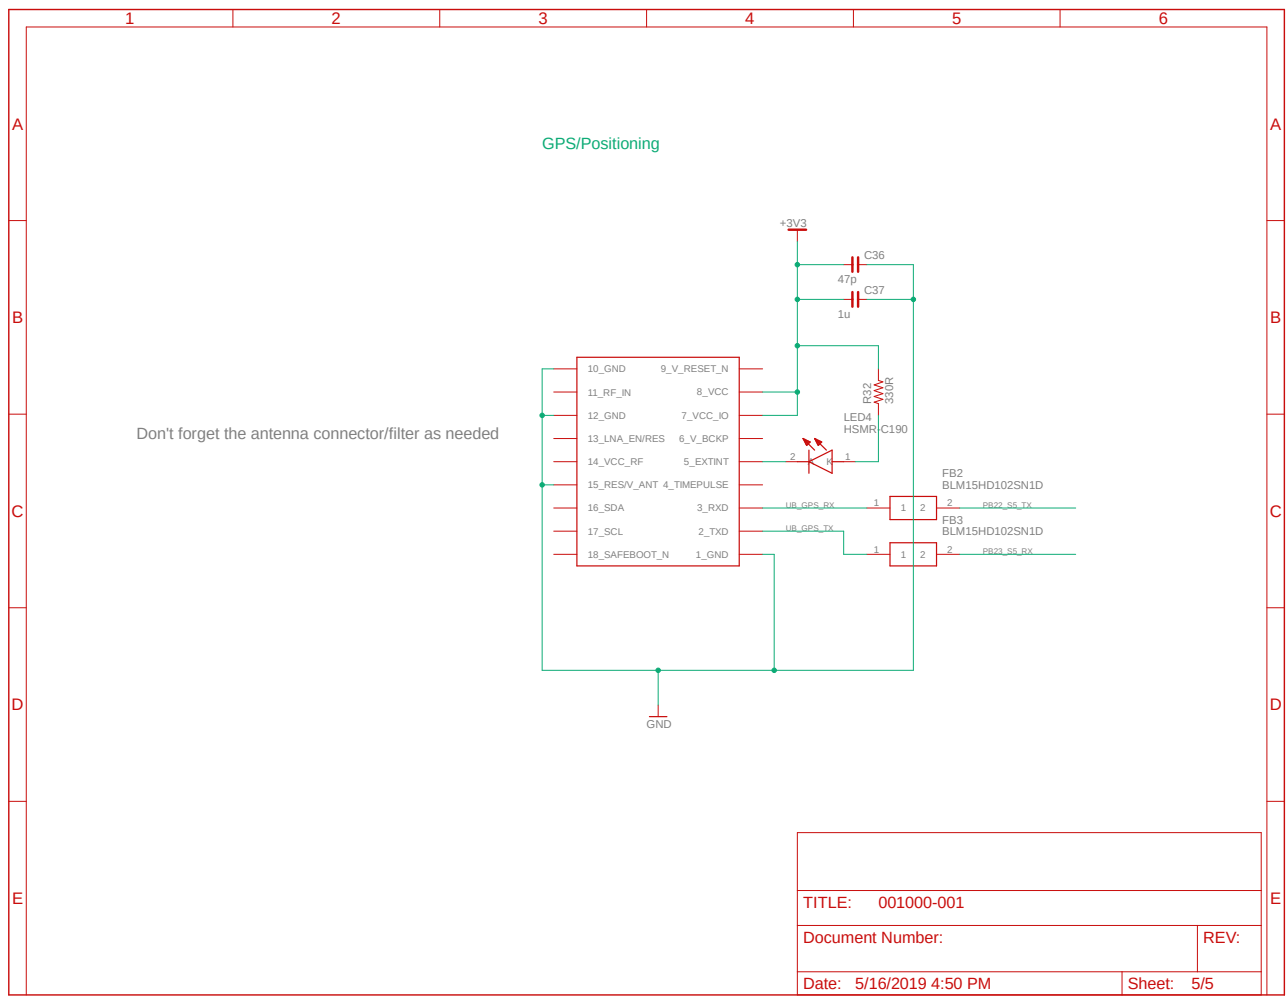
[picture p21: page 5]
GND; BLM15HD102SN1D; HSMR-C190 ³³⁰R; 10_GND; 12_GND; 13_LNA_EN/RES; 14_VCC_RF; 15_RES/V_ANT; 16_SDA; 17_SCL; 18_SAFEBOOT_N; 9_V_RESET_N; 8_VCC; 7_VCC_IO; 6_V_BCKP; 5_EXTINT; 4_TIMEPULSE; 3_RXD; 2_TXD; 1_GND; LED4R³² UB_GPS_RX UB_GPS_TX; TITLE:; GPS/Positioning

Don't forget the antenna connector/filter as needed

A

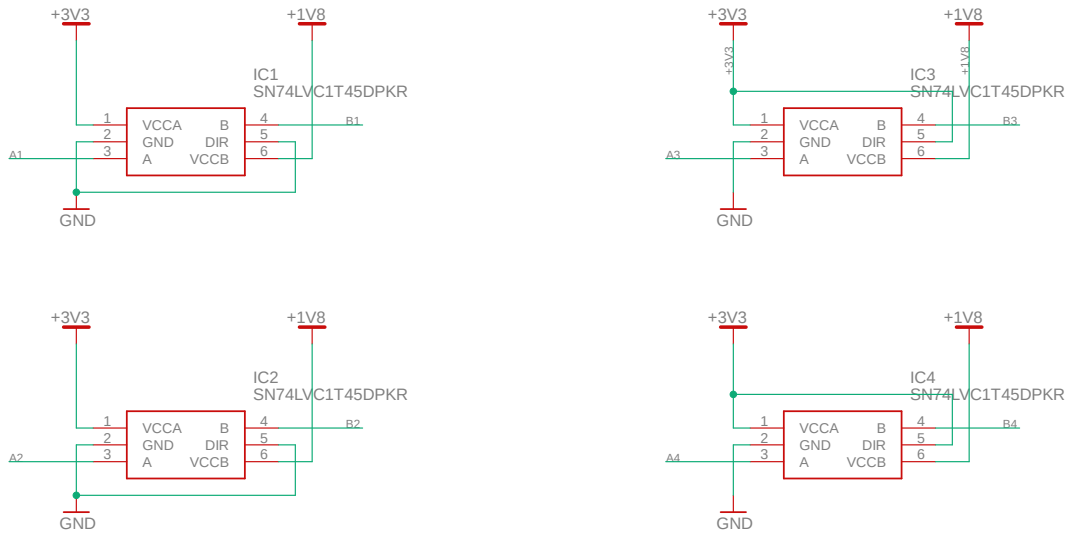
[picture p22: page 6]
SN74LVC1T45DPKR; GND; VCCA 1; GND 2; 4 DIR; 5 VCCB; IC1 VCCA 1; IC3 VCCA 1; IC4 ⁺³V³; TITLE:
