WaiveCar/WaiveTelem/Hardware/mkrnb1500.pdf

A

A

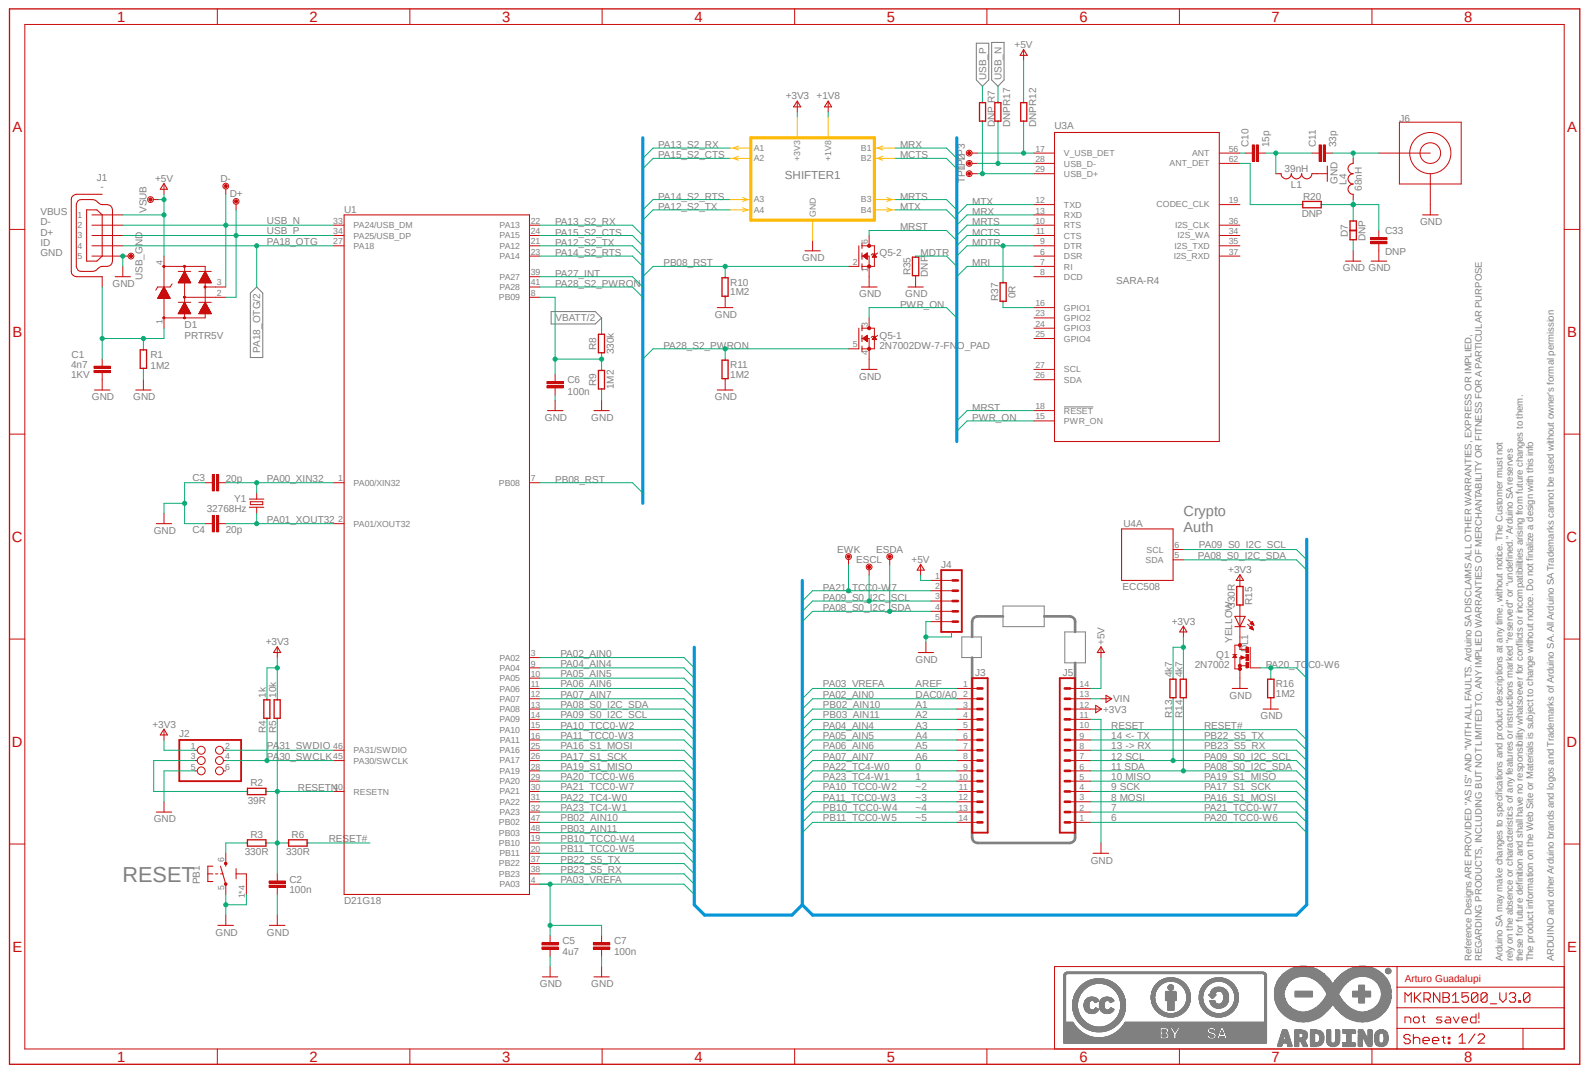
[picture p30: page 1]

Reference Designs ARE PROVIDED "AS IS" AND "WITH ALL FAULTS. Arduino SA DISCLAIMS ALL OTHER WARRANTIES, EXPRESS OR IMPLIED, REGARDING PRODUCTS, INCLUDING BUT NOT LIMITED TO, ANY IMPLIED WARRANTIES OF MERCHANTABILITY OR FITNESS FOR A PARTICULAR PURPOSE Arduino SA may make changes to specifications and product descriptions at any time, without notice. The Customer must not rely on the absence or characteristics of any features or instructions marked "reserved" or "undefined." Arduino SA reserves these for future definition and shall have no responsibility whatsoever for conflicts or incompatibilities arising from future changes to them. The product information on the Web Site or Materials is subject to change without notice. Do not finalize a design with this info ARDUINO and other Arduino brands and logos and Trademarks of Arduino SA. All Arduino SA Trademarks cannot be used without owner's formal permission D21G18ECC508

100n GND | GND GND GND
+3V3 +3V3 | GND

100n

1u

100n

100n

100n | 4u7 GND
+3V3 | BLM18PG471 +3V3 GREEN 390R ORANGE 330R

VIN

1M2 GND | GND
SIA817 SIA⁸¹⁷ | GND DNP | GND
SARA-R4 | GND GND 100n GND

15p GND

100n GND

100uF GND

# +1V8GND¹M² GND ¹M²

BQ24195L GND | GND ¹u GND | 47n

330R GND

10u | 10u GND GND ⁴u7 GND
10u | 10u GND | GND

1M2

2u2 1M² 1M² +3V3 GND

+5V

10k GND | 5k49 GND | GND
+3V3
1u | 1u GND | GND

+3V3

2N7002 GND ¹M²

10n GND

3V8

3V8 +3V3 DNP | 3V⁸ +3V3 | +1V8 GND | PESD0402 GNDGND

68p GND

+1V8

2N7002

10u GND

AP2112K-3.3

EP 49 GND 18 GND 35 | GND 42 GNDANA 5 VDDANA 6 VDDCORE 43 VDDIN 44 VDDIO 17 VDDIO 36U1B
EP 9 GND 4 | NC 1 NC 2 NC 3 NC 7 VCC 8U4B
C18 | C23 C25 C24 C21 C17 | C27
L3 DL3 R²⁷ DL2 R²³ R19D*2 | G S Q2A Q²B

1

2 D² | J7 BATT- BATT+ | GND | 1 GND | 84 GND | 83 GND | 82 GND | 80 GND | 81 GND | 54 GND | 55 GND | 57 GND | 91 GND | 79 GND | 67 GND | 66 GND | 64 GND | 65 GND | 63 GND | 61 GND | 60 GND | 59 GND | 58 GND | 90 GND | 89 GND | 88 GND | 87 GND | 86 GND | 85
GND | 3 GND | 14 GND | 5 GND | 20 GND | 21 GND | 22 GND | 30 GND | 32 GND | 43 GND | 50 GND | 68 GND | 69 GND | 70 GND | 71 GND | 72 GND | 73 GND | 74 GND | 75 GND | 76 GND | 77 GND | 78 GND | 92 GND | 93 GND | 94 GND | 95 GND | 96 RSVD 49 | RSVD 31 | RSVD 33 | RSVD 44 | RSVD 45 | RSVD 46 | RSVD 47 | RSVD 48 | SIM_CLK 38 | SIM_DET 42 | SIM_IO 39 | SIM_RST 40 | VCC 53 | VCC 52 | VCC 51 | VSIM 41 | V_BCKP 2 | V_INT 4 U3B
I/O | IO VPP | VPP GND | GND*6 CLK | CLK RST | RST VCC | VCC SW | SW
C32C31 | C29 | C30 R³² R³¹
VBUS 1*2 | PMID 23 | OTG 8 | D+ 2 | D- 3 | STAT 4 | SDA 6 | SCL 5
INT 7 | CE 9 | SW | 19*2 BTST | 21 REGN | 22 TS2 | 12 TS1 | 11
ILIM | 10 BAT | 13*2 SYS | 15*2 PGND | 17*2 TH 25 U5 C¹⁴ | C¹⁵ R28 | C19 C20 C¹⁶
C12 | C13 | R26
L2 R²⁴ | R²⁵ | R29 | R³⁰ | C22 | C26 Q3 R²¹
C28 D³
D4 D5 D6 | C37 Q4 C34

2

IN 1 | OUT 5 EN 3 | U7 VBATT/1 | SVCC | SVCC
SRST | SRST SRST SCLK | SCLK

SCLK

SSW

SIO

SIO

SIO | V_BCKP
PA27_INT/1 | PA09_S0_I2C_SCL/1 PA08_S0_I2C_SDA/1 | PA18_OTG/1

Arturo Guadalupi

A

B

C

D

E

1 | 2 | 3 | 4 | 5 | 6 | 7 | 8

A

B

C

D

E

1 | 2 | 3 | 4 | 5 | 6 | 7 | 8

1 | 2 | 3 | 4 | 5 | 6

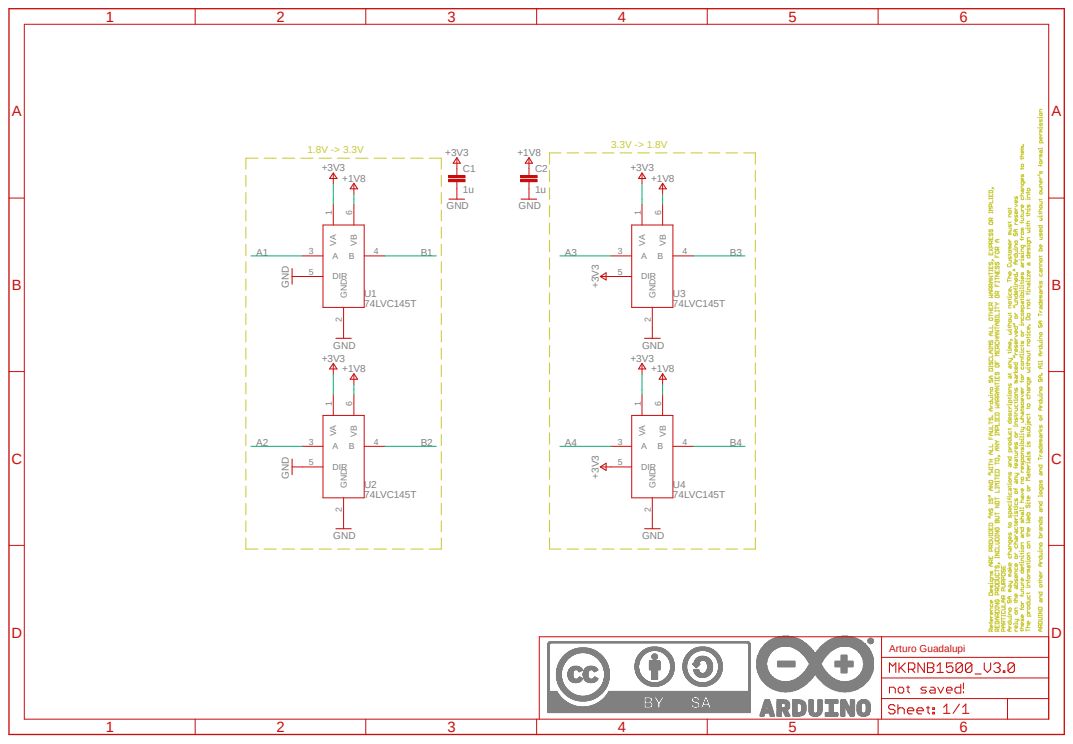
[picture p31: page 3]
74LVC145T GND; +3V3+1V8 GND; +3V3+1V8 ⁺³V³ +3V³; +1V8 GND; GND; 4 DIR 5; Arturo Guadalupi
