WaiveCar/WaiveTelem/Hardware/DimensionedBot.pdf

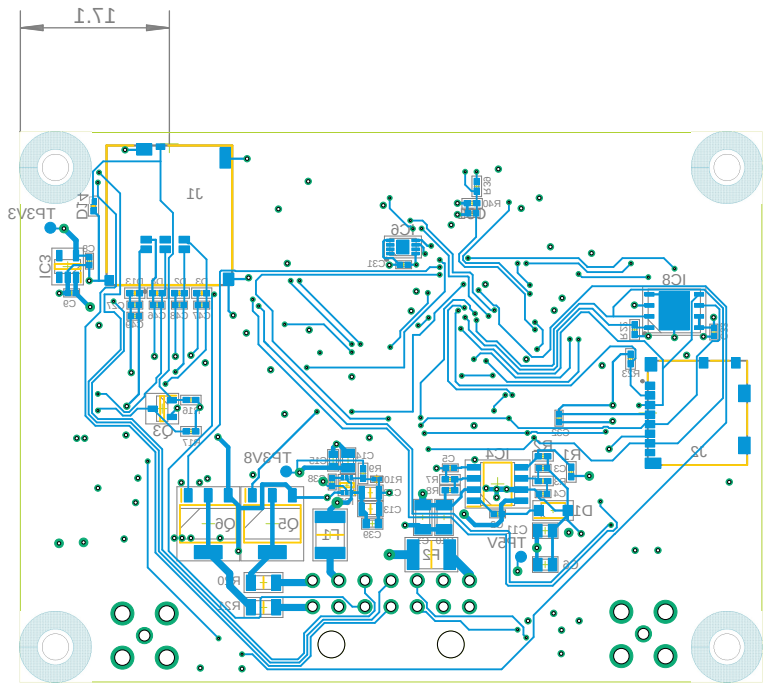
[picture p32: page 1]
