WaiveCar/WaiveTelem/Hardware/DimensionedTop.pdf

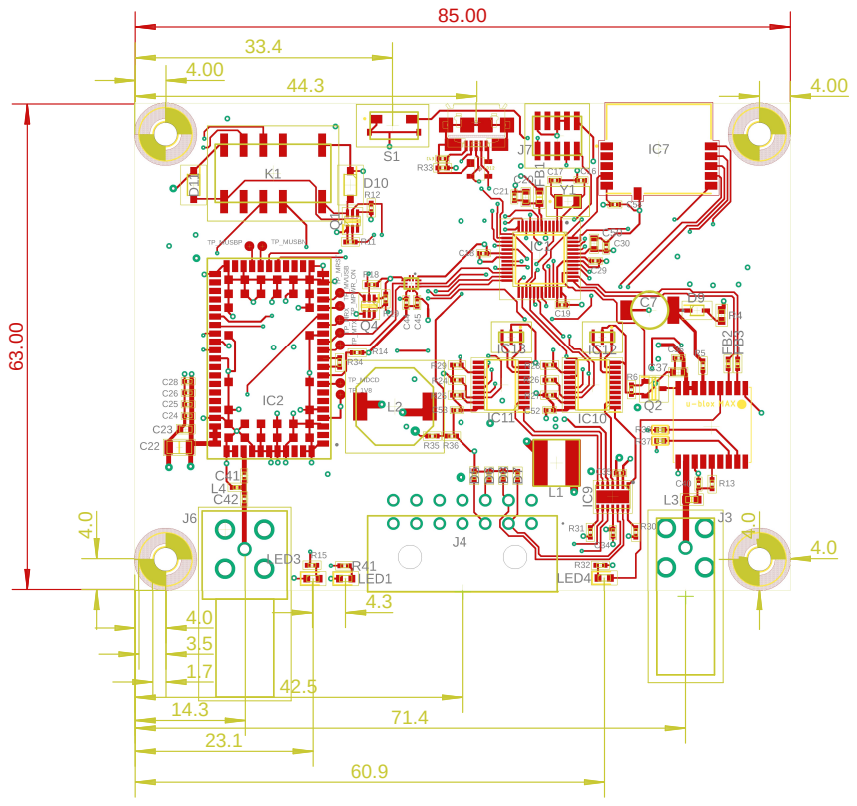
[picture p33: page 1]

3.5
1.7
14.3 | 71.4
