WaiveCar/WaiveTelem/Hardware/001000-005.brd

## EAGLE design Hardware/001000-005.brd (continued)

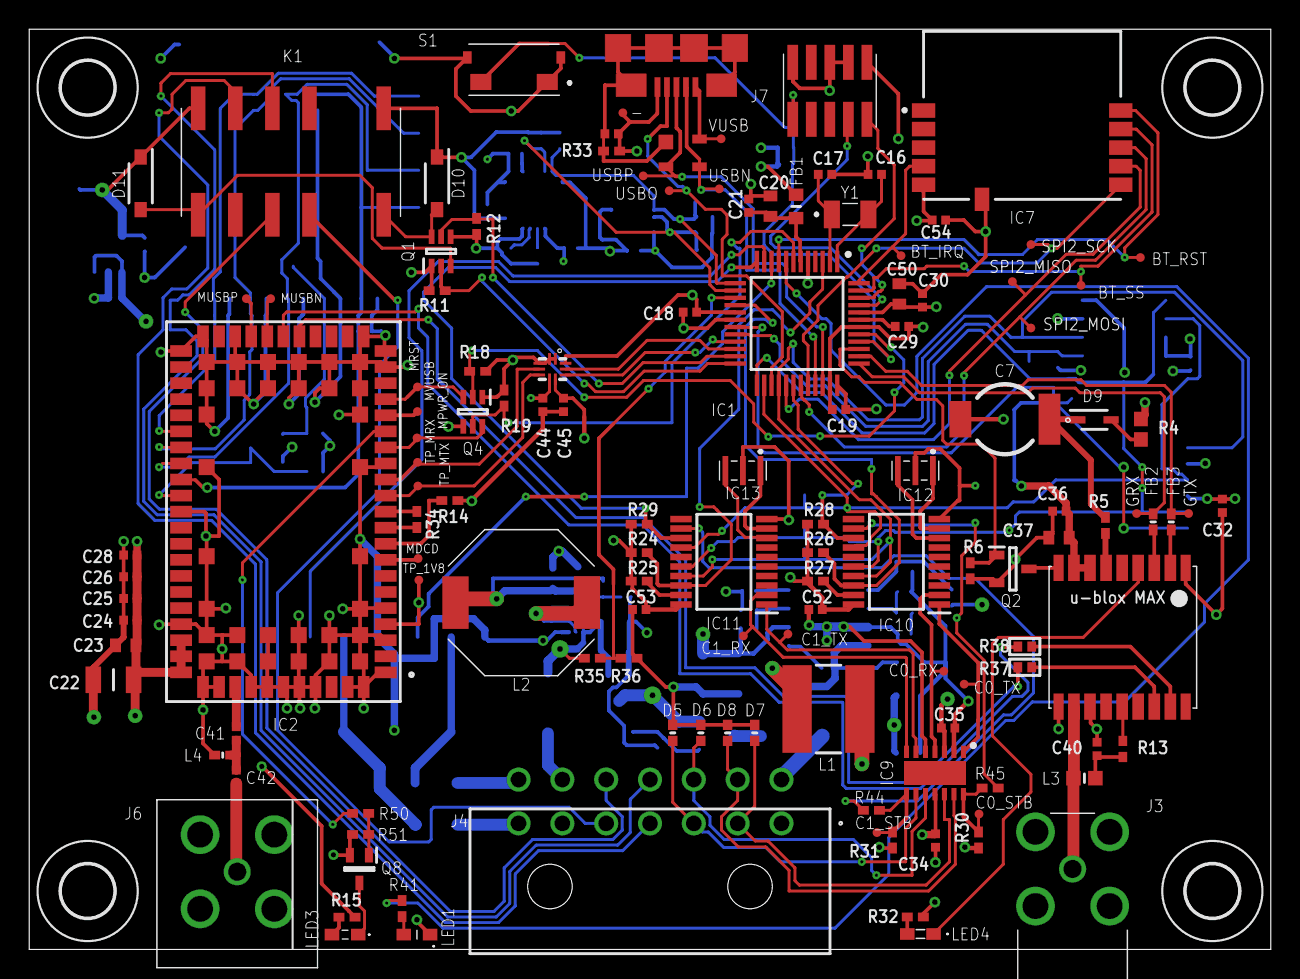
[picture p40: board 001000-005.brd from above]

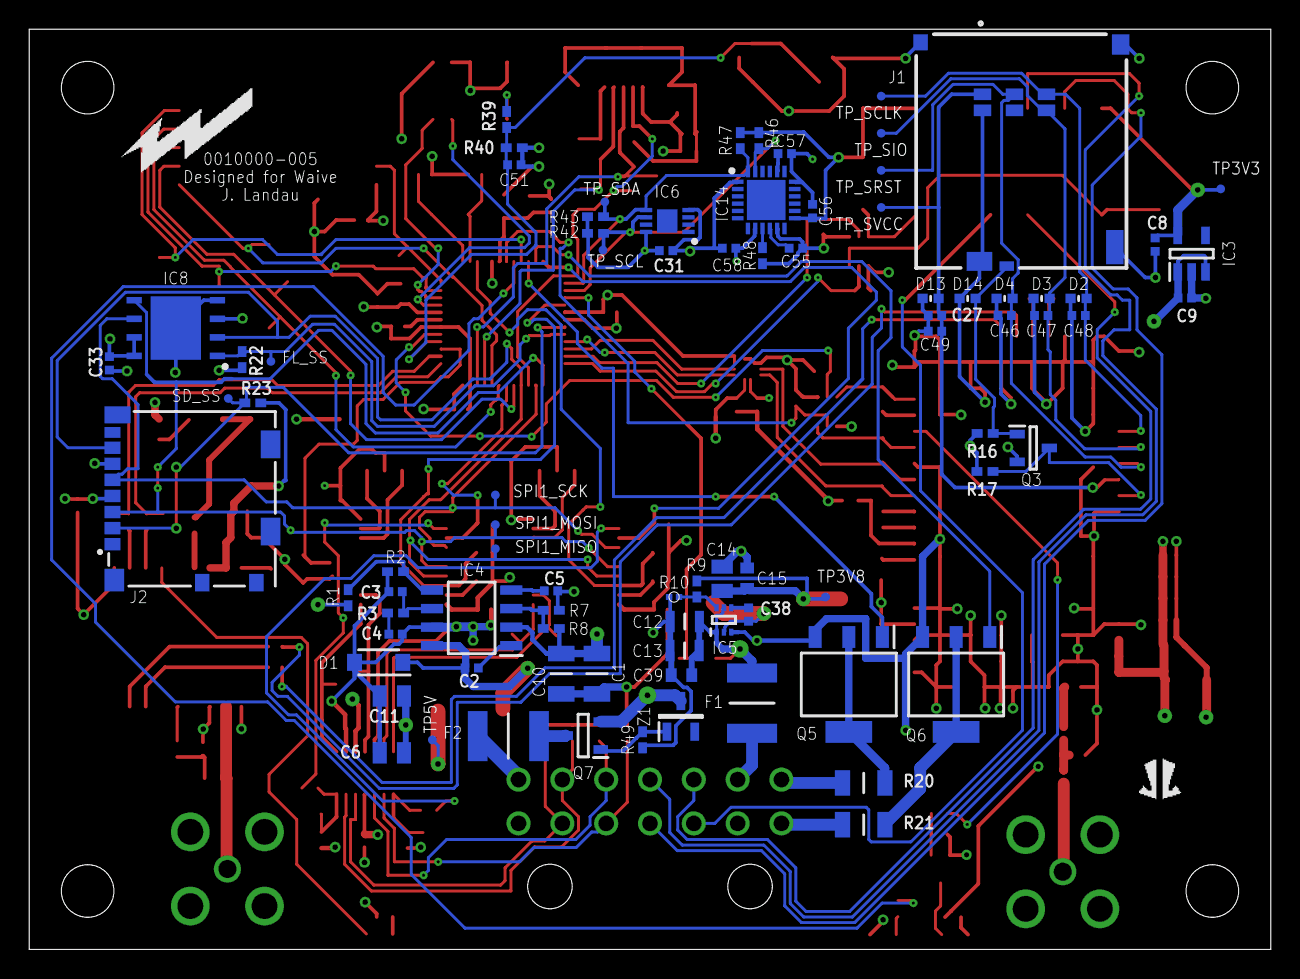
[picture p41: board 001000-005.brd from below]

Board: 4 copper layers, 85.0 x 63.0 mm, 216 parts (84 on the bottom side), 134 nets.
