WaiveCar/WaiveTelem/packages/plug-firmware/src/Pins.cpp

#include <Arduino.h>
#include <SPI.h>
#include <wiring_private.h>

#include "Pins.h"

int PinsClass::begin() {
#ifdef ARDUINO_SAMD_WAIVE1000
  analogReference(AR_DEFAULT);
  analogReadResolution(ANALOG_RESOLUTION);

  // pinMode(VIN_SENSE, INPUT);
  pinMode(IMMO_ON, OUTPUT);
  pinMode(IMMO_OFF, OUTPUT);
  pinMode(GPS_RESET, OUTPUT);

  pinMode(CAN1_CS_PIN, OUTPUT);
  pinMode(CAN1_INT_PIN, INPUT);

  digitalWrite(GPS_RESET, LOW);
  digitalWrite(CAN1_CS_PIN, HIGH);
#else
  pinMode(RELAY_2_PIN, OUTPUT);
#endif

  pinMode(LED_BUILTIN, OUTPUT);
  pinMode(CAN0_CS_PIN, OUTPUT);
  pinMode(CAN0_INT_PIN, INPUT);
  pinMode(SD_CS_PIN, OUTPUT);
  pinMode(FL_CS_PIN, OUTPUT);
  pinMode(DOOR_UNLOCK_PIN, OUTPUT);
  pinMode(DOOR_LOCK_PIN, OUTPUT);
  pinMode(BLE_CS_PIN, OUTPUT);
  pinMode(BLE_INT_PIN, INPUT);
  pinMode(BLE_RST_PIN, OUTPUT);
  pinPeripheral(BLE_MOSI_PIN, PIO_SERCOM);      //mosi
  pinPeripheral(BLE_SCK_PIN, PIO_SERCOM);       //sck
  pinPeripheral(BLE_MISO_PIN, PIO_SERCOM_ALT);  //miso

  //Ensure SPI CS Pins are all high to avoid a noisy bus at inits
  digitalWrite(CAN0_CS_PIN, HIGH);
  digitalWrite(SD_CS_PIN, HIGH);
  digitalWrite(FL_CS_PIN, HIGH);
  digitalWrite(BLE_CS_PIN, HIGH);
  digitalWrite(BLE_RST_PIN, HIGH);

  digitalWrite(DOOR_UNLOCK_PIN, HIGH);
  digitalWrite(DOOR_LOCK_PIN, HIGH);

  SPI.begin();

  return 1;
}

void PinsClass::unlockDoors() {
  digitalWrite(DOOR_UNLOCK_PIN, LOW);
  delay(100);
  digitalWrite(DOOR_UNLOCK_PIN, HIGH);
}

void PinsClass::lockDoors() {
  digitalWrite(DOOR_LOCK_PIN, LOW);
  delay(100);
  digitalWrite(DOOR_LOCK_PIN, HIGH);
}

void PinsClass::immobilize() {
#ifdef ARDUINO_SAMD_WAIVE1000
  digitalWrite(IMMO_ON, HIGH);
  delay(100);
  digitalWrite(IMMO_ON, LOW);
#else
  digitalWrite(RELAY_2_PIN, LOW);
#endif
}

void PinsClass::unimmobilize() {
#ifdef ARDUINO_SAMD_WAIVE1000
  digitalWrite(IMMO_OFF, HIGH);
  delay(100);
  digitalWrite(IMMO_OFF, LOW);
#else
  digitalWrite(RELAY_2_PIN, HIGH);
#endif
}

PinsClass Pins;
