WaiveCar/WaiveTelem/packages/plug-firmware/src/Http.cpp

#include <Adafruit_SleepyDog.h>
#include <Arduino.h>
#include <ArduinoBearSSL.h>
#include <SD.h>

#include "Config.h"
#include "Http.h"
#include "Internet.h"
#include "Logger.h"
#include "Mqtt.h"
#include "System.h"

#define DOWNLOAD_TIMEOUT 60 * 1000

static InternetClient client;

static void sendGetRequest(const String& host, const String& file) {
  client.println("GET /" + file + " HTTP/1.0");
  client.println("Host: " + host);
  client.println("User-Agent: waiveplug/" + String(FIRMWARE_VERSION));
  client.println("Accept: application/octet-stream");
  client.println();
}

static int32_t skipHeaders() {
  unsigned long timeoutStart = millis();
  char prevPrevC = '\0';
  char prevC = '\0';
  char c = '\0';
  while ((client.connected() || client.available()) && ((millis() - timeoutStart) < DOWNLOAD_TIMEOUT)) {
    if (client.available()) {
      prevPrevC = prevC;
      prevC = c;
      c = client.read();
      log(String(c));
      if (prevPrevC == '\n' && prevC == '\r' && c == '\n') {
        return 0;
      }
    } else {
      delay(1);
    }
    Watchdog.reset();
  }
  return -1;
}

static int32_t saveFile(const char* to) {
  unsigned long timeoutStart = millis();
  int counter = 0;
  SHA256.beginHmac("https failed");
  File file = SD.open(to, FILE_WRITE);
  if (!file) {
    logError("file open failed");
    return -1;
  }
  file.seek(0);  // workaround BUG in SD to default to append
  uint8_t buf[BUFFER_SIZE];
  while ((client.connected() || client.available()) && ((millis() - timeoutStart) < DOWNLOAD_TIMEOUT)) {
    if (client.available()) {
      int bytesRead = client.read(buf, sizeof(buf));
      counter += bytesRead;
      SHA256.write(buf, bytesRead);
      file.write(buf, bytesRead);
    } else {
      delay(1);
    }
    Watchdog.reset();
  }
  logDebug("total bytes downloaded: " + String(counter));
  SHA256.endHmac();
  file.close();
  return 0;
}

static int32_t verifyFile(const String& file) {
  String computed = "";
  while (SHA256.available()) {
    byte b = SHA256.read();
    if (b < 16) {
      computed += "0";
    }
    computed += String(b, HEX);
  }
  String sha256 = file.substring(file.lastIndexOf("_") + 1);
  logDebug(sha256);
  logDebug(computed);
  if (sha256 == computed) {
    return 0;
  } else {
    logError("checksum failed");
    return -1;
  }
}

int32_t HttpClass::download(const char* host, const char* from, const char* to) {
  logDebug("host: " + String(host) + ", from: " + from + ", to: " + to);
  int32_t error;
  if (client.connectSSL(host, 443)) {
    sendGetRequest(host, from);
    error = skipHeaders();
    if (error) return error;
    error = saveFile("TEMP");
    if (error) return error;
    error = verifyFile(from);
    if (error) return error;
    return System.moveFile("TEMP", to);
  } else {
    logError(F("https failed"));
    return -10;
  }
}

HttpClass Http;
