WaiveCar/WaiveTelem/(commit log)

2019-06-26 adding hardware files including schematic and board layout
    [-002net.csv, -002net.xlsx, -002pin.csv, -002pin.xlsx, -003net6.10.csv, -003net6.17.csv, 001000-001.csv, 001000-001.sch]
2019-06-26 adding the arduino-based firmware
2019-06-28 adding arduino libaries and pcb -004. the 004 board adds a 2A incoming resettable fuse as well as renames the nets from the uC to understandable names
    [001000-004.brd, 001000-004.sch, 001000-004BOM1.627.csv, 001000-004BOM627.csv, 001000-004BOM627.xlsx, 001000-004BOM627formatted.xlsx]
2019-07-03 plug-firmware initial checkin
    [CONFIG.TXT]
2019-07-03 add MQTT
    [config.txt]
2019-07-03 fix mkrnb1500 compilation error
    [Cellular.cpp, Config.h, Main.cpp, Mqtt.cpp, Pins.h, Wifi.cpp]
2019-07-05 update README.me for windows installation
    [config.txt]
2019-07-05 update scripts to make them work on Windows
    [config.txt]
2019-07-05 update run.sh for different OSs
    [config.txt]
2019-07-05 verify provisioning works on Windows
    [config.txt]
2019-07-08 add CAN configuration
    [config.txt]
2019-07-08 add can.canbus configuration
    [config.txt]
2019-07-10 use different JSON parser
    [config.txt]
2019-07-11 go back to ArduinoJson
2019-07-11 checkin ArduinoBearSSL as library
2019-07-11 update ArduinoBearSSL to reduce memory usage
    [config.txt]
2019-07-14 S3 bucket firmware upgrade
2019-07-14 fix firmware OTA update
    [Http.cpp, Mqtt.cpp, Mqtt.h, System.cpp]
2019-07-16 update config
    [config.txt]
2019-07-16 implement sendCanStatus
    [config.txt]
2019-07-17 add copy, reboot commands
    [config.txt]
2019-07-17 clean up provision scripts
    [config.txt]
2019-07-18 change plug-1 to waive-1
    [CONFIG.TXT]
2019-07-20 trying to sleep, still need to fix GPS
    [Bluetooth.cpp, Logger.cpp, Logger.h, Main.cpp, Mqtt.cpp, System.cpp, System.h]
2019-07-23 fix heartbeat sent twice initial
    [Config.cpp, Main.cpp, Mqtt.cpp, System.cpp, System.h]
2019-07-23 schematic pdf
2019-07-23 list of all pin definitions, a specific breakdown for uC and a list of differences between mkr proto and boards
    [7-23pinlist.xlsx]
2019-07-24 check-in initial board and variant (copy mkrnb1500)
    [arduino_zero.cfg]
2019-07-31 get canbus working
    [CONFIG.TXT]
2019-07-31 added code pin numbers
    [7-23pinlist.xlsx]
2019-08-01 update provisioning code
    [CONFIG.TXT]
2019-08-01 chagne bsp directory
    [arduino_zero.cfg]
2019-08-07 get bluetooth token working
    [CONFIG.TXT]
2019-08-14 checking current bluetooth implementation
2019-08-15 optimize power saving
2019-08-17 check in ArduinoMqttClient as lib before modifying
2019-08-19 failure checkings
    [CONFIG.TXT]
2019-08-21 update RTCZero to sleep without reset
    [System.cpp]
2019-08-21 no real change
    [001000-004.brd]
2019-08-23 Top and Bottom
    [TOP4.SLDPRT, bottom4.SLDPRT]
2019-08-23 Files sent to DFM guys
    [TOP4.SLDPRT, bottom4.SLDPRT, case_bottom.SLDPRT, case_top.SLDPRT, case_top_logo3.SLDPRT]
2019-08-24 update canbus
2019-08-26 add can bus cmd to mobile app
2019-08-28 use unchanged ArduinoBearlSSL
2019-08-28 adjust mqtt watchdog settings
    [CONFIG.TXT]
2019-08-28 print MODEM firmware version
2019-08-29 update for Windows
    [CONFIG.TXT]
2019-08-29 case_bottom2 and case_top2_logo are 3D printed
    [case_bottom_2.SLDPRT, case_bottom_2.STL, case_top2.SLDPRT, case_top2_logo.SLDPRT, case_top2_logo.STL, waive_logo2.SLDPRT]
2019-08-29 provision 3 more waive1000
    [CONFIG.TXT]
2019-08-30 fix CAN BUS #2
    [Bluetooth.cpp, Can.cpp, Cellular.cpp, Command.cpp, Config.cpp, Gps.cpp, Https.cpp, Logger.cpp]
2019-08-30 separate can bus 0 and can bus 1 initialization
    [CONFIG.TXT]
2019-08-31 fix rm -rf ~/.platformio/packages/framework-arduinosam/variants/waive1000
2019-09-03 fix canbus commands
2019-09-04 reduce CANBUS buffer size
2019-09-04 adding debug code to troubleshoot multiple certs
    [CONFIG.TXT]
2019-09-04 fix inRide not working
    [Can.cpp, Command.cpp, Mqtt.cpp, Mqtt.h, System.cpp, System.h]
2019-09-05 fix MQTT connection issue
    [Main.cpp]
2019-09-06 updated filename convention
    [002001-002.SLDPRT, 002001-003.SLDPRT, 002001-003.STL, 002002-002.SLDPRT, 002002-003.SLDPRT, 002003-003.SLDPRT, 002003-003.STL, 002003-004.SLDPRT]
2019-09-06 save MQTT config on EEPROM
    [CONFIG.TXT]
2019-09-07 cleanup code
    [CONFIG.TXT]
2019-09-10 these two have hologram so updated config
    [CONFIG.TXT]
2019-09-10 make sure can bus data less than delta will be tx
    [CONFIG.TXT]
2019-09-12 batch can bus telemetry
2019-09-12 add timestamp to the crash report
    [Main.cpp]
2019-09-13 switch to a smaller Base64 lib
2019-09-18 move BLESPI definition back to arduino_bluenrg_ble
2019-09-18 change inRide to ignitionOn in CONFIG.TXT
    [CONFIG.TXT]
2019-09-18 fix can bus batch report
    [Can.cpp, Crash.cpp, Logger.cpp, System.cpp, System.h]
2019-09-19 use Arduino version of SD
2019-09-21 1.2.1 fixing mqtt cmd delay issue
    [Cellular.cpp, Main.cpp, Mqtt.cpp, System.cpp]
2019-09-22 1.2.2 MCU low-power mode turned on for release
2019-09-26 1.2.3 remove Mqtt.poll from setup()
    [CONFIG.TXT]
2019-10-02 use hashmaps for can bus status to avoid memory leak
    [Can.cpp, Main.cpp, Motion.cpp, System.cpp, System.h]
2019-10-03 handle System.sleep() interruption
2019-10-10 not to retry if can bus returns error
    [Bluetooth.cpp, Can.cpp, Cellular.cpp, Main.cpp, System.cpp]
2019-10-11 fix canbus ignition detection
    [Can.cpp, Cellular.cpp, Mqtt.cpp, System.cpp, System.h]
2019-10-15 attempt to fix mqtt delay issue
    [Cellular.cpp, ECCX08CSR.ino, Main.cpp, Mqtt.cpp]
2019-10-17 improve Modem check
    [CONFIG.TXT]
2019-10-17 005 hardware revision
    [001000-005.brd, 001000-005.sch]
2019-10-23 fix invalid heartbeat json
    [Cellular.cpp, Gps.cpp, Gps.h, Mqtt.cpp, System.cpp]
2019-10-25 1.3.2 disable sleeping; clean up
    [CONFIG.TXT]
2019-10-28 change lock_rear to lock_back to be consistent
    [CONFIG.TXT]
2019-10-28 fix door_back_left and right
    [CONFIG.TXT]
2019-12-18 fixed the condition where we lost AT in the middle of operation, issue 73
    [Cellular.cpp]
2019-12-19 -005 board updates
    [001000-004BOM627formatted.xlsx, 001000-005.sch]
2020-02-06 DFM ready (draft) without some updates
    [002001-005.SLDPRT]
2020-02-06 DFM ready case bottom
    [002002-005.SLDPRT]
2020-02-06 Top and bottom, no DFM, small USB port, wider coax
    [002001-006.STL, top_w_logo_7.STL]
2020-02-20 Latest revision
    [002001-007.SLDPRT, 002001-007.STL, 002002-007.SLDPRT, 002003-007.SLDPRT, 002004-007.SLDPRT, 002004-007.STL, waive-work-logo_w_good.dxf]
