WaiveCar/WaiveTelem/(notices)

Notices in the files:
parts and their libraries:
rc-master: Copyright (C) 2007, Bob Starr
